Happenedspice17/sumo-v-ia/chasis/img/det_arnes.png

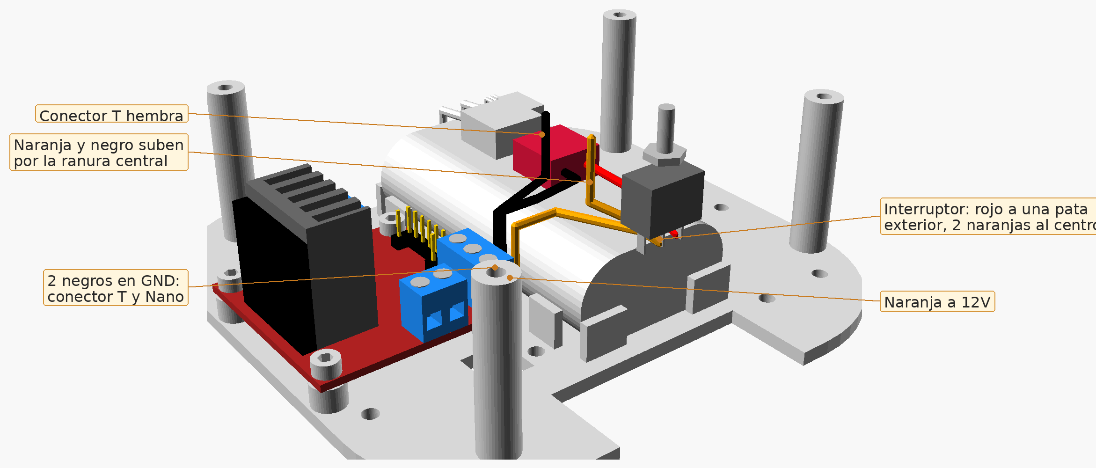
chasis/img/det_arnes.png
