Happenedspice17/sumo-v-ia/chasis/img/det_insertos.png

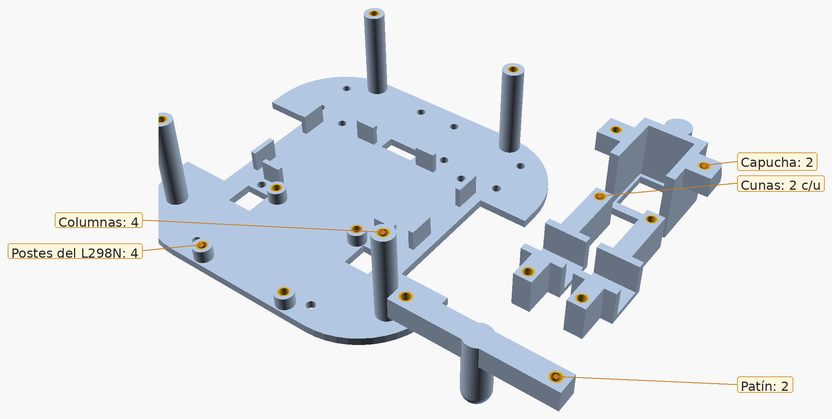
chasis/img/det_insertos.png
