Happenedspice17/sumo-v-ia/chasis/img/det_l298.png

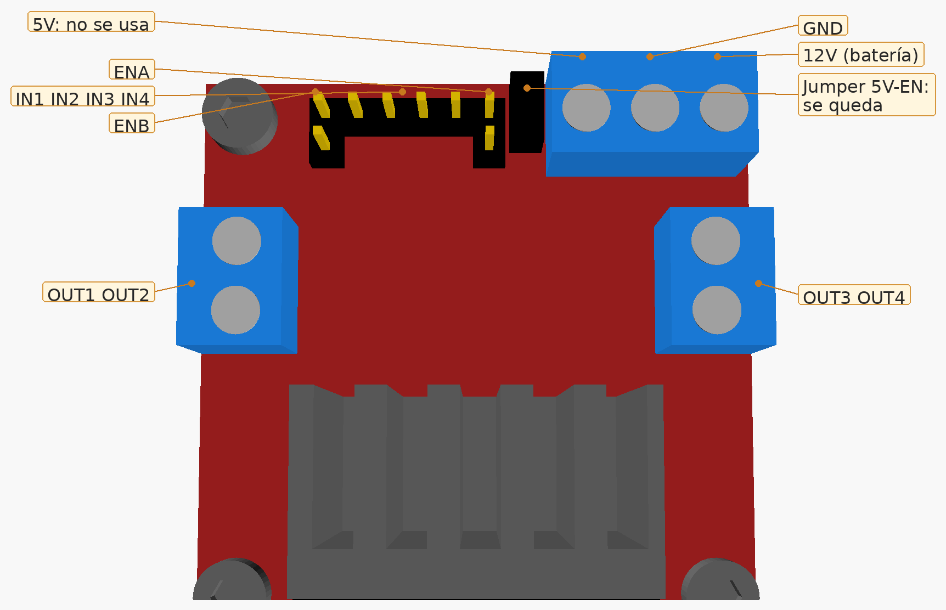
chasis/img/det_l298.png
