Happenedspice17/sumo-v-ia/chasis/img/det_q_usb.png

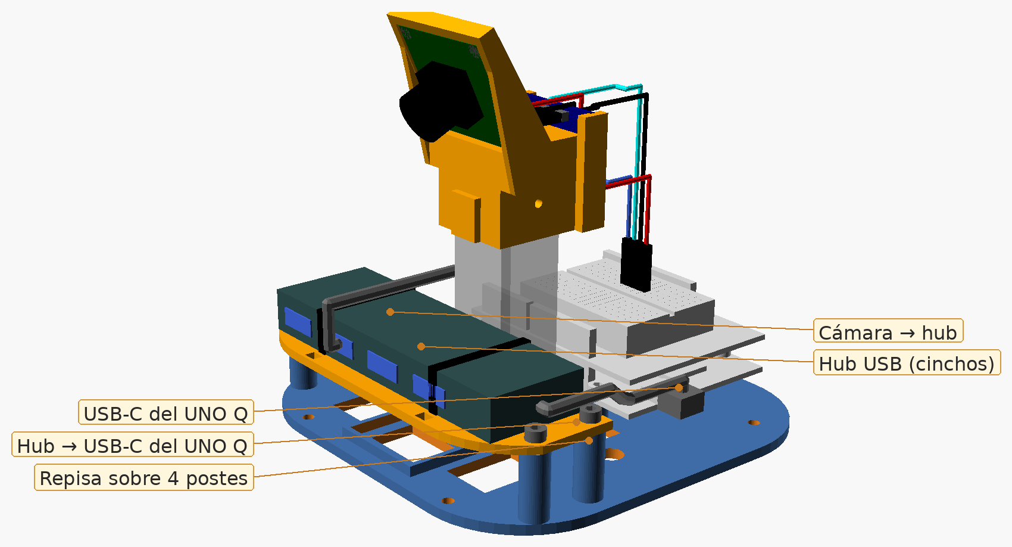
chasis/img/det_q_usb.png
