Happenedspice17/sumo-v-ia/chasis/img/det_shield.png

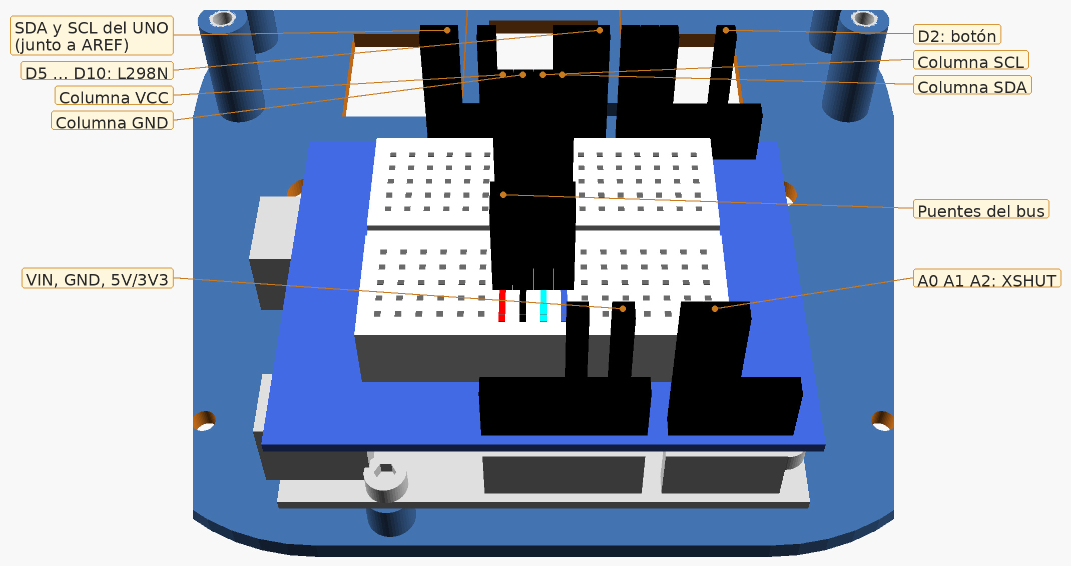
chasis/img/det_shield.png
