Happenedspice17/sumo-v-ia/chasis/img/detalle_oled.png

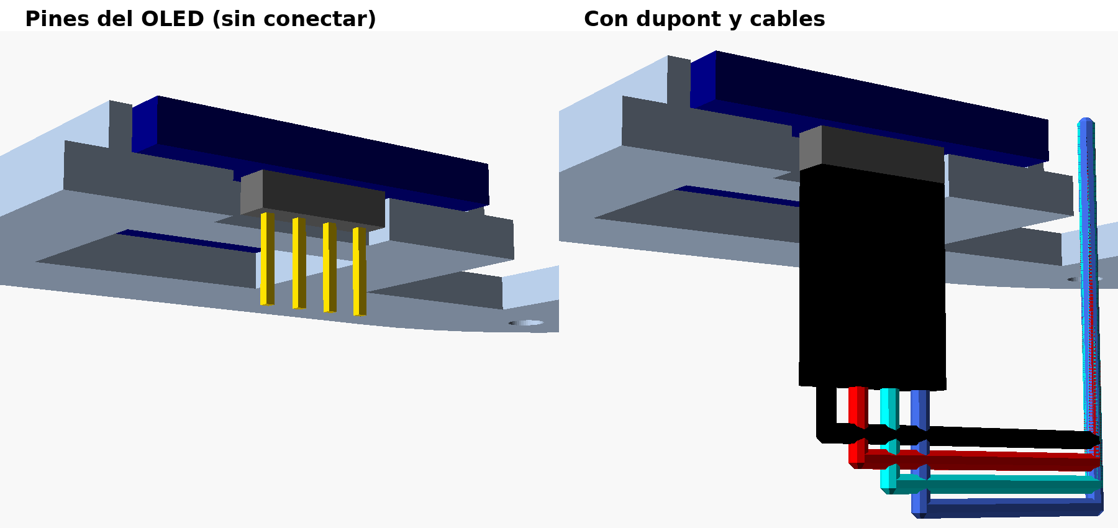
chasis/img/detalle_oled.png
