Happenedspice17/sumo-v-ia/chasis/img/fig_atras.png

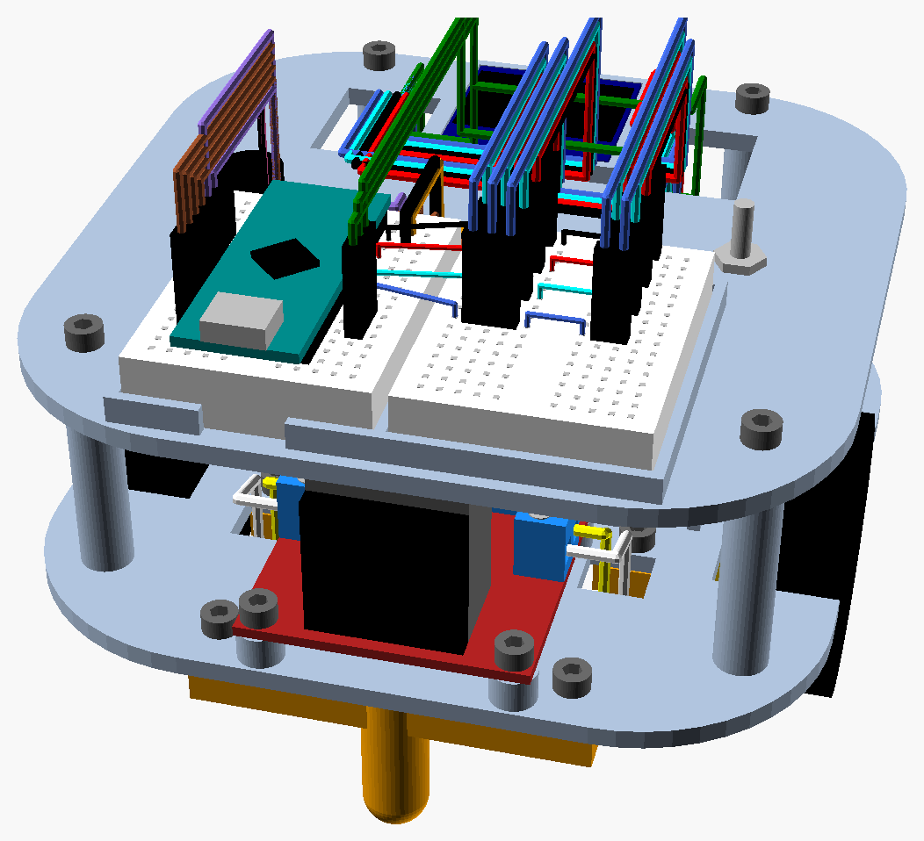
chasis/img/fig_atras.png
