Happenedspice17/sumo-v-ia/chasis/img/fig_lado.png

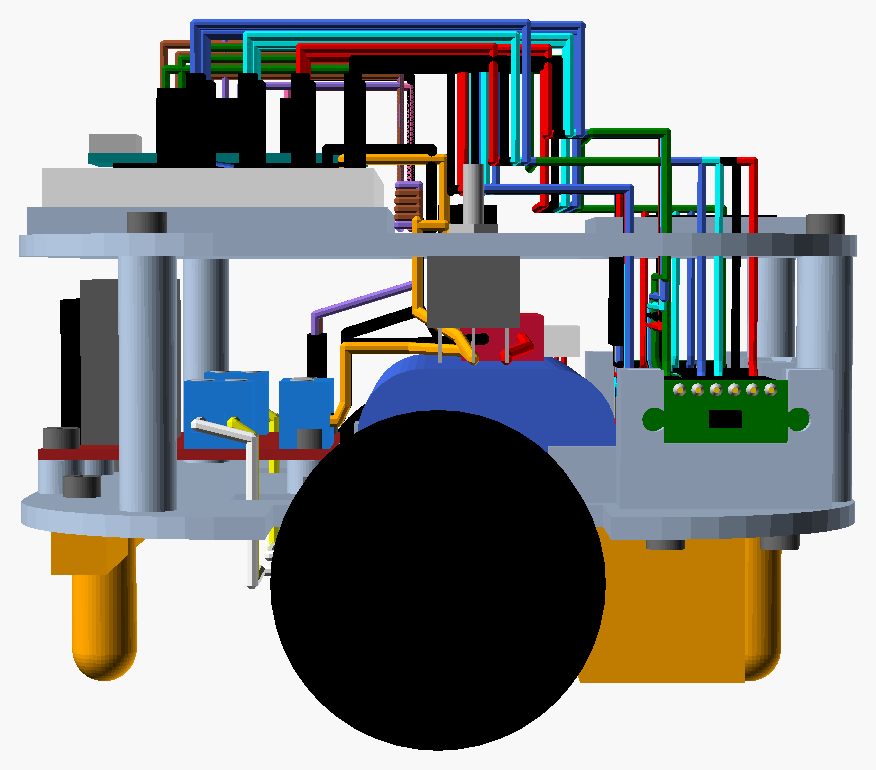
chasis/img/fig_lado.png
