Happenedspice17/sumo-v-ia/chasis/img/paso1.png

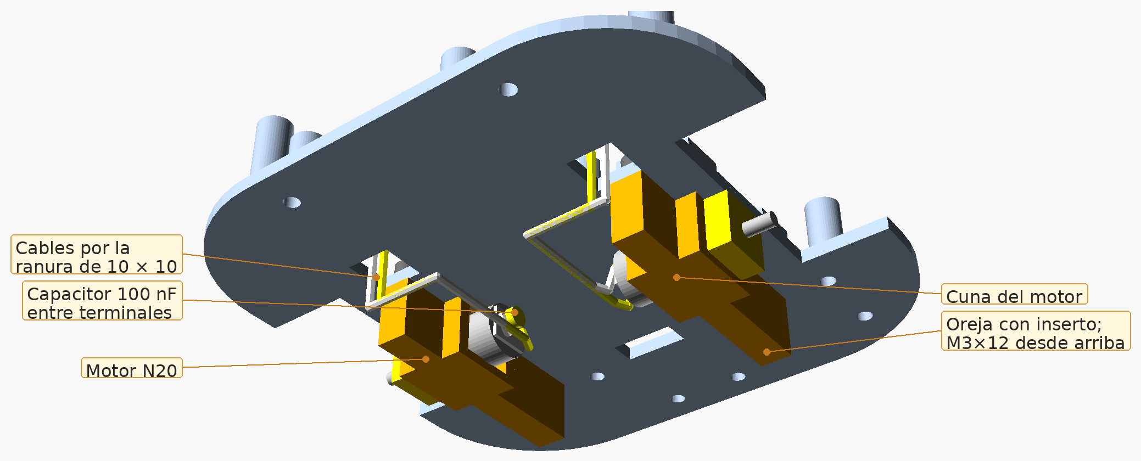
chasis/img/paso1.png
