Happenedspice17/sumo-v-ia/chasis/img/paso2.png

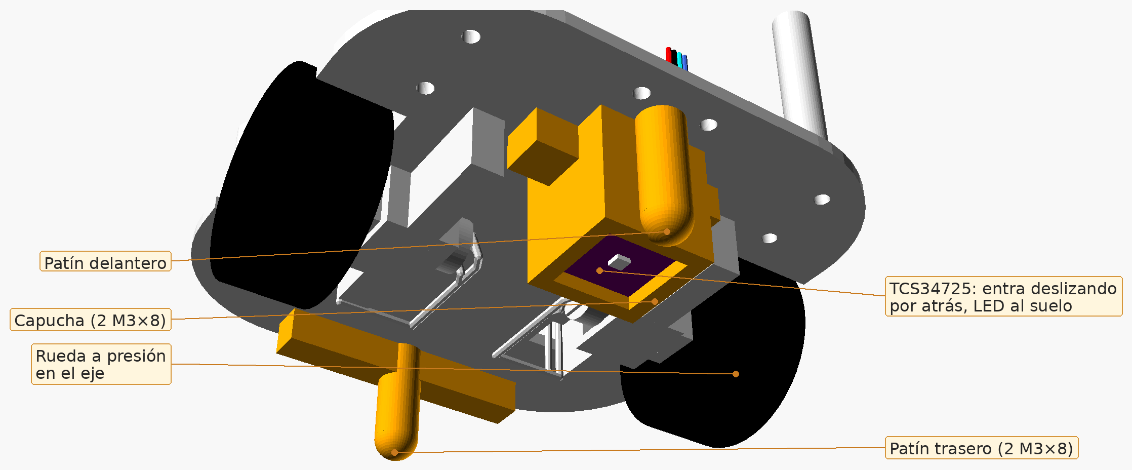
chasis/img/paso2.png
