Happenedspice17/sumo-v-ia/chasis/img/paso3.png

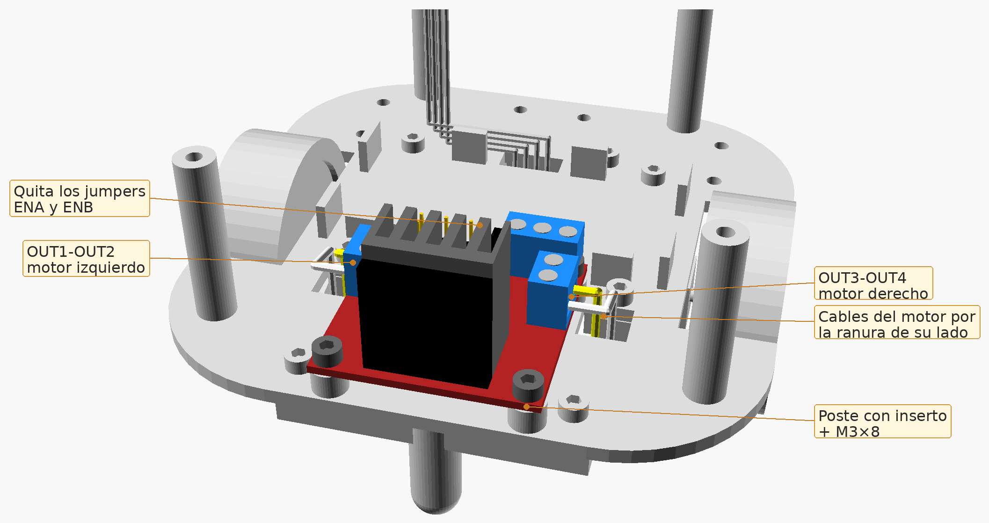
chasis/img/paso3.png
