Happenedspice17/sumo-v-ia/chasis/img/paso4.png

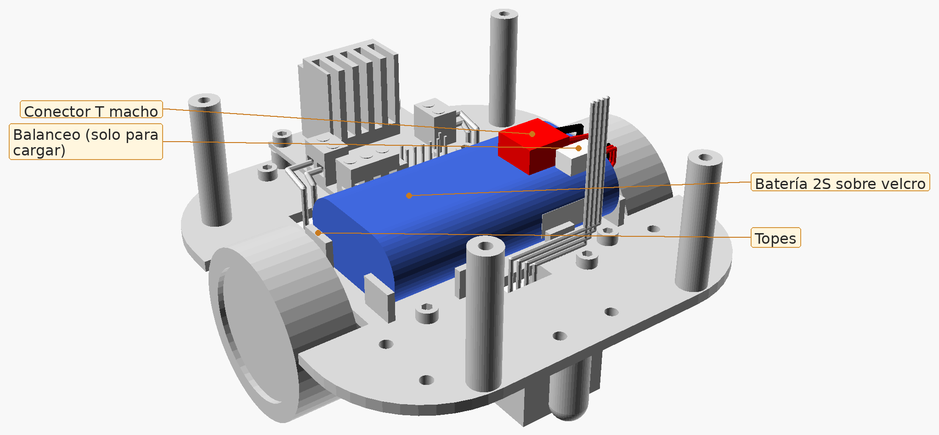
chasis/img/paso4.png
