Happenedspice17/sumo-v-ia/chasis/img/paso5.png

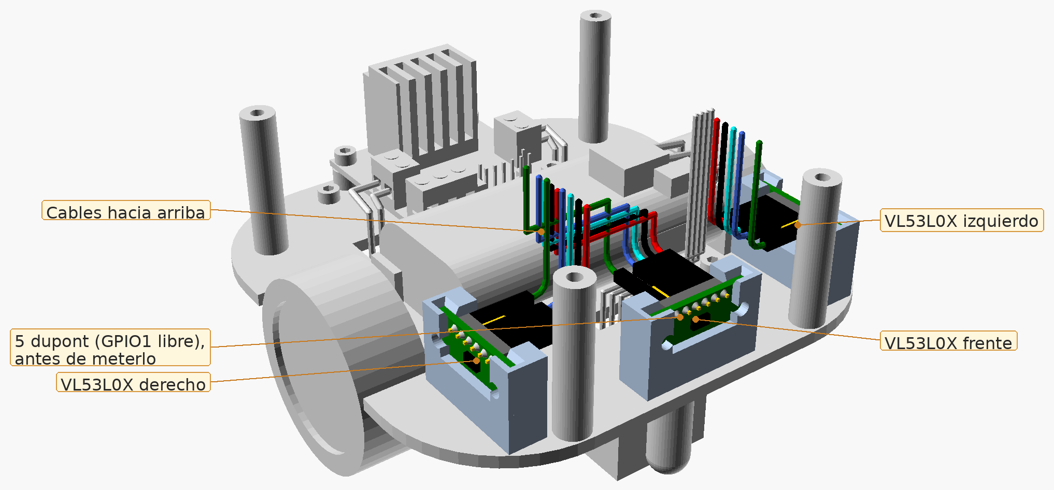
chasis/img/paso5.png
