Happenedspice17/sumo-v-ia/chasis/img/paso6.png

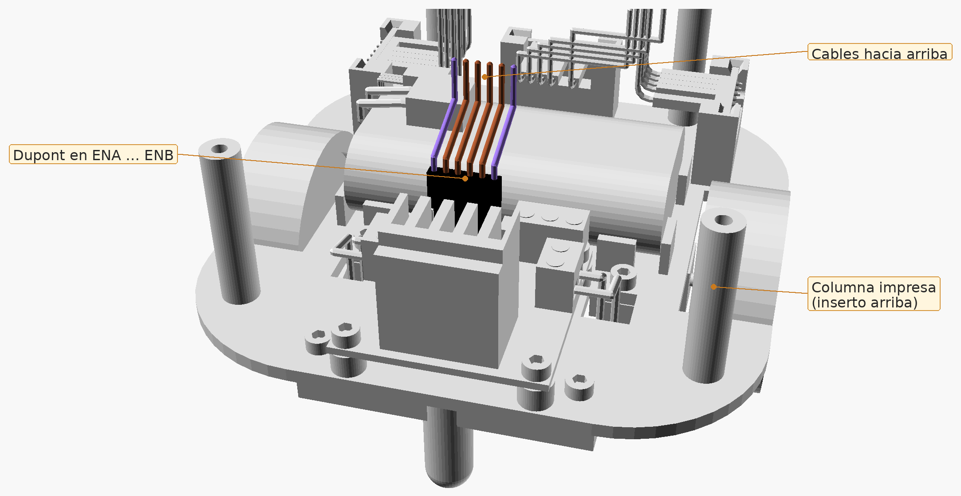
chasis/img/paso6.png
