Happenedspice17/sumo-v-ia/chasis/img/paso7.png

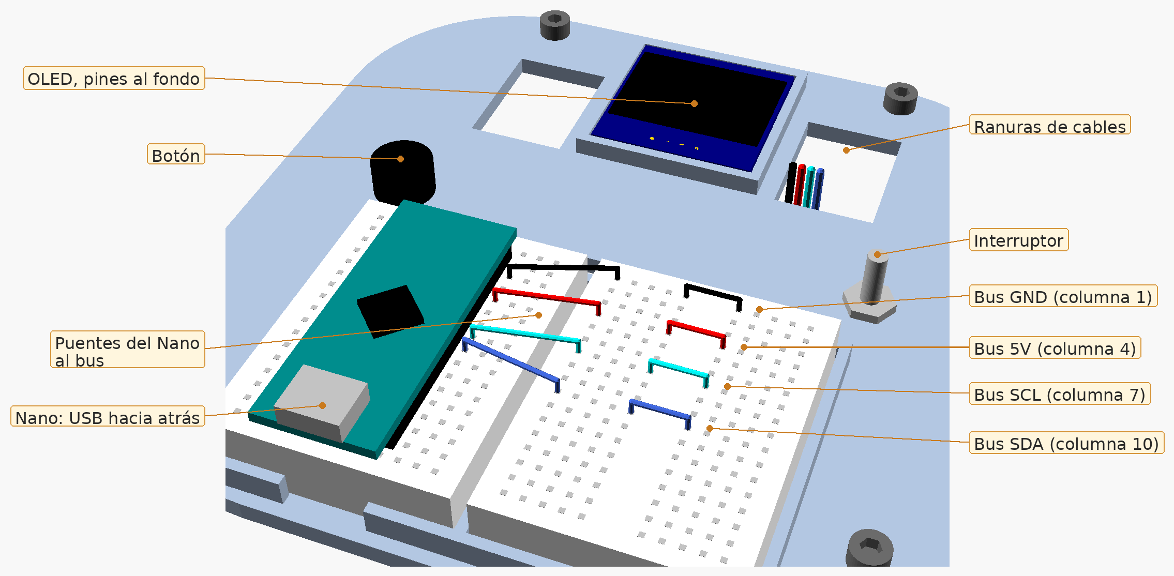
chasis/img/paso7.png
