Happenedspice17/sumo-v-ia/chasis/img/paso8.png

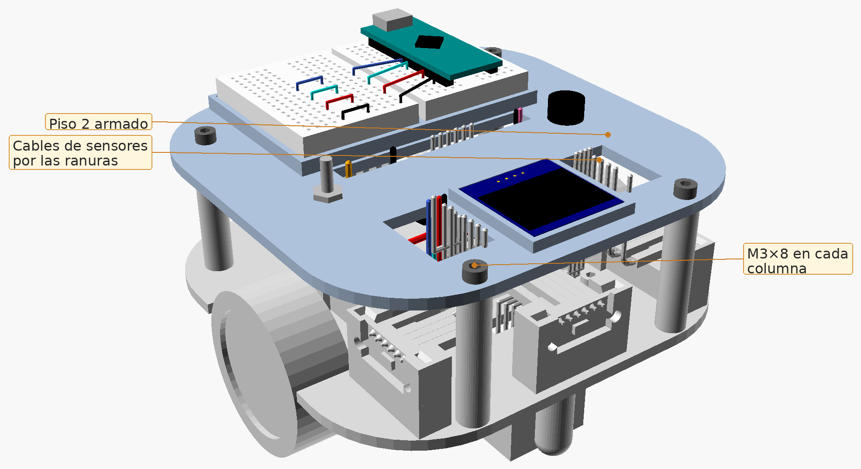
chasis/img/paso8.png
