Happenedspice17/sumo-v-ia/chasis/img/paso9.png

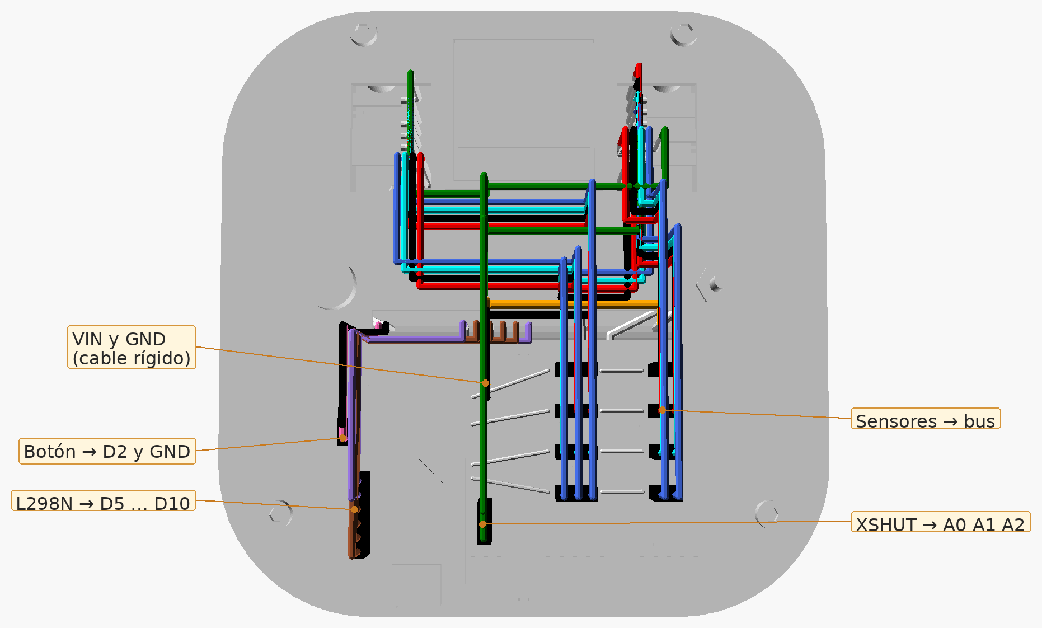
chasis/img/paso9.png
