Happenedspice17/sumo-v-ia/chasis/img/paso10.png

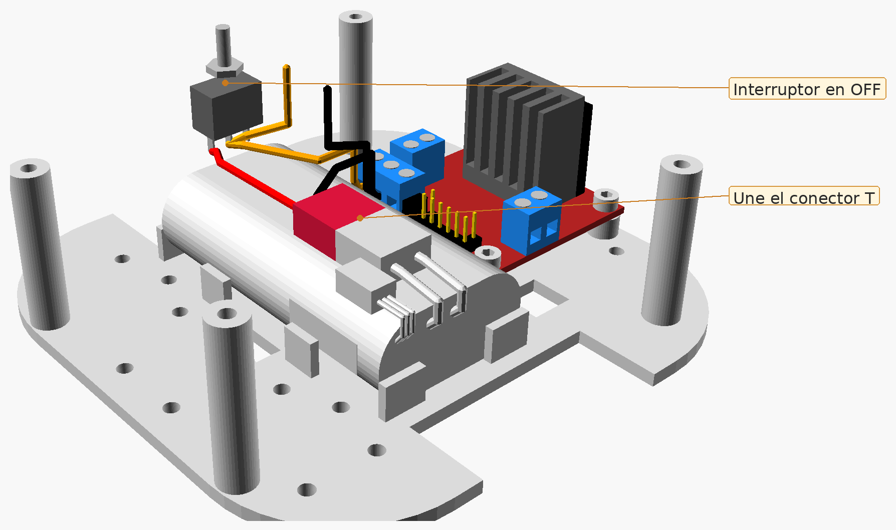
chasis/img/paso10.png
