Happenedspice17/sumo-v-ia/chasis/img/placa_x2d.png

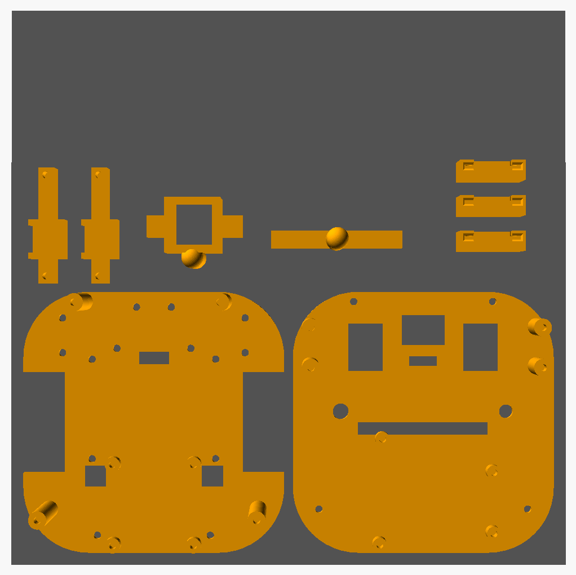
chasis/img/placa_x2d.png
