Happenedspice17/sumo-v-ia/chasis/img/q_lado.png

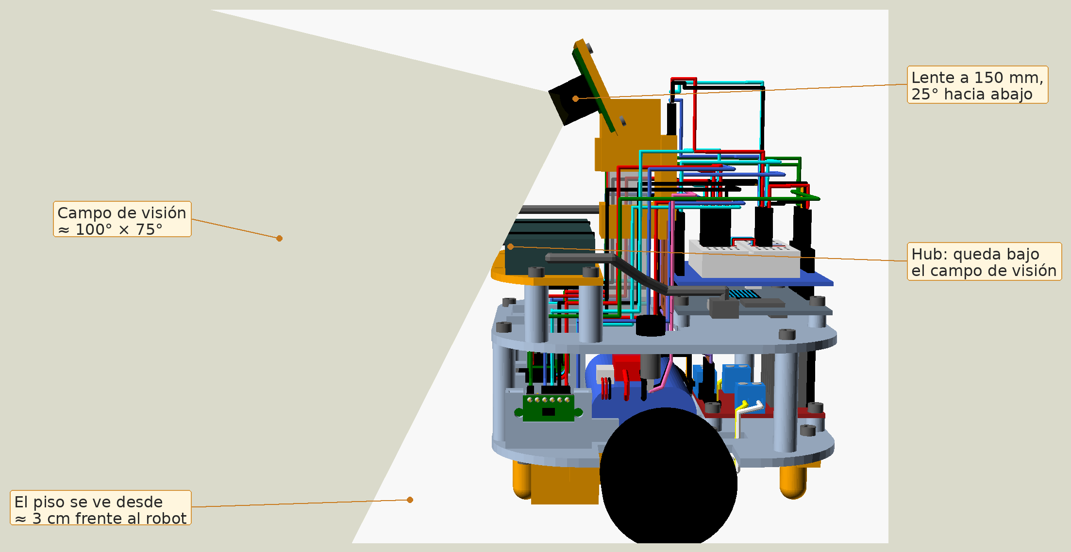
chasis/img/q_lado.png
