Happenedspice17/sumo-v-ia/chasis/img/q_paso11.png

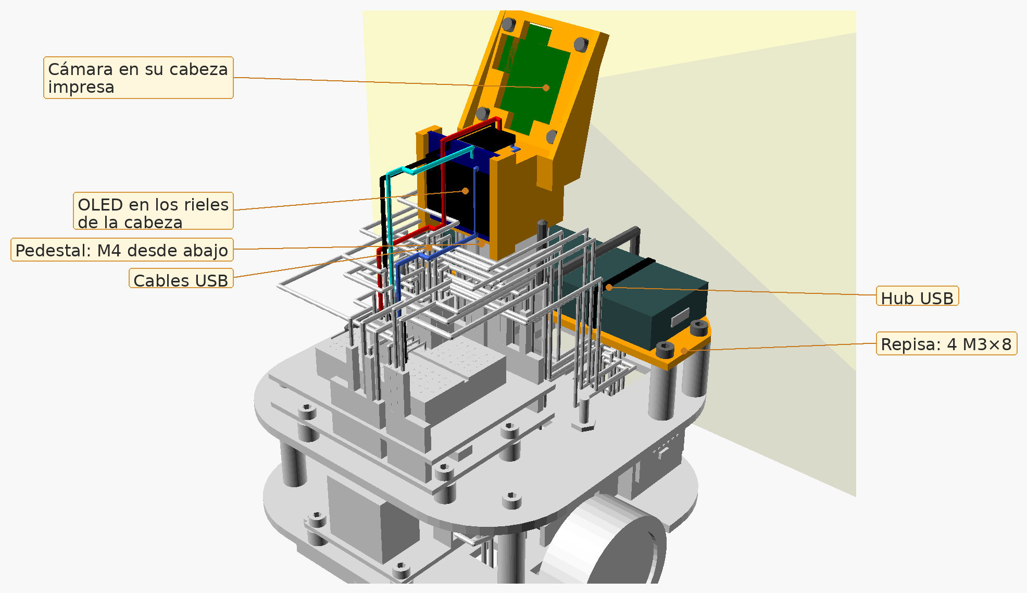
chasis/img/q_paso11.png
