Happenedspice17/sumo-v-ia/chasis/img/r3_atras.png

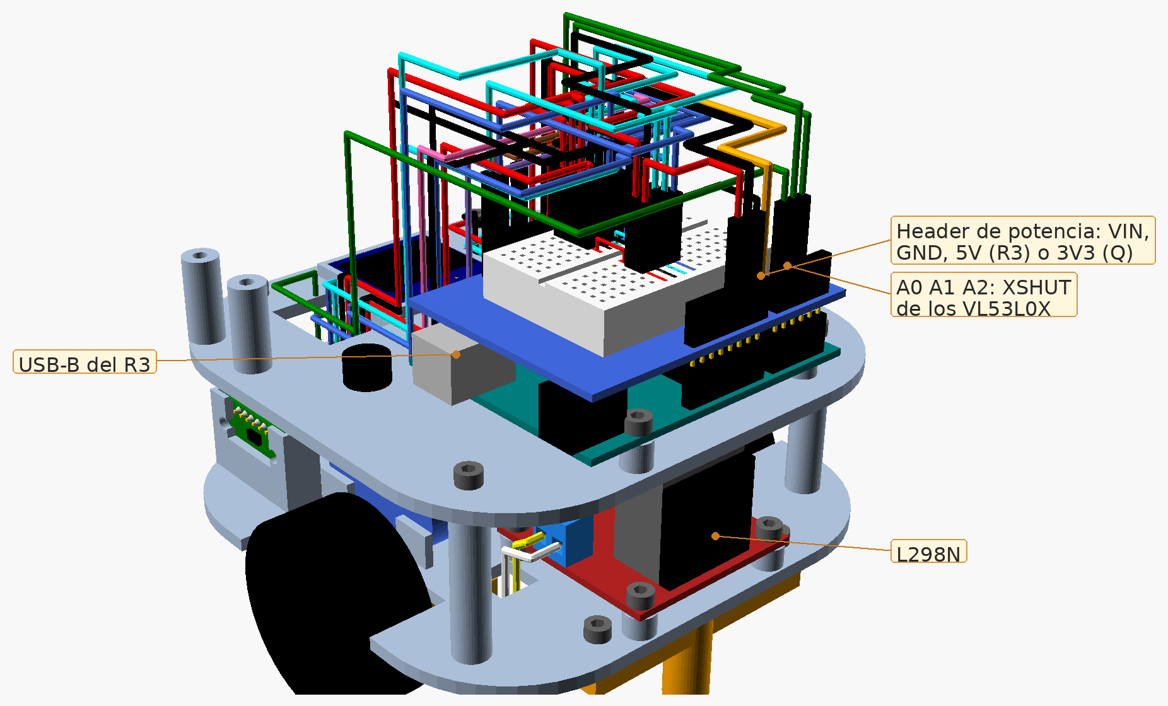
chasis/img/r3_atras.png
