Happenedspice17/sumo-v-ia/chasis/img/r3_iso.png

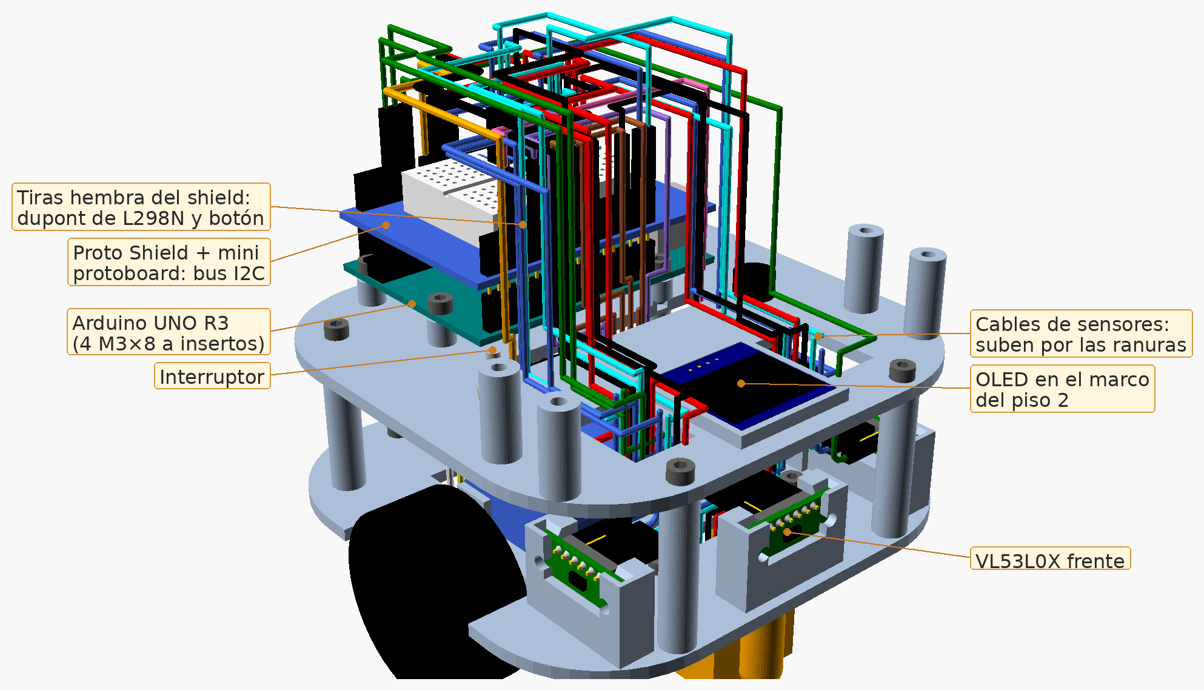
chasis/img/r3_iso.png
