Happenedspice17/sumo-v-ia/chasis/img/r3_paso7.png

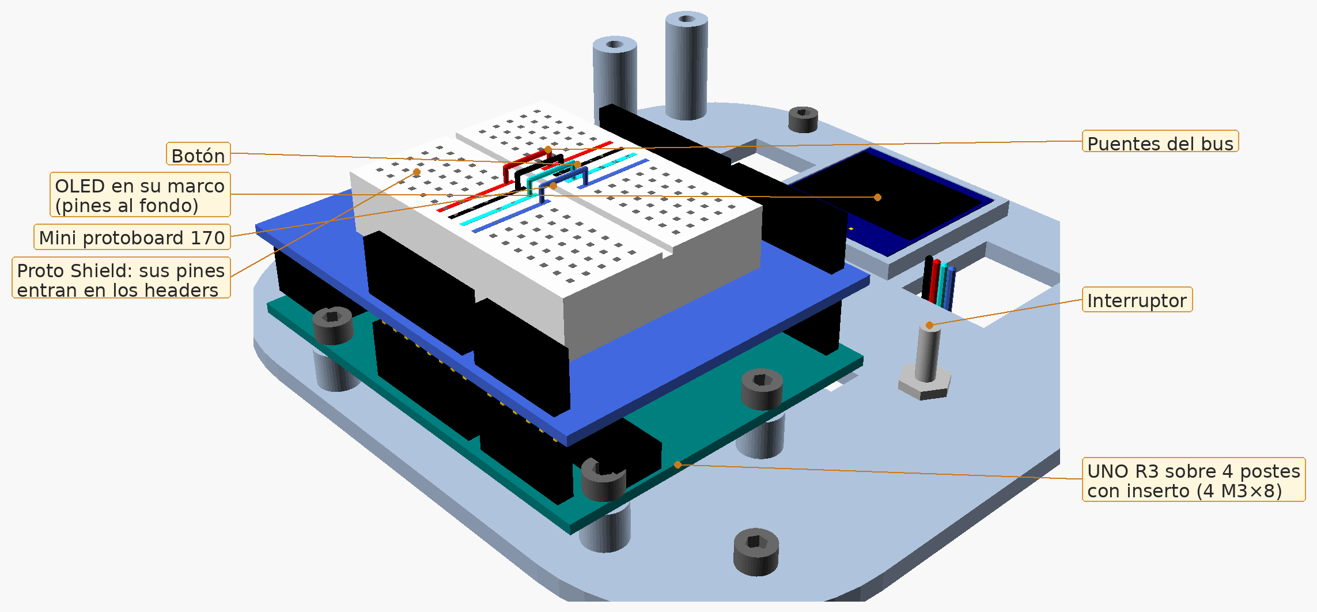
chasis/img/r3_paso7.png
