Happenedspice17/sumo-v-ia/chasis/img/r3_paso8.png

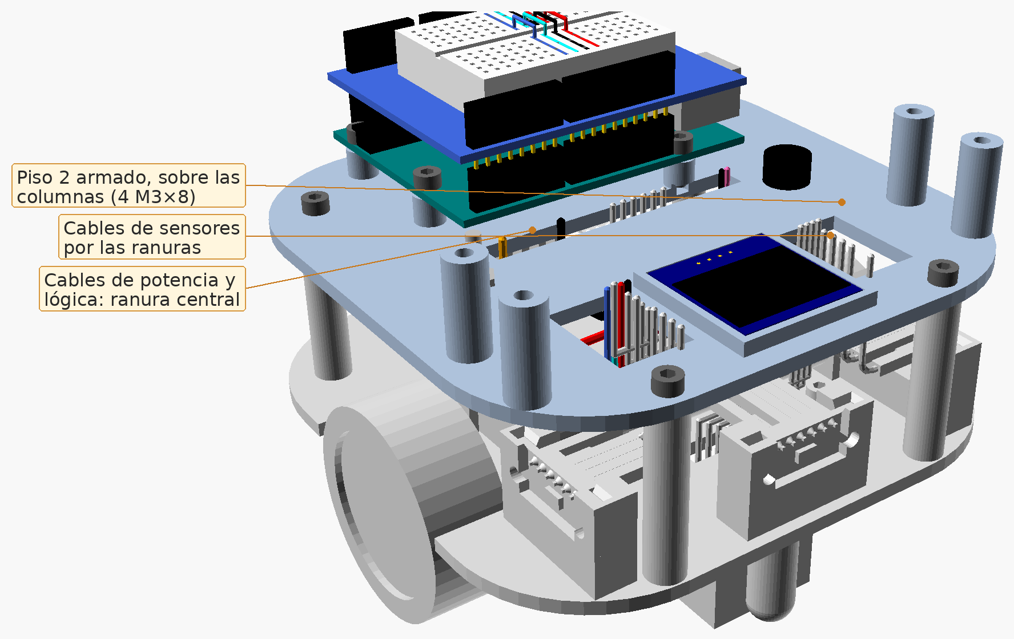
chasis/img/r3_paso8.png
