Happenedspice17/sumo-v-ia/chasis/img/r3_paso9.png

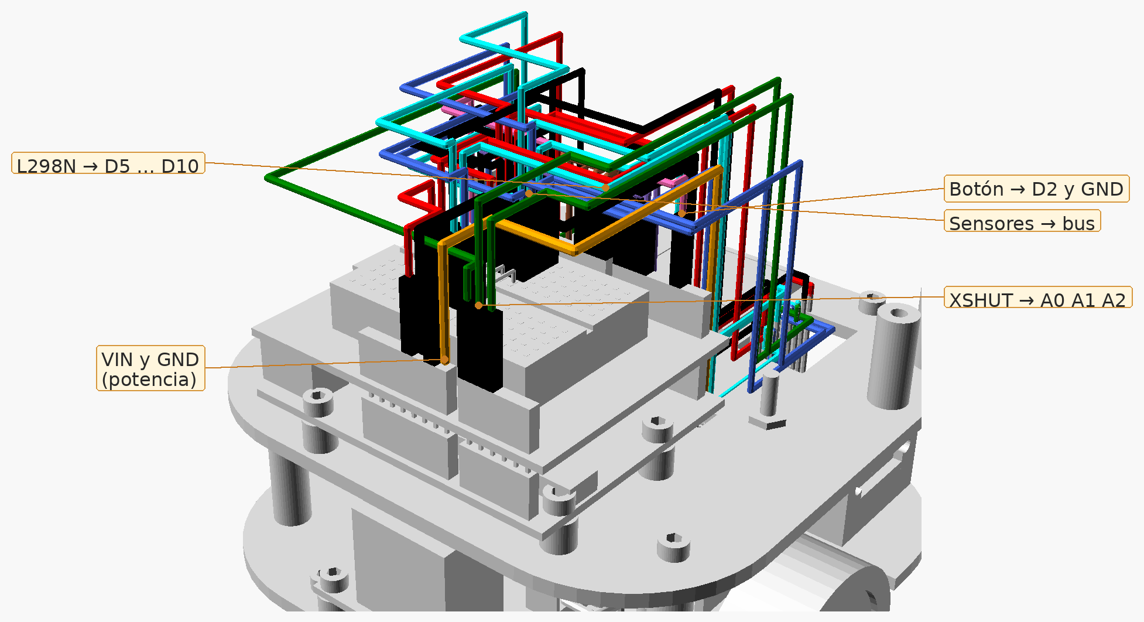
chasis/img/r3_paso9.png
