Happenedspice17/sumo-v-ia/chasis/img/r3_paso10.png

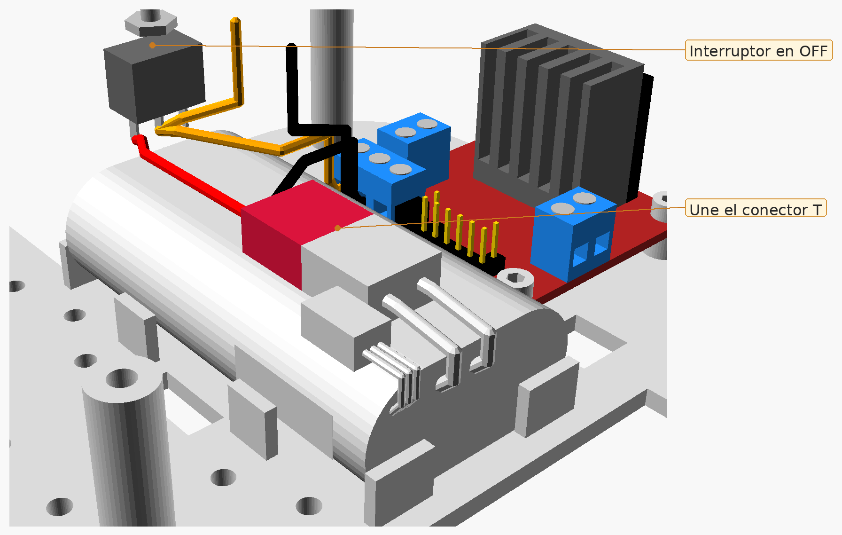
chasis/img/r3_paso10.png
