Happenedspice17/sumo-v-ia/docs/img/capturas/antes.png

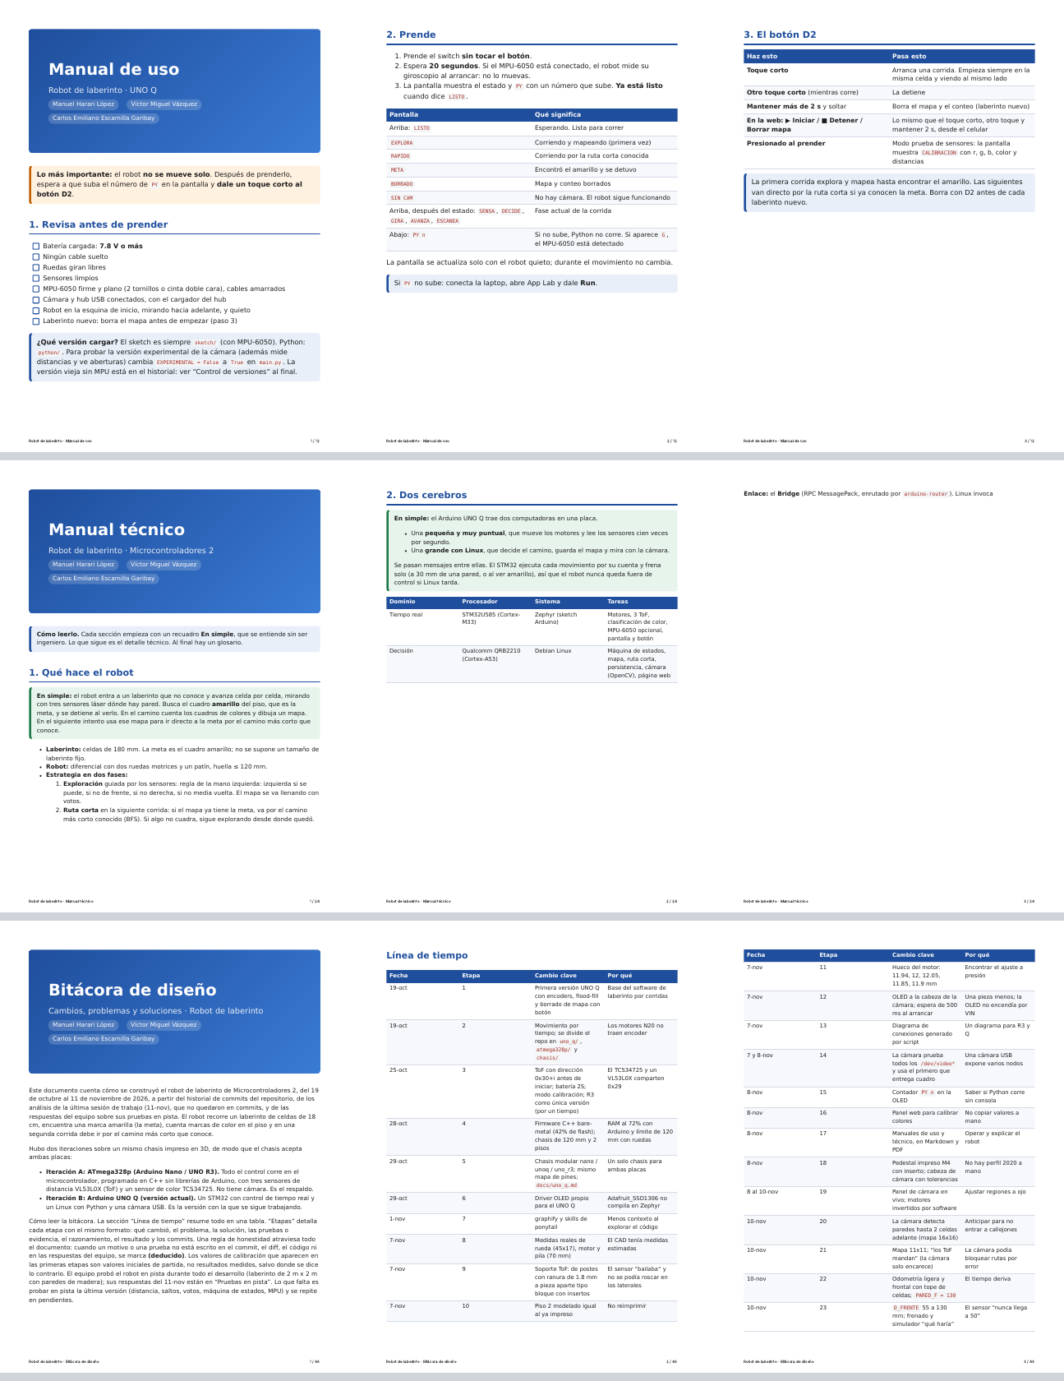
docs/img/capturas/antes.png
