Happenedspice17/sumo-v-ia/docs/img/capturas/despues.png

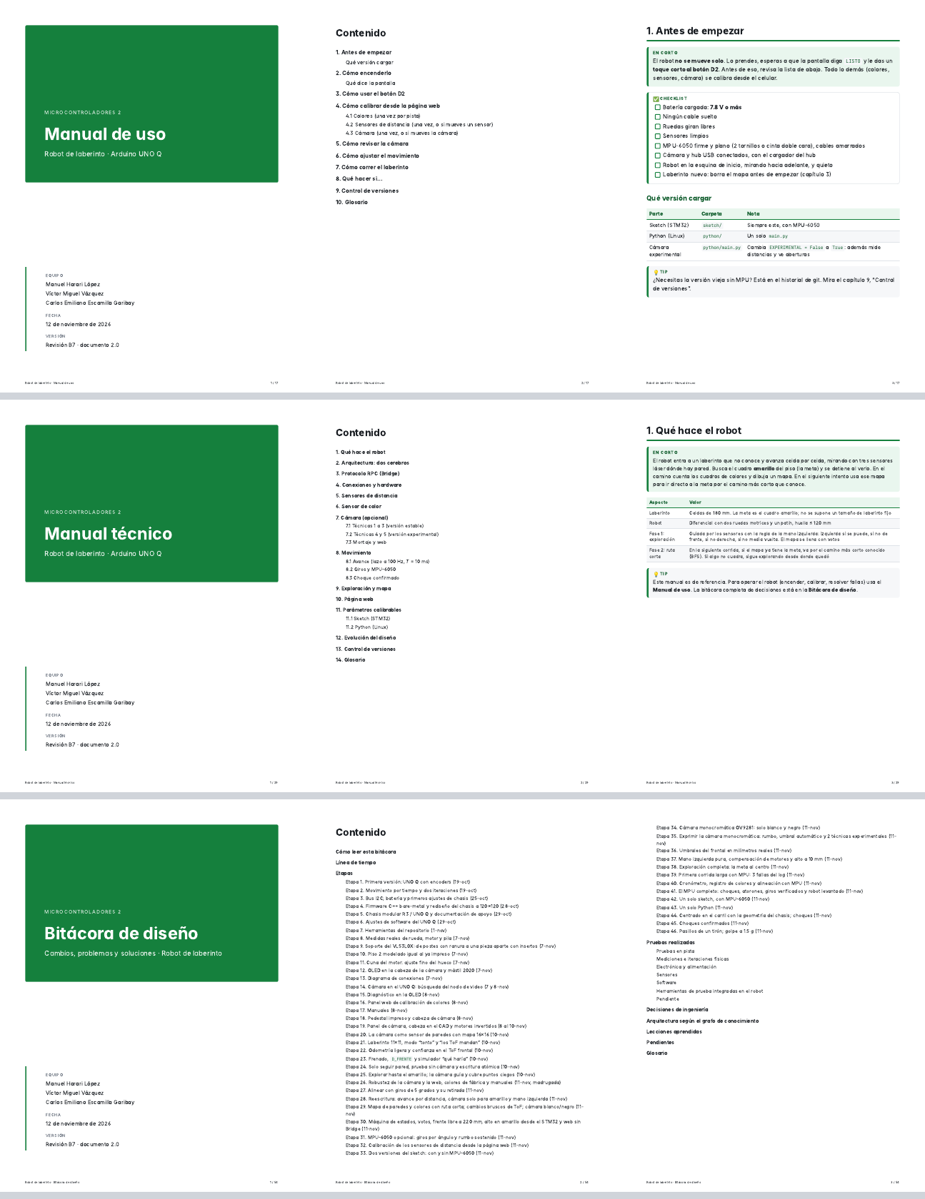
docs/img/capturas/despues.png
