Happenedspice17/sumo-v-ia/docs/img/pista_foto.jpg

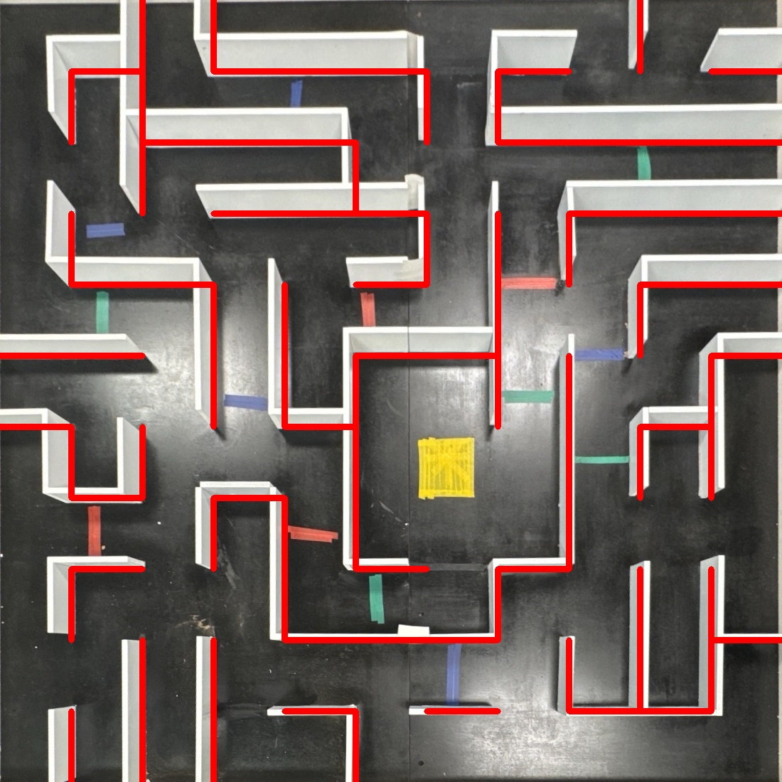
docs/img/pista_foto.jpg
