Happenedspice17/sumo-v-ia/docs/bom.csv

Categoria | Componente | Especificacion / donde va | Cantidad
Impresa 3D | Piso 1 (base, columnas, postes del L298N, soportes de VL53L0X y topes) | PETG o PLA | 1
Impresa 3D | Piso 2 (marco del OLED, alojamiento de la placa, botón, interruptor, agujero M5 del pedestal) | PETG o PLA | 1
Impresa 3D | Cuna de motor | PETG o PLA | 2
Impresa 3D | Capucha del sensor de color con patín delantero | PLA negro | 1
Impresa 3D | Patín trasero | PETG o PLA | 1
Impresa 3D | Soporte de VL53L0X (se cambia solo si se rompe) | PLA negro | 3
Impresa 3D | Pieza de prueba de tolerancias | El mismo de las demás | 1
Impresa 3D | Repisa del hub USB (solo Q) | PETG o PLA | 1
Impresa 3D | Cabeza de cámara con rieles del OLED (solo Q) | PETG o PLA | 1
Impresa 3D | Pedestal 20 × 20 × 75 mm (solo Q) | PETG o PLA | 1
Electronica | Arduino UNO R3 (ATmega328P) | Placa oficial y de respaldo; cable USB-B de datos | 1
Electronica | Arduino UNO Q (solo Q) | Placa principal; cable USB-C de datos | 1
Electronica | Proto Shield comercial | Con mini protoboard de 170 puntos; va sobre la placa | 1
Electronica | Motorreductor N20 | 6 V, 300–500 RPM, sin encoder | 2
Electronica | Rueda para N20 | Ø45 × 17 mm, eje D de 3 mm | 2
Electronica | Puente H L298N | Módulo rojo 43 × 43 mm con disipador | 1
Electronica | Sensor de color TCS34725 | Módulo morado 20.5 × 20.5 mm | 1
Electronica | Sensor de distancia VL53L0X | CJVL53L0XV2, 25 × 10.7 mm | 3
Electronica | Pantalla OLED SSD1306 | 0.96", I2C, dirección 0x3C, 4 pines | 1
Electronica | MPU-6050 (módulo GY-521) | Giroscopio y acelerómetro I2C, dirección 0x68 (AD0 a GND), VCC 3.3 V; plano y atornillado al piso | 1
Electronica | Botón de panel | Ø7 mm, normalmente abierto | 1
Electronica | Interruptor de palanca | MTS-102, Ø6 mm | 1
Electronica | Batería 2S 18650 | 7.4 V, 3000 mAh, conector T y balanceo JST-XH | 1
Electronica | Conector T (Deans) hembra | Con 10 cm de cable calibre 14–16 | 1
Electronica | Cargador balanceador 2S | Entrada JST-XH de 3 pines | 1
Electronica | Fusible de 3 A con portafusible | En el positivo, después del interruptor | 1
Electronica | Capacitor cerámico | 100 nF (104) | 2
Electronica | Header macho recto | 2.54 mm, tira de 40 (los rectos de siempre) | 1
Electronica | Cámara USB innomaker U20CAM-9281M (solo Q) | OV9281 monocromática 1 MP, obturador global, UVC, lente M12 gran angular; medidas de la placa por confirmar | 1
Electronica | Cable USB-C corto en ángulo recto (solo Q) | Del hub a la entrada USB-C de la UNO Q | 1
Electronica | Hub USB-C con entrada PD (solo Q) | USB-C macho, 1 USB-A de datos y entrada de alimentación | 1
Electronica | Inserto de calor M4 + tornillo M4 × 12 (solo Q) | Pedestal al piso 2, desde abajo | 1
Electronica | Módulo fuente USB-C PD, opcional (solo Q) | Entrada desde 6 V, salida 5 V / 3 A; solo si falla la prueba sin PD (sección 6.4) | 1
Cables | Dupont hembra-macho 30 cm | VL53L0X (3 × 5), OLED (4), L298N lógica (6) + 2 de repuesto | 27
Cables | Dupont macho-macho 30 cm | Se les corta un extremo: TCS34725 (4) y botón (2) | 6
Cables | Cable calibre 22 de silicón, rojo, negro, amarillo, blanco y naranja | Motores, interruptor, batería y placa | 1 m en total por color
Cables | Jumpers rígidos | Puentes del bus en la protoboard del shield y del bus a la placa | 8
Cables | Cinchos chicos y termofit de 3 mm | Ordenar cables y aislar soldaduras (la Q usa 2 más para el hub) | 12 / 30 cm
Cables | Cinta aislante | Sobre el USB-B del R3, bajo el shield | 1
Tornilleria | Inserto de calor M3 (latón) | Comunes: columnas (4) y postes del L298N (4) del piso 1, cunas (4), capucha (2), patín (2), soportes de VL53L0X (6), placa en el piso 2 (4). Solo Q: repisa (4) | 26 (+4 solo Q)
Tornilleria | Tornillo Allen M3 × 8 | Comunes: L298N (4), piso 2 (4), placa (4), capucha (2), patín (2), soportes de VL53L0X (6), VL53L0X (6). Solo Q: repisa (4) | 28 (+4 solo Q)
Tornilleria | Tornillo Allen M3 × 12 | Cunas de motor | 4
Tornilleria | Tornillo M2 + tuerca y rondana | Cámara en su cabeza (tuerca atrás) | 4 (solo Q)
Tornilleria | Tornillo M3 opresor | Cabeza contra el pedestal | 1 (solo Q)
Tornilleria | Velcro adhesivo 3 × 5 cm | Bajo la batería | 1
