Happenedspice17/sumo-v-ia/chasis/stl/cabeza_camara.stl

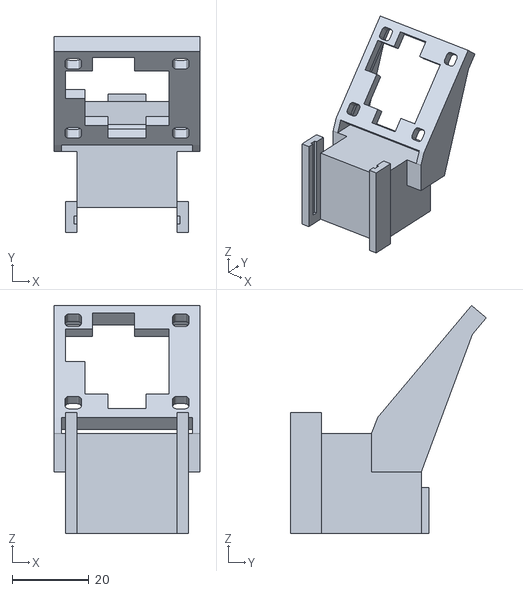
[picture p40: CAD file, 2026-11-11]
chasis/stl/cabeza_camara.stl
38.0 x 50.9 x 59.4
