Happenedspice17/sumo-v-ia/chasis/stl/pedestal.stl

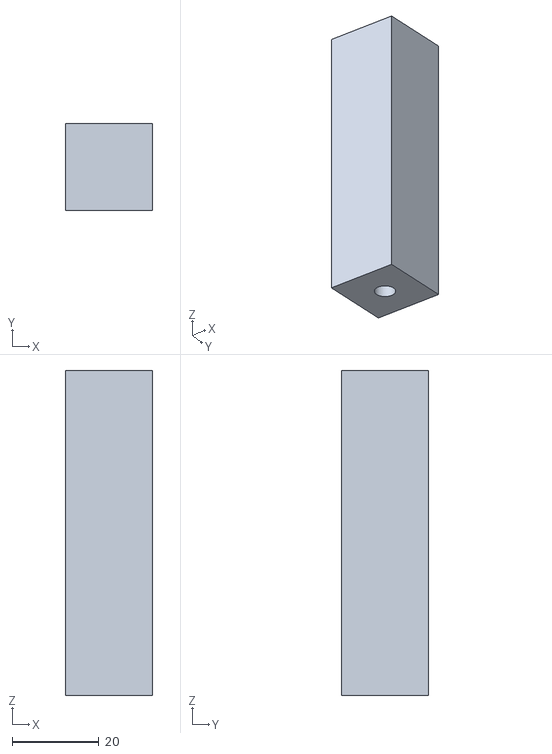
[picture p41: CAD file, 2026-11-08]
chasis/stl/pedestal.stl
20.0 x 20.0 x 75.0
