Happenedspice17/sumo-v-ia/chasis/stl/cuna_motor.stl

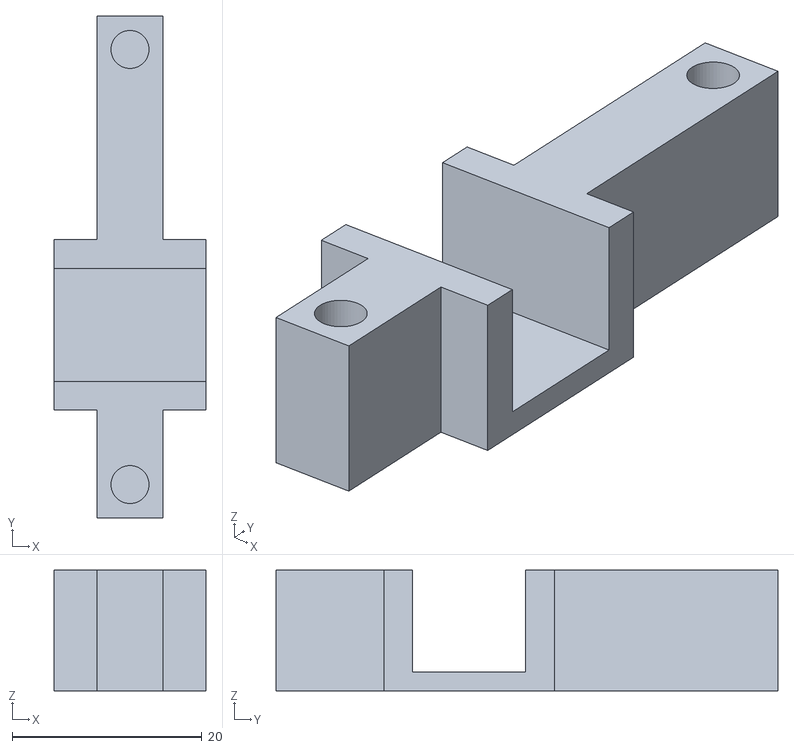
[picture p42: CAD file, 2026-11-08]
chasis/stl/cuna_motor.stl
16.0 x 52.8 x 12.7
