Happenedspice17/sumo-v-ia/chasis/stl/soporte_tof.stl

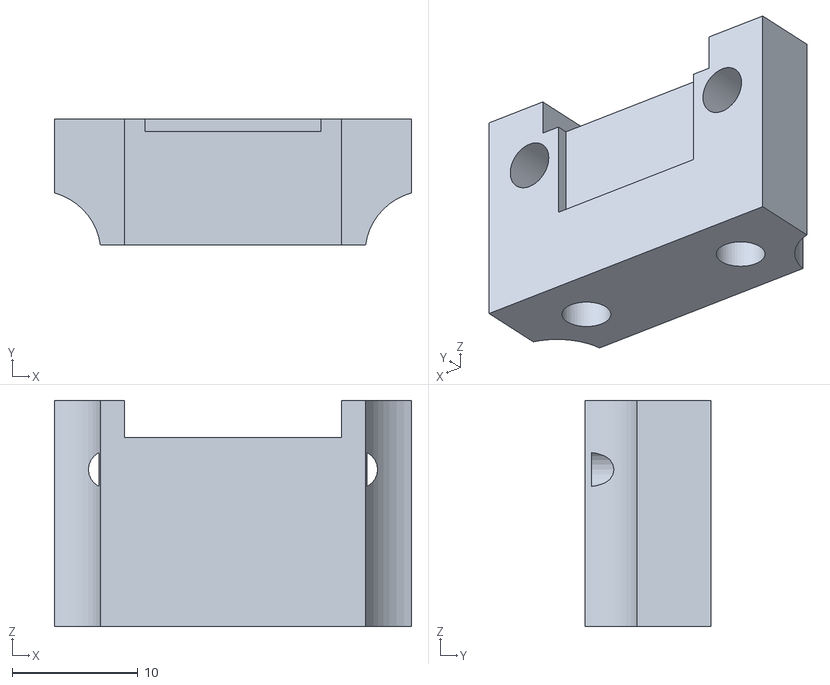
[picture p43: CAD file, 2026-11-08]
chasis/stl/soporte_tof.stl
28.4 x 10.0 x 18.0
