Happenedspice17/sumo-v-ia/chasis/stl/piso2.stl

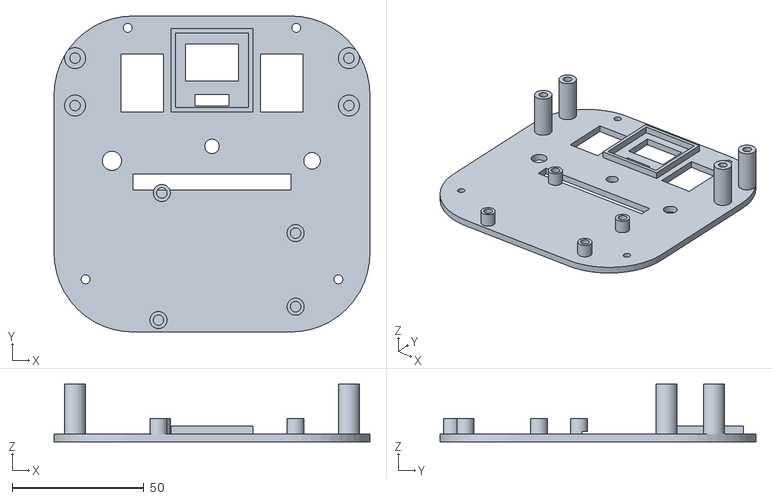
[picture p44: CAD file, 2026-11-08]
chasis/stl/piso2.stl
120.0 x 120.0 x 22.0
