Happenedspice17/sumo-v-ia/chasis/stl/piso1.stl

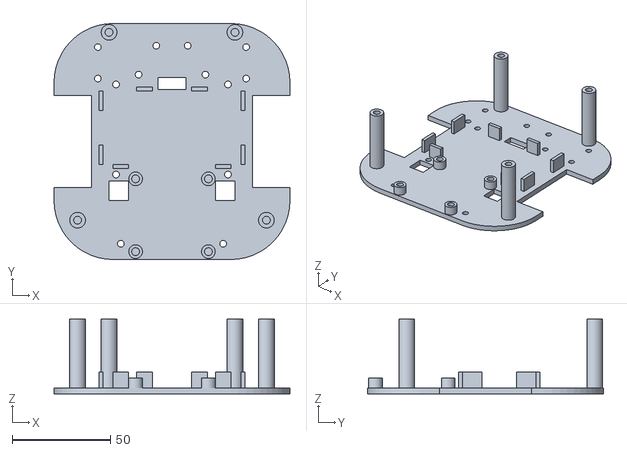
[picture p45: CAD file, 2026-11-08]
chasis/stl/piso1.stl
120.0 x 120.0 x 38.0
