Happenedspice17/sumo-v-ia/chasis/stl/repisa.stl

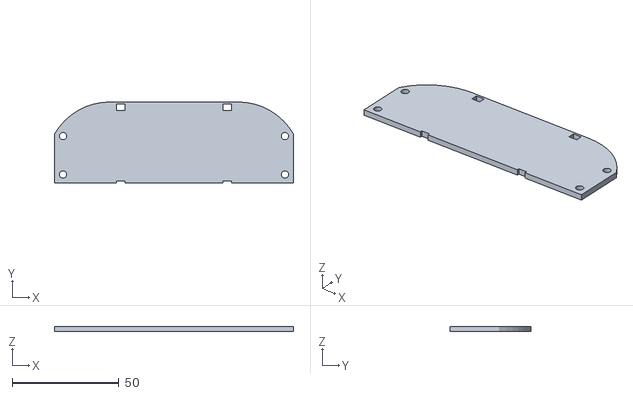
[picture p46: CAD file, 2026-11-08]
chasis/stl/repisa.stl
112.0 x 38.0 x 2.50
