Happenedspice17/sumo-v-ia/chasis/stl/capucha_color.stl

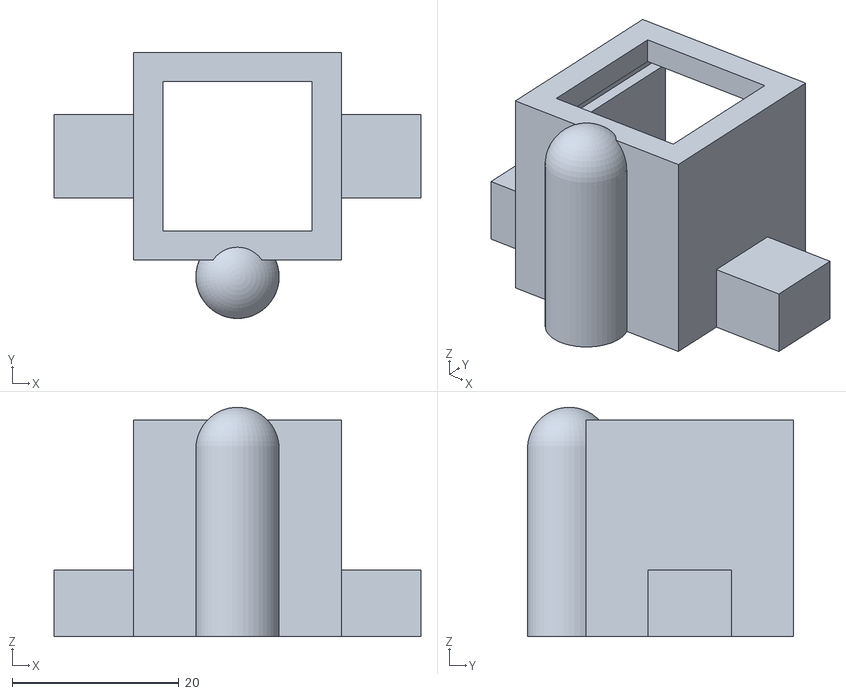
[picture p47: CAD file, 2026-11-07]
chasis/stl/capucha_color.stl
44.0 x 31.9 x 27.5
