Happenedspice17/sumo-v-ia/chasis/stl/prueba.stl

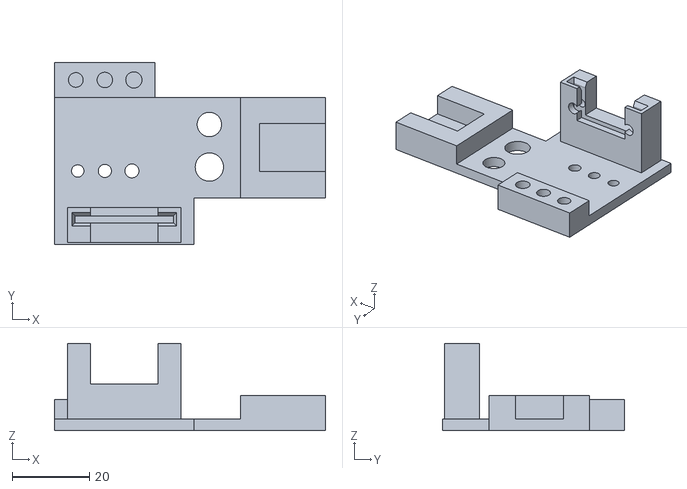
[picture p48: CAD file, 2026-11-07]
chasis/stl/prueba.stl
70.0 x 47.0 x 22.5
