Happenedspice17/sumo-v-ia/chasis/stl/placa_q.stl

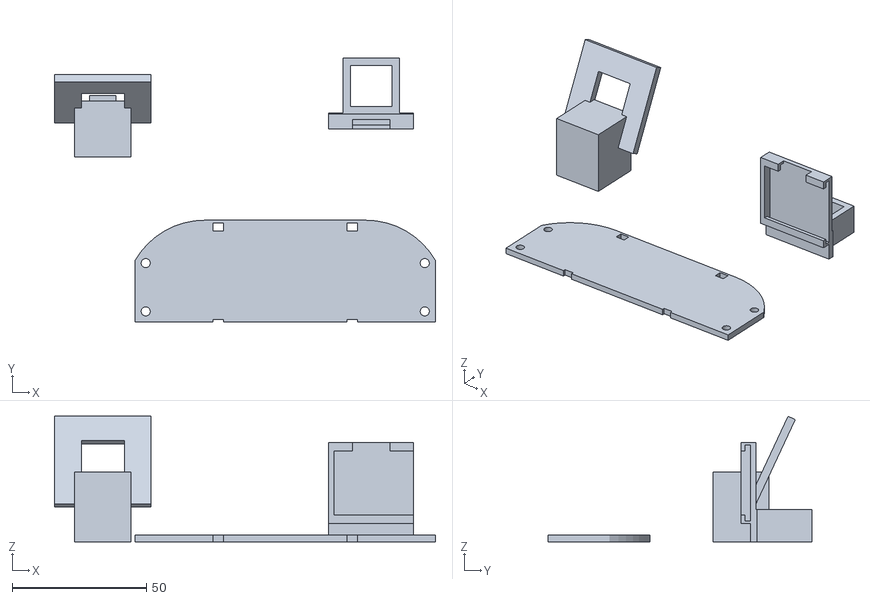
[picture p49: CAD file, 2026-11-07]
chasis/stl/placa_q.stl
142.0 x 98.5 x 46.8
