Happenedspice17/sumo-v-ia/chasis/stl/patin.stl

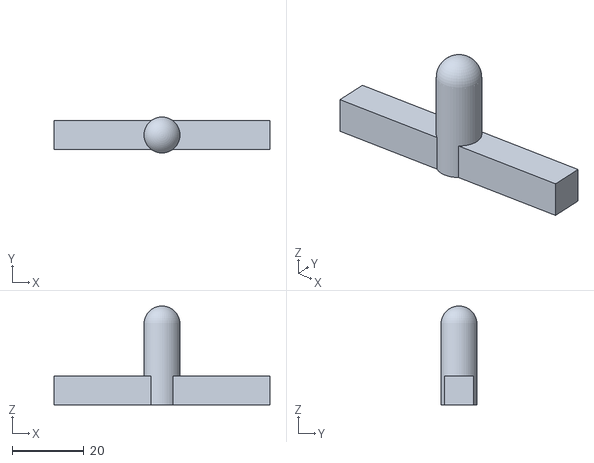
[picture p50: CAD file, 2026-11-07]
chasis/stl/patin.stl
60.0 x 10.0 x 27.5
