Happenedspice17/sumo-v-ia/chasis/stl/placa_x2d.stl

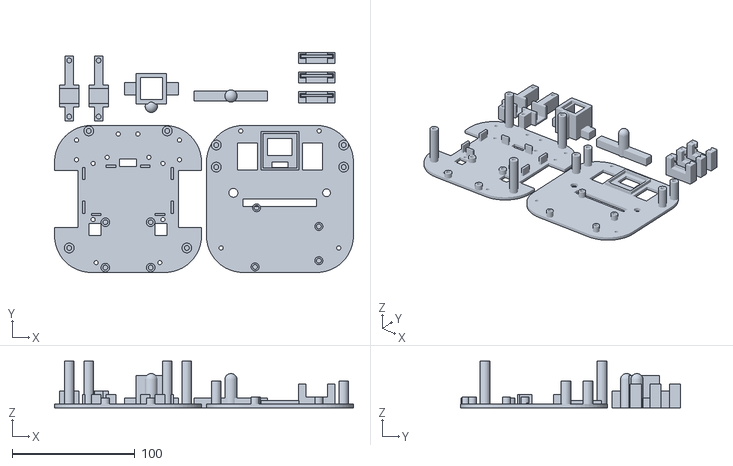
[picture p51: CAD file, 2026-11-07]
chasis/stl/placa_x2d.stl
244.0 x 179.5 x 38.0
