Happenedspice17/sumo-v-ia/chasis/chasis.scad

// Chasis robot laberinto (Arduino Nano / ATmega328P) - 120 x 120 mm con ruedas
// Origen: centro del eje de las ruedas, a nivel del piso. X derecha, Y adelante, Z arriba.
//
// PLACA: "uno_r3" (por defecto), "unoq" (UNO Q) o "nano" (version vieja). Con UNO R3 y UNO Q todas las piezas
//        impresas son las mismas; la Q solo AGREGA mastil + camara, repisa + hub y el clip del OLED.
// PIEZA: "ensamble", "piso1", "piso2", "cuna_motor", "capucha_color", "patin", "soporte_tof" (x3), "prueba",
//        "placa" (piezas comunes acomodadas en la cama de la X2D), "placa_vista" (igual, con la cama),
//        "repisa", "cabeza_camara", "clip_oled", "placa_q" (piezas solo de la Q en la cama), "placa_q_vista",
//        "sub_piso2" (piso 2 armado en la mesa), "det_insertos", "det_motor", "det_l298", "det_shield",
//        "det_q_usb", "marca" (esfera en MARCA)
// PASO:  1-11 muestra el ensamble hasta ese paso; lo de pasos anteriores sale en gris. 0 = completo a color
//        (UNO: 7 piso 2 en la mesa, 8 montaje + potencia, 9 cableado en el shield, 10 conector T, 11 solo Q)
//
// Los sensores se insertan sin tornillos:
//   VL53L0X: header recto, pines hacia adentro; bajan por las ranuras de su soporte en el piso 1.
//   TCS34725: entra deslizando por atras de la capucha; sus cables suben por dentro de ella
//   OLED: se acuesta en su marco del piso 2 con los pines hacia abajo
//   Protoboards: entran en su marco del piso 2
// Tornilleria: solo Allen M3 de 8 y 12 mm (cabeza 5.5 x 3) e insertos de calor M3; sin tuercas ni separadores.
// Todos los cables estan modelados con su ruta; cable() imprime "CABLE|nombre|color|mm" para la lista de cables.

PIEZA = "ensamble";
PASO = 0;
PLACA = "uno_r3";        // "uno_r3", "unoq" (UNO Q + camara USB) o "nano" (version vieja)
MARCA = [0, 0, 0];
UNIDO = false;           // det_arnes: conector T unido

$fn = 48;
$gris = false;
$col = "orange";         // color de las piezas impresas
function en(x, l) = len([for (e = l) if (e == x) 1]) > 0;
$ins = !en(PIEZA, ["piso1", "piso2", "cuna_motor", "capucha_color", "patin", "prueba", "placa", "soporte_tof", "repisa", "cabeza_camara", "clip_oled", "placa_q"]);   // dibuja insertos

// ---------- Tolerancias: Bambu Lab A2L, boquilla 0.4, capa 0.2, PLA/PETG ----------
// En la A2L (cama movil) los agujeros salen ~0.1 mm chicos y las ranuras ~0.15 mm angostas;
// las medidas de abajo ya lo compensan. Antes de imprimir todo, imprime PIEZA="prueba".
HOLGURA = 0.2;                 // juego por lado entre pieza impresa y componente
RANURA = 1.6 + 0.4;            // ranura para un PCB de 1.6 mm
RAN_TOF = 1.6 + 0.2;           // ranura justa del VL53L0X (con 0.4 bailaba)
M3_PASO = 3.4;                 // M3 pasante
INSERTO = [4.0, 5.7];          // inserto de calor M3: agujero y largo (medir el suyo; ver PIEZA="prueba")
D_BOTON = 7 + 2 * 0.15;        // boton de panel de 7 mm
D_SWITCH = 6 + 2 * 0.15;       // interruptor de palanca MTS-102 (6 mm)

// Cama de impresion: Bambu Lab X2D, 256 x 256 (boquilla principal)
CAMA = 256;
MARGEN = 6;

// ---------- Medidas generales ----------
L = 120;            // lado maximo con ruedas
R_ESQ = 30;         // radio de esquinas (deja girar en un pasillo de 180)
ESP = 3;            // espesor de pisos

// Ruedas y motores N20
D_RUEDA = 45;       // medida real
A_RUEDA = 17;       // goma; la maza (7) no sobresale
MOT_L = 26.11;      // caja + motor, sin eje (eje centrado, sale 7)
MOT_A = 11.94;      // ancho (Y)
MOT_H = 11;         // alto (Z)
EJE_Z = D_RUEDA / 2;
X_RUEDA_INT = L / 2 - A_RUEDA;           // 40
X_MOT_EXT = X_RUEDA_INT - 1.5;           // cara de la caja de engranes
X_MOT = X_MOT_EXT - MOT_L / 2;           // centro del motor
X_MOT_INT = X_MOT_EXT - MOT_L;           // cara de las terminales (14.5)
POZO_X = X_RUEDA_INT - 2;                // hueco de la rueda en el piso 1
POZO_Y = sqrt(pow(D_RUEDA / 2, 2) - pow(MOT_H / 2, 2)) + 1.5;   // media cuerda de la rueda en el fondo del piso 1 + juego

// Pisos
Z1 = EJE_Z + MOT_H / 2;                  // fondo del piso 1 (toca el motor)
SEP = 35;                                // columnas impresas del piso 1, con inserto arriba
Z2 = Z1 + ESP + SEP;                     // fondo del piso 2
POSTES = [[32, 55.5], [-32, 55.5], [48, -40], [-48, -40]];   // los de atras dejan libre el jack y el USB-B del R3

// Componentes
BAT = [70, 37, 19];      // 2S 18650 acostada a lo ancho (X, Y, Z)
BAT_Y = 7;               // sobre el eje: deja libres los pasillos de los conectores de los VL53L0X
BAT_PARED = 8;           // alto de los topes que la sujetan
L298 = [43, 43, 27];
L298_Y = -37.5;          // 4.5 mm entre su borde y la bateria para doblar los cables de potencia
L298_AG = 37;            // separacion de agujeros del L298N (medir el suyo)
L298_POSTE = 5;          // postes impresos del L298N, con inserto
L298_Z = Z1 + ESP + L298_POSTE;          // cara de abajo de su PCB
BORNE_Z = L298_Z + 1.6 + 4;              // altura de entrada de los cables a los bornes
TOF = [25, 11];          // VL53L0X CJVL53L0XV2 (ancho, alto), medido
TOF_AG = [20, TOF[1] - 5.5];   // agujeros del VL53L0X (pasa M3): separacion y altura del centro (5.5 medido desde el borde de los pines)
TOF_FRENTE_Y = 54;
TOF_BASE = 7;            // base del soporte con inserto; el VL53L0X queda esta altura sobre el piso 1
TOF_FIJ = [8, -5.3];     // insertos de abajo del soporte (X a cada lado, Y), al centro del bloque
TOF_LADO = [43, 40];     // (X, Y) de los soportes laterales: delante de la rueda y dentro de la esquina
HEADER = [2.5, 6, 1.4];  // header recto: plastico, pin largo, punta corta que sale del lado del chip
COLOR_MOD = 20.5;        // TCS34725 morado (medir el suyo)
COLOR_Y = 34;
COLOR_Z = 5;             // altura de la cara del sensor sobre el suelo
PATIN_Y = -52;
PATIN_X = 26;            // tornillos del patin: fuera del L298N
CUNA_Y = [-16.8, 29];    // tornillos de las cunas: fuera de la bateria
PROTO = [35, 47, 9.5];   // mini protoboard 170 puntos (X, Y, Z)
PROTO_Y = -32.6;
NANO = [17.8, 44];
OLED = [27.3, 27.8];     // PCB del OLED 0.96" (medir el suyo)
OLED_Y = 39.4;           // pines hacia atras, sobre el hueco entre bateria y conector frontal
BOTON_XY = [-38, 5];
SWITCH_XY = [38, 5];
PASO_PIN = 2.54;
DUPONT = [2.5, 14];      // conector dupont (lado, largo)
CABLE = 1.4;             // diametro del cable dupont
CABLE_POT = 1.8;         // calibre 22 con forro de silicon (bateria, interruptor, motores)
RAN2_X = 26.5;           // ranuras laterales de cables del piso 2 (centro X)
RAN2_Y = 34.5;           // y su centro Y (como el piso 2 ya impreso; los cables suben en Y 36-44)
T_CON = [13, 12.7, 7];   // conector T (Deans): cada mitad (X, Y, Z)
T_POS = [-25, 10, Z1 + ESP + BAT[2]];    // conector T acostado sobre la bateria (borde izq, centro Y, fondo)

// UNO R3 / UNO Q (mismo tamano y agujeros). USB a la izquierda (-X), header digital al frente
UNO = [68.58, 53.34];
UNO_Y0 = -58;                            // borde de atras de la placa
UNO_AG = [[13.97, 2.54], [15.24, 50.8], [66.04, 7.62], [66.04, 35.56]];   // agujeros (medidas del plano de Arduino)
UNO_POSTE = 6;                           // bajo el UNO Q van sus conectores JMEDIA/JMISC
UNO_USB_Y = 38.1;                        // centro del USB sobre el borde izquierdo (medir el de la Q)
function uno(p) = [p[0] - UNO[0] / 2, p[1] + UNO_Y0];
UNO_Z = Z2 + ESP + UNO_POSTE;            // cara de abajo del PCB
ZS = Z2 + ESP;                           // cara de arriba del piso 2

// Headers del UNO (medidas del plano de Arduino; medir los de su placa). x: desde el borde del USB, y: desde el borde de atras.
// Digital al frente (SCL SDA AREF GND D13..D8, hueco de 4.06, D7..D0); potencia y analogos atras.
function idx(l, x) = let(r = [for (i = [0 : len(l) - 1]) if (l[i] == x) i]) len(r) > 0 ? r[0] : -1;
UNO_H = [["SCL", "SDA", "AREF", "GND", "D13", "D12", "D11", "D10", "D9", "D8"],
         ["D7", "D6", "D5", "D4", "D3", "D2", "D1", "D0"],
         ["NC", "IOREF", "RESET", "3V3", "5V", "GND2", "GND3", "VIN"],      // GND2 y GND3: los dos GND de potencia
         ["A0", "A1", "A2", "A3", "A4", "A5"]];
UNO_HX = [19.05, 19.05 + 9 * 2.54 + 4.064, 27.94, 50.8];     // x del primer pin de cada header
UNO_HY = [50.8, 50.8, 2.54, 2.54];
function uno_h(n) = [for (h = [0 : 3]) if (idx(UNO_H[h], n) >= 0) h][0];
function uno_pin(n) = uno([UNO_HX[uno_h(n)] + idx(UNO_H[uno_h(n)], n) * PASO_PIN, UNO_HY[uno_h(n)]]);

// Camara USB en mastil de PTR (concepto: el PTR y su anclaje se definen cuando haya medida oficial)
MASTIL = 20;             // perfil de aluminio 2020 (ranura T, hoyo al centro), 75 mm de largo
MASTIL_XY = [0, 10.5];   // al centro, entre el UNO y el OLED
CAM_Z = 150;             // altura del lente sobre el suelo
CAM_INCL = 40;           // grados hacia abajo (ve el piso desde 7 cm adelante del eje)
CAM_FOV = [100, 75];     // lente M12 gran angular (horizontal, vertical)
CAM_PCB = 32;            // innomaker U20CAM-9281M: medida por confirmar (antes modulo de 32 x 32 mm, agujeros M2 a 28 mm)
CAM_DZ = 12;             // la placa de la camara va 12 mm arriba de la manga: su parte de atras queda libre
// OLED en la cara de atras del mastil (solo Q): header acodado de 4 pines hacia ARRIBA (el OLED va de cabeza; en el
// codigo se gira la pantalla 180 grados), sujeto por un clip impreso. Asi sus cables salen por arriba, sin cruzar los del shield.
OLED_MZ = CAM_Z + 5.5 - OLED[1];                 // borde de abajo del OLED (va en la cabeza de la camara, header arriba)
CLIP_YB = MASTIL_XY[1] - (MASTIL + 6) / 2;       // cara de atras del collar y de la manga de la camara
CLIP_Z0 = 100;                                   // abajo del clip (el collar mide 12)

// Hub USB en una repisa al frente del piso 2 (el mismo piso 2 sirve al R3: ahi la repisa no se pone)
HUB = [95, 30, 12];      // medir el suyo
REPISA_Z = Z2 + ESP + 19;   // cara de abajo de la repisa: postes de 19 mm (como el piso 2 ya impreso)
REPISA_ESP = 2.5;
REPISA_POSTES = [[52, 26], [-52, 26], [52, 44], [-52, 44]];
HUB_Y = 39.5;

OLED_PINES_Y = OLED_Y - OLED[1] / 2 + 2.5;
TOF_PIN_Z = TOF[1] - 1.3;                // fila de pines del VL53L0X, medida desde su borde de abajo
TOF_ATRAS = 0.3 + HEADER[0] + DUPONT[1]; // del centro de la ranura al final del dupont (16.8)
TOF_SUBE = 56 - Z1 - ESP - TOF_BASE - TOF_PIN_Z;   // el cable frontal sube a 56 mm y va a la ranura derecha

// Protoboards: tiras de 5 hoyos a lo ancho (X), 17 columnas a lo largo (Y)
XP = PROTO[0] / 2 + 1.1;                 // centro X de cada protoboard (Nano en -XP, bus en +XP)
ZP = Z2 + ESP + PROTO[2];                // cara de arriba de las protoboards
function hx(c, k) = c + sign(k) * (3.81 + PASO_PIN * (abs(k) - 1));   // hoyo k (1 = junto al canal)
function hy(j) = PROTO_Y + (j - 8) * PASO_PIN;                         // columna j (16 = adelante)
NANO_A = hx(-XP, 2);                     // fila de pines A0..A7, 5V, GND, VIN
NANO_D = hx(-XP, -3);                    // fila de pines D2..D12
NANO_X = (NANO_A + NANO_D) / 2;
function pin_nano(i) = hy(1 + i);        // i = 0 junto al USB (atras)
BUS = [13, 16, 7, 10];                   // columnas del bus: 5V, GND, SDA, SCL (mismo orden que los pines del Nano)
function z_bus(l) = ZP + 16 + (16 - BUS[l]) / 3 * 1.7;   // altura del cable que llega a la linea l

// ---------- Utilidades ----------
function k(c) = $gris ? "gainsboro" : c;
function lon(p, i = 0) = i >= len(p) - 1 ? 0 : norm(p[i + 1] - p[i]) + lon(p, i + 1);

module cuadrado_redondo(l, r, h) {
  linear_extrude(h) offset(r) square(l - 2 * r, center = true);
}

module agujero(d, h) { translate([0, 0, -0.5]) cylinder(d = d, h = h + 1); }

// Agujero para inserto, desde z = 0 hacia abajo
module ag_inserto(h, d = INSERTO[0]) { translate([0, 0, -h]) cylinder(d = d, h = h + 0.5); }

// Inserto ya puesto (solo para el ensamble), a ras en z = 0
module inserto() {
  color(k("goldenrod")) translate([0, 0, -INSERTO[1]]) difference() {
    cylinder(d = INSERTO[0] + 0.4, h = INSERTO[1]);
    agujero(3.2, INSERTO[1]);
  }
}

// Paso del ensamble: no aparece antes de su paso; en pasos posteriores sale en gris
module paso(p) {
  $gris = PASO > p;
  if (PASO == 0 || PASO >= p) children();
}

module gris() { $gris = true; children(); }

// Cable que pasa por una lista de puntos
module cable(pts, col, d = CABLE, nombre = "") {
  if (nombre != "") echo(str("CABLE|", nombre, "|", col, "|", round(lon(pts))));
  color(k(col)) for (i = [0 : len(pts) - 2]) hull() {
    translate(pts[i]) sphere(d = d, $fn = 8);
    translate(pts[i + 1]) sphere(d = d, $fn = 8);
  }
}

// ---------- Piezas impresas ----------

// Soporte de VL53L0X, pieza aparte: base con 2 insertos (M3x8 desde abajo del piso 1), dos postes y un
// canal, todo con ranura; el modulo baja desde arriba con el chip a +Y. Entre los postes queda libre el header.
module soporte_tof() {
  // bloque detras del VL53L0X: 2 M3 x 10 por el frente (oreja -> inserto). Arriba queda libre para el header y los dupont
  a = TOF[0] + 3.4;                                // 2.2 mm de pared a los lados de los insertos del frente
  yb = 0.5 - 0.8;                                  // cara de atras de la placa
  zt = TOF_BASE + TOF_PIN_Z - 1.25 - 0.4;          // tope del bloque, abajo del plastico del header
  color(k($col)) difference() {
    union() {
      translate([-a / 2, yb - 10, 0]) cube([a, 10, zt]);
      for (s = [0, 1]) mirror([s, 0, 0]) translate([3 * PASO_PIN + 1, yb - 10, 0]) cube([a / 2 - 3 * PASO_PIN - 1, 10, TOF_BASE + TOF[1]]);   // torres sobre los insertos; el centro libre para los dupont
    }
    translate([-7, yb - 1, TOF_BASE]) cube([14, 1.1, 20]);                                  // componentes de atras
    for (x = [-1, 1]) translate([x * 15.5, -11, -1]) cylinder(d = 10, h = 30);                 // libra la columna del piso 1 (laterales)
    for (x = [-1, 1]) translate([x * TOF_FIJ[0], TOF_FIJ[1], 0]) mirror([0, 0, 1]) ag_inserto(INSERTO[1]);
    for (s = [-1, 1]) translate([s * TOF_AG[0] / 2, yb, TOF_BASE + TOF_AG[1]]) rotate([-90, 0, 0]) {
      ag_inserto(INSERTO[1]);
      translate([0, 0, -9.5]) cylinder(d = 3, h = 10, $fn = 24);                          // punta del M3 x 10
    }
  }
  if ($ins) {
    for (x = [-1, 1]) translate([x * TOF_FIJ[0], TOF_FIJ[1], 0]) mirror([0, 0, 1]) inserto();
    for (s = [-1, 1]) translate([s * TOF_AG[0] / 2, yb, TOF_BASE + TOF_AG[1]]) rotate([-90, 0, 0]) inserto();
  }
}

// Lugares de los 3 soportes de VL53L0X sobre el piso 1: frente, izquierdo y derecho
module tof_lugares() {
  translate([0, TOF_FRENTE_Y, 0]) children();
  for (s = [-1, 1]) translate([s * TOF_LADO[0], TOF_LADO[1], 0]) rotate([0, 0, -s * 90]) children();
}

module piso1() {
  color(k($col)) difference() {
    union() {
      cuadrado_redondo(L, R_ESQ, ESP);
      translate([0, 0, ESP]) {
        // topes de la bateria; fuera de los pasillos de los conectores y de los bornes del L298N
        xb = BAT[0] / 2 + HOLGURA + 1;
        yb = BAT[1] / 2 + HOLGURA + 1;
        for (s = [-1, 1]) {
          for (y = [-1, 1]) translate([s * xb, BAT_Y + y * (yb - 6), BAT_PARED / 2]) cube([2, 10, BAT_PARED], center = true);
          translate([s * 26, BAT_Y - yb, BAT_PARED / 2]) cube([8, 2, BAT_PARED], center = true);
          translate([s * 14, BAT_Y + yb, BAT_PARED / 2]) cube([8, 2, BAT_PARED], center = true);
        }
        for (p = POSTES) translate([p[0], p[1], 0]) cylinder(d = 8, h = SEP);
        for (x = [-1, 1]) for (y = [-1, 1])
          translate([x * L298_AG / 2, L298_Y + y * L298_AG / 2, 0]) cylinder(d = 7, h = L298_POSTE);
      }
    }
    for (s = [-1, 1]) translate([s * (POZO_X + 25), 0, ESP / 2]) cube([50, 2 * POZO_Y, ESP + 2], center = true);
    for (s = [-1, 1]) translate([s * 27, -25, ESP / 2]) cube([10, 10, ESP + 2], center = true);  // cables de motores
    translate([0, COLOR_Y - 4.5, ESP / 2]) cube([14, 6, ESP + 2], center = true);       // cables del TCS34725
    for (p = POSTES) translate([p[0], p[1], ESP + SEP]) ag_inserto(8);
    for (x = [-1, 1]) for (y = [-1, 1])
      translate([x * L298_AG / 2, L298_Y + y * L298_AG / 2, ESP + L298_POSTE]) ag_inserto(7);
    for (s = [-1, 1]) for (y = CUNA_Y) translate([s * X_MOT, y, 0]) agujero(M3_PASO, ESP);
    for (x = [-1, 1]) translate([x * PATIN_X, PATIN_Y, 0]) agujero(M3_PASO, ESP);
    for (x = [-1, 1]) translate([x * 17, COLOR_Y, 0]) agujero(M3_PASO, ESP);
    tof_lugares() for (x = [-1, 1]) translate([x * TOF_FIJ[0], TOF_FIJ[1], 0]) agujero(M3_PASO, ESP);
  }
  if ($ins) {
    for (p = POSTES) translate([p[0], p[1], ESP + SEP]) inserto();
    for (x = [-1, 1]) for (y = [-1, 1]) translate([x * L298_AG / 2, L298_Y + y * L298_AG / 2, ESP + L298_POSTE]) inserto();
  }
}

module piso2() {
  ap = PROTO[0] + 2 * 0.3;
  lp = PROTO[1] + 2 * 0.3;
  ao = [OLED[0] + 2 * 0.3, OLED[1] + 2 * 0.3];
  difference() {
    union() {
      cuadrado_redondo(L, R_ESQ, ESP);
      translate([0, 0, ESP]) {
        // marco para dos protoboards (Nano a la izquierda, bus I2C a la derecha)
        if (PLACA == "nano") translate([0, PROTO_Y, 2]) difference() {
          cube([2 * ap + 3 * 1.6, lp + 3.2, 4], center = true);
          for (s = [-1, 1]) translate([s * (ap / 2 + 0.8), 0, 0]) cube([ap, lp, 6], center = true);
          translate([-(ap / 2 + 0.8), -lp / 2, 0]) cube([12, 6, 6], center = true);   // salida del USB
        }
        // marco del OLED
        translate([0, OLED_Y, 1.5]) difference() {
          cube([ao[0] + 3.2, ao[1] + 3.2, 3], center = true);
          cube([ao[0], ao[1], 4], center = true);
        }
        if (PLACA != "nano") {
          for (a = UNO_AG) translate(uno(a)) cylinder(d = 6.5, h = UNO_POSTE);
          for (p = REPISA_POSTES) translate(p) cylinder(d = 8, h = REPISA_Z - Z2 - ESP);
        }
      }
    }
    if (PLACA != "nano") {
      for (a = UNO_AG) translate(concat(uno(a), ESP + UNO_POSTE)) ag_inserto(8);
      for (p = REPISA_POSTES) translate(concat(p, REPISA_Z - Z2)) ag_inserto(8);
    }
    for (p = POSTES) translate([p[0], p[1], 0]) agujero(M3_PASO, ESP);
    translate([0, OLED_PINES_Y, ESP / 2]) cube([13, 4.5, ESP + 2], center = true);               // pines del OLED
    translate([0, OLED_Y + 3, ESP / 2]) cube([20, 14, ESP + 2], center = true);                  // aligera
    translate([0, -3, ESP / 2]) cube([60, 6, ESP + 2], center = true);                           // cables de abajo
    for (s = [-1, 1]) translate([s * RAN2_X, RAN2_Y, ESP / 2]) cube([16, 22, ESP + 2], center = true); // cables de sensores
    translate([BOTON_XY[0], BOTON_XY[1], 0]) agujero(D_BOTON, ESP);
    translate([SWITCH_XY[0], SWITCH_XY[1], 0]) agujero(D_SWITCH, ESP);
    translate(MASTIL_XY) agujero(5.5, ESP);                                                      // M5 al hoyo central del mastil 2020
  }
  if ($ins && PLACA != "nano") {
    for (a = UNO_AG) translate(concat(uno(a), ESP + UNO_POSTE)) inserto();
    for (p = REPISA_POSTES) translate(concat(p, REPISA_Z - Z2)) inserto();
  }
}

module cuna_motor() {
  // aprieta el motor contra el piso 1; 0.3 mm mas baja que el motor para que apriete.
  // Las orejas sacan los tornillos de debajo de la bateria
  h = 2 + MOT_H - 0.3;
  color(k($col)) difference() {
    union() {
      translate([-8, -MOT_A / 2 - 3, 0]) cube([16, MOT_A + 6, h]);
      for (y = CUNA_Y) translate([-3.5, min(0, y + sign(y) * 3.5), 0]) cube([7, abs(y) + 3.5, h]);
    }
    translate([-9, -11.9 / 2, 2]) cube([18, 11.9, MOT_H + 1]);
    for (y = CUNA_Y) translate([0, y, h]) ag_inserto(10);
  }
  if ($ins) for (y = CUNA_Y) translate([0, y, h]) inserto();
}

// Capucha del sensor de color: el TCS34725 entra deslizando por atras (cara del sensor hacia abajo)
// y queda atrapado en una ranura. Al frente lleva el patin delantero.
module capucha_color() {
  h = Z1 - 2;                         // de 2 mm sobre el suelo hasta el piso 1
  a = COLOR_MOD + 2 * HOLGURA;        // ranura del modulo
  v = a - 3;                          // ventana: deja 1.5 mm de apoyo por lado
  z0 = COLOR_Z - 2;                   // fondo de la ranura, medido desde el borde de la capucha
  color(k($col)) difference() {
    union() {
      translate([-a / 2 - 2, -a / 2 - 2, 0]) cube([a + 4, a + 4, h]);
      translate([-22, -5, h - 8]) cube([44, 10, 8]);                         // orejas
      translate([0, a / 2 + 4, 3.5]) {                                       // patin delantero, 0.5 mm sobre el suelo
        cylinder(d = 10, h = h - 3.5);
        sphere(d = 10);
      }
    }
    translate([-v / 2, -v / 2, -1]) cube([v, v, h + 2]);                     // ventana de luz
    translate([-a / 2, -a / 2 - 3, z0]) cube([a, a + 3, RANURA]);            // ranura, abierta atras
    translate([-v / 2, -a / 2 - 3, z0]) cube([v, 4 + (a - v) / 2, h]);       // salida de cables: suben por dentro
    for (x = [-1, 1]) translate([x * 17, 0, h]) ag_inserto(7);
  }
  if ($ins) for (x = [-1, 1]) translate([x * 17, 0, h]) inserto();
}

module patin() {
  // apoyo deslizante trasero; deja 0.5 mm al suelo. Sus tornillos quedan a los lados del L298N
  h = Z1 - 0.5;
  color(k($col)) difference() {
    union() {
      translate([0, 0, 0.5]) {
        translate([0, 0, 5]) cylinder(d = 10, h = h - 5);
        translate([0, 0, 5]) sphere(d = 10);
      }
      translate([-PATIN_X - 4, -4, Z1 - 8]) cube([2 * PATIN_X + 8, 8, 8]);
    }
    for (x = [-1, 1]) translate([x * PATIN_X, 0, Z1]) ag_inserto(7);
  }
  if ($ins) for (x = [-1, 1]) translate([x * PATIN_X, 0, Z1]) inserto();
}

module prueba() {
  // agujeros M3, insertos, boton, interruptor, ranura de motor y el soporte de VL53L0X
  difference() {
    cube([70, 26, 3]);
    for (i = [0 : 2]) translate([6 + i * 7, 7, 0]) agujero(3.2 + i * 0.2, 3);    // 3.2 / 3.4 / 3.6
    translate([40, 8, 0]) agujero(D_BOTON, 3);
    translate([40, 19, 0]) agujero(D_SWITCH, 3);
  }
  translate([48, 0, 0]) difference() {
    cube([22, 26, 9]);
    translate([5, 13 - MOT_A / 2 - HOLGURA, 2]) cube([20, MOT_A + 2 * HOLGURA, 10]);
  }
  translate([0, -12, 0]) { cube([36, 12, 3]); translate([18, 6, 3]) soporte_tof(); }
  translate([0, 26, 0]) difference() {                                          // insertos: 3.8 / 4.0 / 4.2
    cube([26, 9, 8]);
    for (i = [0 : 2]) translate([5.5 + i * 7.5, 4.5, 8]) ag_inserto(7, INSERTO[0] - 0.2 + i * 0.2);
  }
}

// Todas las piezas (menos la de prueba) en la cama de 256 x 256 de la X2D, en su orientacion de impresion
module placa() {
  m = MARGEN;
  translate([m + L / 2, m + L / 2, 0]) piso1();
  translate([CAMA - m - L / 2, m + L / 2, 0]) piso2();
  y2 = 2 * m + L + 18;
  for (i = [0 : 1]) translate([m + 12 + i * 24, y2, 0]) cuna_motor();
  translate([85, y2 + 6, Z1 - 2]) rotate([180, 0, 0]) capucha_color();
  translate([150, y2, Z1]) rotate([180, 0, 0]) patin();
  for (i = [0 : 2]) translate([220, y2 + i * 16, 0]) soporte_tof();
}

// Piezas solo de la UNO Q (repisa, cabeza de la camara, clip del OLED) en la cama, en su orientacion de impresion
module placa_q() {
  translate([CAMA / 2, MARGEN + 2, 0]) translate([0, -22, 0]) repisa();
  translate([60, 80, -(CAM_Z - 26)]) translate([-MASTIL_XY[0], -MASTIL_XY[1], 0]) cabeza_camara();
}

// ---------- Componentes comprados (solo para el ensamble) ----------
module rueda(s) {
  translate([s * (X_RUEDA_INT + A_RUEDA / 2), 0, EJE_Z]) rotate([0, 90, 0]) {
    color(k("black")) difference() {
      cylinder(d = D_RUEDA, h = A_RUEDA, center = true);
      for (z = [-1, 1]) translate([0, 0, z * A_RUEDA / 2]) cylinder(d = D_RUEDA - 10, h = 3, center = true);
    }
    color(k("white")) cylinder(d = D_RUEDA - 10, h = A_RUEDA - 4, center = true);
  }
}

// N20: caja de engranes afuera, motor adentro; terminales y capacitor de 100 nF en la cara interior
module motor(s) {
  translate([0, 0, EJE_Z]) {
    color(k("gold")) translate([s * (X_MOT_EXT - 4.5), 0, 0]) cube([9, MOT_A, MOT_H], center = true);
    color(k("silver")) translate([s * (X_MOT_INT + 7.5), 0, 0]) intersection() {
      cube([15, MOT_A, MOT_H], center = true);
      rotate([0, 90, 0]) cylinder(d = MOT_A, h = 15, center = true);
    }
    color(k("silver")) translate([s * (X_MOT_EXT + 3), 0, 0]) rotate([0, 90, 0]) cylinder(d = 3, h = 6, center = true);
    color(k("white")) translate([s * (X_MOT_INT - 0.4), 0, 0]) cube([0.8, 9, 7], center = true);
    for (y = [-1, 1]) color(k("orange")) translate([s * (X_MOT_INT - 1.2), y * 3.5, 1]) cube([1.6, 1.2, 0.4], center = true);
    color(k("yellow")) translate([s * (X_MOT_INT - 2), 0, 2.3]) rotate([0, 90, 0]) cylinder(d = 4.5, h = 2, center = true);
  }
}

// Cables de un motor (s = -1 izquierdo, +1 derecho). final = false: solo suben por la ranura (paso 1)
module cables_motor(s, final = true) {
  nom = s < 0 ? "Motor izq" : "Motor der";
  out = s < 0 ? ["OUT1", "OUT2"] : ["OUT3", "OUT4"];
  for (i = [0 : 1]) {
    y = (i == 0 ? 1 : -1) * 3.5;
    xr = s * (27 + (i - 0.5) * 3);
    yb = L298_Y + (i == 0 ? 7.5 : 2.5);
    pts = concat([[s * (X_MOT_INT - 1.2), y, EJE_Z + 1], [s * (X_MOT_INT - 3), y, 19],
                  [s * 11, y - 3, 19], [s * 11, -27, 19], [xr, -27, 19]],
                 final ? [[xr, -27, BORNE_Z - 2], [xr, yb, BORNE_Z], [s * 21.5, yb, BORNE_Z]]
                       : [[xr, -27, 42]]);
    cable(pts, i == 0 ? "yellow" : "white", CABLE_POT, final ? str(nom, " -> ", out[i]) : "");
  }
}

// Tornillo Allen M3 de largo l, cabeza en z = 0 y cuerpo hacia -Z
module tornillo(l) {
  color(k("dimgray")) {
    difference() { cylinder(d = 5.5, h = 3); translate([0, 0, 1.2]) cylinder(d = 2.9, h = 2, $fn = 6); }
    translate([0, 0, -l]) cylinder(d = 3, h = l);
  }
}

// Fila de pines con sus conectores dupont (sin cable). Pines hacia +Z desde z = 0 (cara del plastico);
// "atras" es lo que sale del otro lado. sin: indice del pin que queda sin dupont.
module pines(n, largo = 6, atras = 1, dupont = true, sin = -1) {
  for (i = [0 : n - 1]) translate([(i - (n - 1) / 2) * PASO_PIN, 0, 0]) {
    color(k("gold")) translate([-0.32, -0.32, -atras]) cube([0.64, 0.64, largo + atras]);
    if (dupont && i != sin) color(k("black")) translate([-DUPONT[0] / 2, -DUPONT[0] / 2, 0]) cube([DUPONT[0], DUPONT[0], DUPONT[1]]);
  }
}

// Dupont macho clavado en un hoyo de protoboard (h = [x, y])
module dupont_macho(h) {
  color(k("black")) translate([h[0] - DUPONT[0] / 2, h[1] - DUPONT[0] / 2, ZP]) cube([DUPONT[0], DUPONT[0], DUPONT[1]]);
  color(k("gold")) translate([h[0] - 0.32, h[1] - 0.32, ZP - 6]) cube([0.64, 0.64, 6]);
}

// Ruta de arriba: del punto p (ya sobre el piso 2) a un hoyo h de protoboard.
// Va a la altura lz, corre por el carril ly, sube a zt frente a las protoboards y baja al hoyo.
function ruta(p, h, ly, lz, zt, zfin) =
  [p, [p[0], p[1], lz], [p[0], ly, lz], [h[0], ly, lz], [h[0], ly, zt], [h[0], h[1], zt], [h[0], h[1], zfin]];

module arriba(p, h, col, ly, lz, zt, nombre = "", dupont = true) {
  cable(ruta(p, h, ly, lz, zt, dupont ? ZP + DUPONT[1] : ZP), col, dupont ? CABLE : CABLE_POT, nombre);
  if (dupont) dupont_macho(h);
}

COL_TOF = ["red", "black", "cyan", "royalblue", "white", "green"];   // VIN GND SCL SDA GPIO1 XSHUT
SEN_TOF = ["VIN", "GND", "SCL", "SDA", "GPIO1", "XSHUT"];

// Conector del VL53L0X: header recto (plastico atras), 5 dupont hacia -Y (GPIO1 sin conectar) y cables.
// recto > 0: cable recto de ese largo (prueba de choques); si no, el cable se dobla y sube "sube" mm.
// va != 0: despues de subir, los cables van de lado hasta x = va y suben "sube2" mm mas.
module tof_conector(recto = 0, sube = 14, va = 0, sube2 = 0, nombre = "") {
  y0 = -0.3 - HEADER[0];                 // cara de atras del plastico
  yd = -TOF_ATRAS;                       // final del dupont
  color(k("dimgray")) translate([-3 * PASO_PIN, y0, TOF_PIN_Z - 1.25]) cube([6 * PASO_PIN, HEADER[0], 2.5]);
  translate([0, y0, TOF_PIN_Z]) rotate([90, 0, 0]) pines(6, HEADER[1], 1.6 + HEADER[0] + HEADER[2], sin = 4);
  for (i = [0 : 5]) if (i != 4) {
    x = (i - 2.5) * PASO_PIN;
    if (recto > 0) cable([[x, yd, TOF_PIN_Z], [x, yd - recto, TOF_PIN_Z]], COL_TOF[i]);
    else {
      z = TOF_PIN_Z + sube + (va == 0 ? 0 : i * 1.5);
      xv = va + (i - 2.5) * 1.5;
      cable(concat([[x, yd, TOF_PIN_Z]],
                   [for (a = [0 : 30 : 90]) [x, yd - 1 - 3 * sin(a), TOF_PIN_Z + 3 - 3 * cos(a)]],
                   [[x, yd - 4, z]],
                   va == 0 ? [] : [[xv, yd - 4, z], [xv, yd - 4, z + sube2]]), COL_TOF[i], CABLE,
            nombre == "" ? "" : str(nombre, " ", SEN_TOF[i], " (abajo)"));
    }
  }
}

// VL53L0X con header recto: chip a +Y, pines hacia -Y en el borde de arriba
module tof_modulo(sube = 14, va = 0, sube2 = 0, nombre = "") {
  color(k("green")) translate([0, 0.5, TOF[1] / 2]) cube([TOF[0], 1.6, TOF[1]], center = true);
  color(k("black")) translate([0, 1.8, TOF[1] / 2]) cube([4.4, 1, 2.4], center = true);
  for (i = [0 : 5]) color(k("silver")) translate([(i - 2.5) * PASO_PIN, 1.3, TOF_PIN_Z]) rotate([-90, 0, 0]) cylinder(d1 = 1.8, d2 = 0.8, h = 0.8);
  tof_conector(0, sube, va, sube2, nombre);
}

COL_OLED = ["black", "red", "cyan", "royalblue"];   // GND VCC SCL SDA
SEN_OLED = ["GND", "VCC", "SCL", "SDA"];

// OLED acostado: espaciador del header dentro de la ranura y pines hacia abajo.
// recto > 0: cable recto hacia abajo (prueba de choques); si no, va a la ranura derecha del piso 2.
module oled_conector(recto = 0, nombre = "") {
  zd = -HEADER[0] - DUPONT[1];
  color(k("dimgray")) translate([0, OLED_PINES_Y, -HEADER[0] / 2]) cube([4 * PASO_PIN, 2.5, HEADER[0]], center = true);
  translate([0, OLED_PINES_Y, -HEADER[0]]) mirror([0, 0, 1]) pines(4, HEADER[1], 1.6 + HEADER[0] + HEADER[2]);
  for (i = [0 : 3]) {
    x = (i - 1.5) * PASO_PIN;
    z = zd - 3 - i * 1.6;
    if (recto > 0) cable([[x, OLED_PINES_Y, zd], [x, OLED_PINES_Y, zd - recto]], COL_OLED[i]);
    else cable([[x, OLED_PINES_Y, zd], [x, OLED_PINES_Y, z], [20 + i * 1.5, OLED_PINES_Y, z], [20 + i * 1.5, OLED_PINES_Y, 4]],
               COL_OLED[i], CABLE, nombre == "" ? "" : str(nombre, " ", SEN_OLED[i], " (abajo)"));
  }
}

module oled_modulo(nombre = "") {
  color(k("navy")) translate([0, OLED_Y, 1.5]) cube([OLED[0], OLED[1], 3], center = true);
  color(k("black")) translate([0, OLED_Y + 2, 3]) cube([26, 19, 0.6], center = true);
  oled_conector(0, nombre);
}

COL_TCS = ["red", "black", "cyan", "royalblue"];    // VIN GND SCL SDA
SEN_TCS = ["VIN", "GND", "SCL", "SDA"];

// Cables del TCS34725 (coordenadas del robot): suben por dentro de la capucha, cruzan el piso 1
// por su ranura, van a la izquierda por debajo del conector frontal y suben a la ranura del piso 2.
module tcs_cables() {
  y0 = COLOR_Y - COLOR_MOD / 2 + 1.3;
  yr = COLOR_Y - 4.5;
  for (i = [0 : 3]) {
    x = (i - 1.5) * PASO_PIN;
    z = Z1 + ESP + 2.5 + i * 1.5;
    xs = -20 - i * 1.5;
    cable([[x, y0, COLOR_Z + 2.6], [x, y0, 12], [x, yr, 18], [x, yr, z], [xs, yr, z], [xs, yr, Z2 + ESP + 4]],
          COL_TCS[i], CABLE, str("TCS34725 ", SEN_TCS[i], " (abajo)"));
  }
}

// TCS34725 (cara del sensor hacia abajo) con sus 4 cables soldados
module tcs_modulo() {
  color(k("purple")) cube([COLOR_MOD, COLOR_MOD, 1.6], center = true);
  color(k("white")) translate([0, 0, -1.3]) cube([3, 3, 1], center = true);
  for (i = [0 : 6]) color(k("silver")) translate([(i - 3) * PASO_PIN, -COLOR_MOD / 2 + 1.3, 0.8]) cylinder(d = 1.6, h = 0.2);
}

// Boton e interruptor con su cuerpo bajo el piso 2
module boton() {
  color(k("black")) cylinder(d = 10, h = 6);
  color(k("dimgray")) translate([0, 0, -ESP - 12]) cylinder(d = 7, h = 12);
  for (x = [-1, 1]) color(k("silver")) translate([x * 2 - 0.4, -1, -ESP - 17]) cube([0.8, 2, 5]);
}

module interruptor() {
  color(k("silver")) cylinder(d = 3, h = 10);
  color(k("silver")) cylinder(d = 8, h = 1.5, $fn = 6);
  color(k("dimgray")) translate([-4, -6.5, -ESP - 10]) cube([8, 13, 10]);
  for (y = [-1, 0, 1]) color(k("silver")) translate([-1, y * 4.7 - 0.25, -ESP - 15]) cube([2, 0.5, 5]);
}

// Borne de tornillo de n vias, paso 5 mm, abierto hacia +Y local (girado "giro" grados)
module borne(n, p, giro) {
  translate(p) rotate([0, 0, giro]) {
    color(k("dodgerblue")) difference() {
      translate([-n * 2.5, -3.75, 0]) cube([n * 5, 7.5, 10]);
      for (i = [0 : n - 1]) translate([(i - (n - 1) / 2) * 5, 2, 4]) cube([3.2, 4, 3.2], center = true);
    }
    for (i = [0 : n - 1]) color(k("silver")) translate([(i - (n - 1) / 2) * 5, -0.5, 9.6]) cylinder(d = 3.5, h = 0.6);
  }
}

// L298N: bornes de motores a los lados, borne de potencia y header de logica al frente (+Y), disipador atras
module l298() {
  translate([0, L298_Y, L298_Z]) {
    color(k("firebrick")) difference() {
      translate([-21.5, -21.5, 0]) cube([43, 43, 1.6]);
      for (x = [-1, 1]) for (y = [-1, 1]) translate([x * L298_AG / 2, y * L298_AG / 2, 0]) agujero(3.2, 1.6);
    }
    color(k("black")) translate([-11.5, -19.5, 1.6]) cube([23, 3, 22]);                  // chip
    color(k("dimgray")) translate([-11.5, -16.5, 1.6]) difference() {                    // disipador
      cube([23, 13, 25]);
      for (i = [0 : 4]) translate([1.5 + i * 4.5, 3, 4]) cube([2.5, 11, 22]);
    }
    for (s = [-1, 1]) borne(2, [s * (21.5 - 3.75), 5, 1.6], s < 0 ? 90 : -90);          // OUT1-2 / OUT3-4
    borne(3, [13, 21.5 - 3.75, 1.6], 0);                                                  // 5V GND 12V
    // header de logica: ENA IN1 IN2 IN3 IN4 ENB, con los pines de 5V de los jumpers atras
    for (i = [0 : 5]) translate([1 - i * PASO_PIN, 18.5, 1.6]) {
      color(k("black")) translate([-1.27, -1.27, 0]) cube([2.54, 2.54, 2.5]);
      color(k("gold")) translate([-0.32, -0.32, 0]) cube([0.64, 0.64, 8.5]);
      if (i == 0 || i == 5) translate([0, -PASO_PIN, 0]) {
        color(k("black")) translate([-1.27, -1.27, 0]) cube([2.54, 2.54, 2.5]);
        color(k("gold")) translate([-0.32, -0.32, 0]) cube([0.64, 0.64, 8.5]);
      }
    }
    color(k("black")) translate([2.6, 15.9, 1.6]) cube([2.54, 5.1, 6]);                 // jumper 5V-EN (se queda)
  }
}

module tornillos_l298() {
  for (x = [-1, 1]) for (y = [-1, 1]) translate([x * L298_AG / 2, L298_Y + y * L298_AG / 2, L298_Z + 1.6]) tornillo(8);
}

// Bateria 2S: dos 18650 lado a lado; cable principal y de balanceo salen por la izquierda
module bateria() {
  translate([0, BAT_Y, Z1 + ESP]) {
    color(k("royalblue")) hull() for (y = [-1, 1]) translate([0, y * (BAT[1] / 2 - BAT[2] / 2), BAT[2] / 2])
      rotate([0, 90, 0]) cylinder(d = BAT[2], h = BAT[0], center = true);
    color(k("white")) translate([-BAT[0] / 2 + 6, BAT[1] / 2 - 0.05, 6]) cube([20, 0.1, 7]);
  }
  // cable principal al conector T macho
  for (i = [0 : 1]) {
    y = T_POS[1] + (i == 0 ? -3 : 3);
    cable([[-BAT[0] / 2, y, Z1 + ESP + 15], [-BAT[0] / 2 - 2, y, Z1 + ESP + 17], [-BAT[0] / 2 - 2, y, T_POS[2] + 2],
           [T_POS[0] - 2, y, T_POS[2] + 3.5], [T_POS[0], y, T_POS[2] + 3.5]], i == 0 ? "black" : "red", 2);
  }
  // balanceo (JST-XH de 3 pines) acostado sobre la bateria
  for (i = [0 : 2]) {
    y = 20 + (i - 1) * 1.2;
    cable([[-BAT[0] / 2, y, Z1 + ESP + 15], [-BAT[0] / 2 - 1.5, y, Z1 + ESP + 17], [-BAT[0] / 2 - 1.5, y, T_POS[2] + 2],
           [-30, y, T_POS[2] + 2]], ["black", "red", "red"][i], 1);
  }
  color(k("white")) translate([-30, 17, T_POS[2]]) cube([10, 6, 5]);
}

// Conector T (Deans): macho de la bateria y hembra del robot. unido = false: la hembra queda 6 mm aparte
module conector_t(macho = true, hembra = true, unido = true) {
  translate([T_POS[0], T_POS[1] - T_CON[1] / 2, T_POS[2]]) {
    if (macho) color(k("red")) cube(T_CON);
    if (hembra) translate([T_CON[0] + (unido ? 0 : 6), 0, 0]) color(k("crimson")) difference() {
      cube(T_CON);
      translate([-0.1, 2, 2]) cube([3, T_CON[1] - 4, 3]);
    }
  }
}

X_T = T_POS[0] + 2 * T_CON[0];           // salida de los cables de la hembra (unida)
SW_PIN = [SWITCH_XY[0], SWITCH_XY[1], Z2 - 15 + 0.5];   // punta de la pata central del interruptor

// Arnes de potencia: conector T hembra, interruptor y cables a los bornes del L298N y al Nano.
// unido = false: la hembra queda 6 mm separada (se conecta en el ultimo paso)
module arnes_potencia(unido = true) {
  dx = unido ? 0 : 6;
  zt = T_POS[2] + T_CON[2] / 2;
  // T rojo -> pata exterior del interruptor
  cable([[X_T + dx, T_POS[1] + 3, zt], [X_T + dx + 4, T_POS[1] + 3, zt], [30, T_POS[1] + 3, zt - 0.5],
         [36, SW_PIN[1] + 4.7, SW_PIN[2] + 0.5], [SW_PIN[0] - 0.5, SW_PIN[1] + 4.7, SW_PIN[2]]], "red", CABLE_POT,
        "Conector T rojo -> interruptor");
  // T negro -> GND del L298N
  cable([[X_T + dx, T_POS[1] - 3, zt], [X_T + dx + 4, T_POS[1] - 3, zt], [12.2, -4, zt - 0.5],
         [12.2, -13.8, zt - 0.5], [12.2, -13.8, BORNE_Z + 2.5], [12.2, -15, BORNE_Z], [12.2, L298_Y + 21.5, BORNE_Z]],
        "black", CABLE_POT, "Conector T negro -> L298N GND");
  // interruptor -> 12V del L298N
  cable([SW_PIN, [34, SW_PIN[1] - 1, SW_PIN[2] + 1], [18, -4, SW_PIN[2] + 1], [18, -13.8, SW_PIN[2] + 1],
         [18, -13.8, BORNE_Z + 2.5], [18, -15, BORNE_Z], [18, L298_Y + 21.5, BORNE_Z]], "orange", CABLE_POT,
        "Interruptor -> L298N 12V");
  // interruptor -> VIN del Nano (sube por la ranura central)
  cable([SW_PIN, [34, SW_PIN[1] - 2, SW_PIN[2] + 3], [27, -3, Z2 - 8], [27, -3, Z2 + ESP + 2]], "orange", CABLE_POT,
        str("Interruptor -> ", PLACA == "nano" ? "Nano" : "UNO", " VIN (abajo)"));
  // GND del L298N -> GND del Nano
  cable([[13.8, L298_Y + 21.5, BORNE_Z], [13.8, -15, BORNE_Z], [13.8, -13.8, BORNE_Z + 2.5], [13.8, -13.8, zt + 1],
         [13.5, -3, Z2 - 8], [13.5, -3, Z2 + ESP + 2]], "black", CABLE_POT, str("L298N GND -> ", PLACA == "nano" ? "Nano" : "UNO", " GND (abajo)"));
}

// Cables del header de logica del L298N: suben por la ranura central del piso 2
L298_LOG = [[1, "ENA", "mediumpurple", 7], [1 - PASO_PIN, "IN1", "sienna", 5], [1 - 2 * PASO_PIN, "IN2", "sienna", 4],
            [1 - 3 * PASO_PIN, "IN3", "sienna", 3], [1 - 4 * PASO_PIN, "IN4", "sienna", 2],
            [1 - 5 * PASO_PIN, "ENB", "mediumpurple", 6]];     // x, pin, color, pin de la fila D del Nano
NANO_D_NOM = ["D12", "D11", "D10", "D9", "D8", "D7", "D6", "D5", "D4", "D3", "D2", "GND"];

module cables_l298_logica() {
  zd = L298_Z + 1.6 + 2.5;
  for (c = L298_LOG) {
    x = c[0];
    color(k("black")) translate([x - DUPONT[0] / 2, -19 - DUPONT[0] / 2, zd]) cube([DUPONT[0], DUPONT[0], DUPONT[1]]);
    cable([[x, -19, zd + DUPONT[1]], [x, -19, zd + DUPONT[1] + 3], [x, -3, Z2 - 4], [x, -3, Z2 + ESP + 2]], c[2], CABLE,
          str("L298N ", c[1], " (abajo)"));
  }
}

// Cables del boton: de sus patas a la ranura central
module cables_boton() {
  for (i = [0 : 1]) {
    x = BOTON_XY[0] + (i == 0 ? -2 : 2);
    cable([[x, BOTON_XY[1], Z2 - 16.5], [x, BOTON_XY[1] - 4, Z2 - 15], [-28.5 + i * 1.5, -3, Z2 - 8],
           [-28.5 + i * 1.5, -3, Z2 + ESP + 2]], i == 0 ? "hotpink" : "black", CABLE, str("Boton ", i == 0 ? "D2" : "GND", " (abajo)"));
  }
}

module protoboards() {
  for (s = [-1, 1]) translate([s * XP, PROTO_Y, Z2 + ESP]) {
    color(k("white")) translate([-PROTO[0] / 2, -PROTO[1] / 2, 0]) cube(PROTO);
    color(k("silver")) for (j = [0 : 16]) for (kk = [-5 : 5]) if (kk != 0)
      translate([hx(0, kk) - 0.4, hy(j) - PROTO_Y - 0.4, PROTO[2] - 0.05]) cube([0.8, 0.8, 0.1]);
  }
}

module nano() {
  translate([NANO_X, pin_nano(7) - 1, ZP + 2.5 + 0.8]) {
    color(k("darkcyan")) cube([NANO[0], NANO[1], 1.6], center = true);
    color(k("black")) translate([0, 0, 1.3]) rotate([0, 0, 45]) cube([7, 7, 1], center = true);
    color(k("silver")) translate([0, -NANO[1] / 2 + 3.5, 2.4]) cube([9, 7.5, 3.2], center = true);
  }
  for (x = [NANO_A, NANO_D]) for (i = [0 : 14]) translate([x, pin_nano(i), ZP]) {
    color(k("black")) translate([-1.27, -1.27, 0]) cube([2.54, 2.54, 2.5]);
    color(k("gold")) translate([-0.32, -0.32, -6]) cube([0.64, 0.64, 10]);
  }
}

COL_BUS = ["red", "black", "royalblue", "cyan"];
NOM_BUS = ["5V", "GND", "SDA", "SCL"];
NANO_A_BUS = [11, 13, 7, 8];             // pin de la fila A del Nano para 5V, GND, A4 (SDA), A5 (SCL)

// Puentes de la protoboard: unen las dos mitades de cada columna del bus y llevan 5V, GND, SDA y SCL del Nano
module puentes() {
  for (l = [0 : 3]) {
    y = hy(BUS[l]);
    cable([[hx(XP, -1), y, ZP], [hx(XP, -1), y, ZP + 2], [hx(XP, 1), y, ZP + 2], [hx(XP, 1), y, ZP]], COL_BUS[l], 0.8,
          str("Puente bus ", NOM_BUS[l]));
    yn = pin_nano(NANO_A_BUS[l]);
    cable([[hx(-XP, 3), yn, ZP], [hx(-XP, 3), yn, ZP + 2], [hx(XP, -5), y, ZP + 2], [hx(XP, -5), y, ZP]], COL_BUS[l], 0.8,
          str("Puente Nano ", ["5V", "GND", "A4", "A5"][l], " -> bus ", NOM_BUS[l]));
  }
}

// Linea del bus de cada color de cable de sensor
function linea(c) = c == "red" ? 0 : c == "black" ? 1 : c == "royalblue" ? 2 : 3;

// Cables sobre el piso 2: de las ranuras a los hoyos de las protoboards
module cables_arriba() {
  zs = Z2 + ESP;
  // VL53L0X izquierdo, frente y derecho
  for (t = [0 : 2]) for (i = [0, 1, 2, 3, 5]) {
    xk = (i - 2.5) * PASO_PIN;
    p = t == 0 ? [-TOF_LADO[0] + TOF_ATRAS + 4, TOF_LADO[1] + xk, zs + 4]
      : t == 2 ? [TOF_LADO[0] - TOF_ATRAS - 4, TOF_LADO[1] - xk, zs + 4]
      : [23 + (i - 2.5) * 1.5, TOF_FRENTE_Y - TOF_ATRAS - 4, Z1 + ESP + TOF_BASE + TOF_PIN_Z + TOF_SUBE + i * 1.5 + 14];
    w = i == 5 ? 4 : i;
    nom = str("VL53L0X ", ["izq", "frente", "der"][t], " ", SEN_TOF[i]);
    ly = [16, 16, 8][t] + w * 1.6;
    lz = [zs + 5, zs + 15, zs + 11][t];
    if (i == 5) arriba(p, [hx(-XP, 4), pin_nano(3 + t)], "green", ly, lz, ZP + 17 + t * 1.7, str(nom, " -> Nano A", t));
    else {
      l = linea(COL_TOF[i]);
      arriba(p, [hx(XP, [-2, 2, 3][t]), hy(BUS[l])], COL_TOF[i], ly, lz, z_bus(l), str(nom, " -> bus ", NOM_BUS[l]));
    }
  }
  // TCS34725 y OLED
  for (i = [0 : 3]) {
    l = linea(COL_TCS[i]);
    arriba([-20 - i * 1.5, COLOR_Y - 4.5, zs + 4], [hx(XP, -3), hy(BUS[l])], COL_TCS[i], 4 + i * 1.6, zs + 8,
           z_bus(l), str("TCS34725 ", SEN_TCS[i], " -> bus ", NOM_BUS[l]));
    lo = linea(COL_OLED[i]);
    arriba([20 + i * 1.5, OLED_PINES_Y, zs + 4], [hx(XP, -4), hy(BUS[lo])], COL_OLED[i], 2 + i * 1.6, zs + 7,
           z_bus(lo), str("OLED ", SEN_OLED[i], " -> bus ", NOM_BUS[lo]));
  }
  // L298N -> pines D del Nano (cinta frente a las protoboards)
  for (n = [0 : 5]) {
    c = L298_LOG[n];
    arriba([c[0], -3, zs + 2], [hx(-XP, -4), pin_nano(c[3])], c[2], -6.2, zs + 2 + n * 1.3, ZP + 16 + n * 1.7,
           str("L298N ", c[1], " -> Nano ", NANO_D_NOM[c[3]]));
  }
  // boton -> D2 y GND (fila D)
  for (i = [0 : 1])
    arriba([-28.5 + i * 1.5, -3, zs + 2], [hx(-XP, -5), pin_nano(10 + i)], i == 0 ? "hotpink" : "black", -4.5,
           zs + 2 + i * 1.3, ZP + 16 + i * 1.7, str("Boton ", i == 0 ? "D2" : "GND", " -> Nano ", NANO_D_NOM[10 + i]));
  // potencia: VIN y GND del Nano (cable calibre 22 directo a la protoboard)
  arriba([27, -3, zs + 2], [hx(-XP, 4), pin_nano(14)], "orange", 1, zs + 1.5, ZP + 3, "Interruptor -> Nano VIN", false);
  arriba([13.5, -3, zs + 2], [hx(-XP, 4), pin_nano(13)], "black", -1, zs + 1.5, ZP + 4.5, "L298N GND -> Nano GND", false);
}

// ---------- UNO R3 / UNO Q: placa, shield, cableado ----------
// El mismo piso 2 sirve a las dos placas: se cambia el UNO (y, en la Q, se agrega repisa + mastil + camara)
// sin tocar ninguna pieza impresa comun. El shield con su mini protoboard se saca y se vuelve a clavar.

// Tira hembra de los headers del UNO / del shield (h = indice en UNO_H); z = 0 es la cara del PCB
module tira_hembra(h, alto = 8.5) {
  color(k("black")) translate(concat(uno([UNO_HX[h] - PASO_PIN / 2, UNO_HY[h] - PASO_PIN / 2]), 0))
    cube([len(UNO_H[h]) * PASO_PIN, PASO_PIN, alto]);
}

module uno_placa() {
  q = PLACA == "unoq";
  translate([0, 0, UNO_Z]) {
    color(k(q ? "slategray" : "teal")) difference() {
      translate(uno([0, 0])) cube([UNO[0], UNO[1], 1.6]);
      for (a = UNO_AG) translate(uno(a)) agujero(3.2, 1.6);
    }
    for (h = [0 : 3]) translate([0, 0, 1.6]) tira_hembra(h);        // headers hembra: digital al frente, potencia + analogos atras
    if (q) {
      color(k("silver")) translate(concat(uno([-1, UNO_USB_Y - 4.5]), 1.6)) cube([7.5, 9, 3.2]);          // USB-C
      color(k("black")) translate(concat(uno([30, 20]), 1.6)) cube([22, 14, 0.6]);                    // matriz 8 x 13
      for (i = [0 : 12]) for (j = [0 : 7]) color(k("deepskyblue"))
        translate(concat(uno([31 + i * 1.6, 21 + j * 1.6]), 2.2)) cube([0.8, 0.8, 0.1]);
      color(k("dimgray")) translate(concat(uno([8, 15]), 1.6)) cube([14, 14, 1.5]);                   // QRB2210
      color(k("white")) translate(concat(uno([60, 15]), 1.6)) cube([4.5, 6, 3]);                      // Qwiic
      color(k("dimgray")) for (y = [12, 30]) translate(concat(uno([20, y]), -4)) cube([30, 6, 4]);     // JMEDIA / JMISC
    } else {
      color(k("silver")) translate(concat(uno([-6.3, UNO_USB_Y - 6]), 1.6)) cube([16, 12, 11]);         // USB-B
      color(k("black")) translate(concat(uno([-1.8, 3.3]), 1.6)) cube([13.7, 9, 11]);                  // jack
      color(k("black")) translate(concat(uno([33, 8]), 1.6)) cube([35, 7.5, 4]);                       // ATmega328P DIP
    }
  }
  for (a = UNO_AG) translate(concat(uno(a), UNO_Z + 1.6)) tornillo(8);
}

CAM_Y = MASTIL_XY[1] + MASTIL / 2 + 12;  // lente, adelante del mastil
CAM_USB_X = MASTIL_XY[0] + MASTIL / 2 + 5.5;   // el cable USB de la camara baja afuera del collar del clip

// Proto Shield comercial con mini protoboard de 170 puntos: aqui va el bus I2C y la alimentacion de sensores.
// Sus pines macho entran al UNO y en su cara de arriba lleva tiras hembra (stacking) donde se clavan los dupont.
SHIELD_Z = UNO_Z + 1.6 + (PLACA == "uno_r3" ? 11.5 : 8.5);   // sobre los headers; con el R3, sobre su USB-B (cinta aislante encima)
MINI = [45.7, 34.5, 9.5];                // mini protoboard 170 (17 columnas x 10 filas)
ZHD = SHIELD_Z + 1.6 + 8.5;              // cara de arriba de las tiras hembra del shield
ZBB = SHIELD_Z + 1.6 + MINI[2];          // cara de arriba de la mini protoboard
MINI_C = uno([UNO[0] / 2, UNO[1] / 2]);  // centro de la mini protoboard (centro del shield)
function mini_x(i) = MINI_C[0] + (i - 8) * PASO_PIN;                                   // columna i (0..16, de atras USB a la derecha)
function mini_y(j) = MINI_C[1] + (j < 5 ? -(3.81 + (4 - j) * PASO_PIN) : 3.81 + (j - 5) * PASO_PIN);   // fila j (0..4 atras, 5..9 adelante)

// Bus I2C: 4 columnas contiguas, en el orden de los headers de los sensores (VCC GND SCL SDA).
// Cada columna tiene dos mitades de 5 hoyos; un puente las une (8 hoyos libres por linea).
UBUS_I = [6, 7, 8, 9];
UBUS_NOM = ["VCC", "GND", "SCL", "SDA"];
UBUS_COL = ["red", "black", "cyan", "royalblue"];
VCC_PIN = PLACA == "unoq" ? "3V3" : "5V";                // el jumper de VCC va a 3V3 con la Q y a 5V con el R3
UBUS_PIN = [VCC_PIN, "GND3", "SCL", "SDA"];              // pin del UNO al que va cada linea
function hoyo(j, l) = [mini_x(UBUS_I[l]), mini_y(j)];   // hoyo de la fila j en la linea l del bus

module proto_shield() {
  translate([0, 0, SHIELD_Z]) {
    color(k("royalblue")) translate(uno([0, 0])) cube([UNO[0], UNO[1], 1.6]);
    for (h = [0 : 3]) {
      for (i = [0 : len(UNO_H[h]) - 1])                                                    // pines macho que entran al UNO
        color(k("gold")) translate(concat(uno([UNO_HX[h] + i * PASO_PIN, UNO_HY[h]]), -6)) translate([-0.32, -0.32, 0]) cube([0.64, 0.64, 6]);
      translate([0, 0, 1.6]) tira_hembra(h);                                              // tira hembra de arriba
    }
    translate([MINI_C[0], MINI_C[1], 1.6]) {
      color(k("white")) difference() {
        translate([-MINI[0] / 2, -MINI[1] / 2, 0]) cube(MINI);
        translate([-MINI[0] / 2 - 1, -0.9, MINI[2] - 1]) cube([MINI[0] + 2, 1.8, 2]);      // canal central
      }
      for (i = [0 : 16]) for (j = [0 : 9]) color(k("dimgray"))
        translate([(i - 8) * PASO_PIN - 0.4, mini_y(j) - MINI_C[1] - 0.4, MINI[2] - 0.05]) cube([0.8, 0.8, 0.1]);
      // marca de las 4 columnas del bus
      for (b = [0 : 3]) for (m = [0, 1]) color(k(UBUS_COL[b]))
        translate([mini_x(UBUS_I[b]) - MINI_C[0] - 0.4, mini_y(m * 5) - MINI_C[1] - 1.27, MINI[2] - 0.05]) cube([0.8, 4 * PASO_PIN + 2.54, 0.1]);
    }
  }
}

// Puentes del bus: unen las dos mitades de cada columna (sobre el canal central de la mini protoboard)
module puentes_bus() {
  for (l = [0 : 3]) {
    x = mini_x(UBUS_I[l]);
    cable([[x, mini_y(5), ZBB + 0.4], [x, mini_y(5), ZBB + 2.5], [x, mini_y(4), ZBB + 2.5], [x, mini_y(4), ZBB + 0.4]],
          UBUS_COL[l], 0.8, str("Puente bus ", UBUS_NOM[l]));
  }
}

// Dupont macho con su carcasa apoyada en z (cara de arriba del header o de la protoboard) y el pin hacia abajo
module enchufe(x, y, z) {
  color(k("black")) translate([x - DUPONT[0] / 2, y - DUPONT[0] / 2, z]) cube([DUPONT[0], DUPONT[0], DUPONT[1]]);
  color(k("gold")) translate([x - 0.32, y - 0.32, z - 6]) cube([0.64, 0.64, 6]);
}

// ---------- Cables de arriba (UNO): de las ranuras del piso 2 a las tiras hembra y a la mini protoboard ----------
TOF_NOM = ["izq", "frente", "der"];
UNO_DIG_L298 = ["D5", "D7", "D8", "D9", "D10", "D6"];    // ENA IN1 IN2 IN3 IN4 ENB
FILA_TOF = [7, 8, 9];                                    // fila de la mini protoboard de cada VL53L0X (izq, frente, der)
FILA_TCS = 6;
FILA_OLED = 3;
FILA_ALIM = 2;                                           // enchufes de los 4 cables del bus al UNO
function xk(i) = (i - 2.5) * PASO_PIN;
// extremo de arriba del tramo de abajo de cada cable del VL53L0X (sale de la ranura del piso 2)
function p_tof(t, i) = t == 0 ? [-TOF_LADO[0] + TOF_ATRAS + 4, TOF_LADO[1] + xk(i), ZS + 4]
                     : t == 2 ? [TOF_LADO[0] - TOF_ATRAS - 4, TOF_LADO[1] - xk(i), ZS + 4]
                     : [23 + (i - 2.5) * 1.5, TOF_FRENTE_Y - TOF_ATRAS - 4, Z1 + ESP + TOF_BASE + TOF_PIN_Z + TOF_SUBE + i * 1.5 + 14];
// OLED del mastil: 4 dupont parados sobre su header acodado; el cable sale por arriba de la carcasa
OLED_YH = CLIP_YB - 1.5 + DUPONT[1];                     // punta de los dupont (header recto hacia adelante, sobre la manga)
function oled_x(i) = MASTIL_XY[0] + (i - 1.5) * PASO_PIN; // GND VCC SCL SDA (OLED de cabeza, visto desde atras)
OLED_ZSAL = OLED_MZ + OLED[1] - 2.5;                       // fila de pines del OLED
function oled_def() = [for (i = [0 : 3]) let(l = [1, 0, 2, 3][i])
  [str("OLED ", SEN_OLED[i], " -> bus ", UBUS_NOM[l]), COL_OLED[i],
   PLACA == "unoq" ? [oled_x(i), OLED_YH, OLED_ZSAL] : [20 + i * 1.5, OLED_PINES_Y, ZS + 4],
   hoyo(FILA_OLED, l), ZBB, 0]];

// Cada cable: [nombre, color, origen, destino xy, z de la cara donde se enchufa, tipo]
//   tipo 0: dupont macho en el destino; 1: calibre 22 directo al header (sin carcasa); 2: dupont macho en los dos extremos
// Los 33 primeros son comunes a R3 y Q; los 4 ultimos son los del OLED (R3: salen de la ranura; Q: del mastil).
function cables_uno_def() = concat(
  [for (n = [0 : 5]) let(c = L298_LOG[n])
    [str("L298N ", c[1], " -> ", UNO_DIG_L298[n]), c[2], [c[0], -3, ZS + 2], uno_pin(UNO_DIG_L298[n]), ZHD, 0]],
  [for (i = [0 : 1]) let(p = i == 0 ? "D2" : "GND")
    [str("Boton ", p, " -> ", p), i == 0 ? "hotpink" : "black", [-28.5 + i * 1.5, -3, ZS + 2], uno_pin(p), ZHD, 0]],
  [["Interruptor -> UNO VIN", "orange", [27, -3, ZS + 2], uno_pin("VIN"), ZHD, 1],
   ["L298N GND -> UNO GND", "black", [13.5, -3, ZS + 2], uno_pin("GND2"), ZHD, 1]],
  [for (t = [0 : 2]) [str("VL53L0X ", TOF_NOM[t], " XSHUT -> A", t), "green", p_tof(t, 5), uno_pin(str("A", t)), ZHD, 0]],
  [for (l = [0 : 3]) let(h = hoyo(FILA_ALIM, l))
    [str("Bus ", UBUS_NOM[l], " -> UNO ", UBUS_PIN[l] == "GND3" ? "GND" : UBUS_PIN[l]), UBUS_COL[l],
     [h[0], h[1], ZBB + DUPONT[1] + 0.75], uno_pin(UBUS_PIN[l]), ZHD, 2]],
  [for (t = [0 : 2]) for (i = [0 : 3])
    [str("VL53L0X ", TOF_NOM[t], " ", SEN_TOF[i], " -> bus ", UBUS_NOM[i]), COL_TOF[i], p_tof(t, i), hoyo(FILA_TOF[t], i), ZBB, 0]],
  [for (i = [0 : 3])
    [str("TCS34725 ", SEN_TCS[i], " -> bus ", UBUS_NOM[i]), COL_TCS[i], [-20 - i * 1.5, COLOR_Y - 4.5, ZS + 4], hoyo(FILA_TCS, i), ZBB, 0]],
  oled_def());
CABLES_UNO = cables_uno_def();

// Ruta: sube a za, va de lado a la columna xa, avanza a yb, sube a la altura de carril zl = ZBB + prm[3],
// corre hasta el carril ye (prm[4]), va a la columna del enchufe y llega a el por arriba.
function ruta_uno(p0, pd, zfin, prm) =
  let(za = prm[0], xa = prm[1], yb = prm[2], zl = ZBB + prm[3], ye = prm[4])
  [p0, [p0[0], p0[1], za], [xa, p0[1], za], [xa, yb, za], [xa, yb, zl], [xa, ye, zl], [pd[0], ye, zl], [pd[0], pd[1], zl],
   [pd[0], pd[1], zfin]];

// Un cable (n = su lugar en CABLES_UNO) con sus enchufes; hilo / enchufes se pueden dibujar por separado (pruebas de choque)
module cable_uno(n, hilo = true, enchufes = true) {
  c = CABLES_UNO[n];
  zd = c[4] + (c[5] == 1 ? 1.2 : DUPONT[1] + 0.75);
  if (hilo) cable(ruta_uno(c[2], c[3], zd, PRM_UNO[n]), c[1], c[5] == 1 ? CABLE_POT : CABLE, c[0]);
  if (enchufes) {
    if (c[5] != 1) enchufe(c[3][0], c[3][1], c[4]);
    if (c[5] == 2) enchufe(c[2][0], c[2][1], c[2][2] - DUPONT[1] - 0.75);
  }
}

// grupo: "base" (33 cables comunes), "oled" (los 4 del OLED), "todo"
module cables_uno(grupo = "todo") {
  for (n = [0 : len(CABLES_UNO) - 1]) if (grupo == "todo" || (grupo == "oled") == (n >= len(CABLES_UNO) - 4)) cable_uno(n);
}

// RUTAS_INICIO
// [za, xa, yb, dz, ye] por cable, en el orden de CABLES_UNO (generado con un buscador de rutas sin choques)
PRM_BASE = [
  [70.5, 15.8, -3, 15.4, -9.6], [72.5, 10.2, -3, 15.4, -3], [77.5, 7, -3, 15.4, -5],
  [80, -4.2, -3, 15.4, -5], [67.5, -10.2, -3, 15.4, -9.4], [79, -17.4, -3, 15.4, -13],
  [76, -29, -3, 19.9, -10.6], [73, -26.6, -3, 18.4, -11], [76, 28.6, -3, 21.4, -43.6],
  [67, 23.4, -3, 22.4, -39.6], [75, -33, 15.5, 18.9, -52.4], [72, 26.9, 17.5, 31.4, -32.8],
  [75.5, 29.7, 17.5, 28.9, -42], [110.45, -5.08, -40.22, 21.9, -47.6], [109.45, -2.54, -40.22, 15.4, -46],
  [114.45, 0, -40.22, 30.9, -42], [119.95, 2.54, -40.22, 26.4, -44], [78, -21.8, 15.5, 29.4, -19.6],
  [77.5, -17.4, 8, 23.4, -32.4], [75.5, -24.6, 8, 34.9, -10], [67, -26.6, 5, 28.9, -24.2],
  [77, 17.3, 17.5, 27.4, -15.8], [80.5, 18.9, 15.5, 23.4, -8.6], [80.5, 24.1, 5, 27.4, -18.4],
  [74, 32.9, 17.5, 16.9, -16.4], [75.5, 16.9, 10.5, 23.9, -6.6], [78.5, 18.9, 2, 17.4, -12.2],
  [72.5, 17.3, 2, 21.9, -14], [72, 32.1, 8, 15.4, -16.2], [72.5, -19.4, 2, 16.9, -24.2],
  [74, -19, 19.3, 21.4, -27.4], [70.5, -23, 10.5, 15.4, -26.8], [72, -25, -2.5, 16.9, -28]
];   // 33 cables comunes a R3 y Q
PRM_OLED_R3 = [
  [73.5, 20.5, 8, 30.4, -14.8], [71, 22.1, 17.5, 24.9, -25.4], [69, 26.9, 2, 27.9, -33.2],
  [67, 26.1, -1, 19.9, -26.2]
];   // OLED en el piso 2 (R3)
PRM_OLED_Q = [
  [155.8, -4.31, -9, 57.4, -17.6], [157.3, -2.77, -13, 34.4, -17], [152.8, 4.27, -8, 59.4, -32.2],
  [149.8, 6.31, -9, 32.4, -29]
];   // OLED en el mastil (Q)
// RUTAS_FIN
PRM_UNO = concat(PRM_BASE, PLACA == "unoq" ? PRM_OLED_Q : PRM_OLED_R3);

// ---------- Solo UNO Q: mastil, camara, repisa, hub, OLED del mastil ----------

module mastil() {
  // provisional: solo marca el lugar; el PTR, su anclaje y el hueco se disenan con la medida oficial
  color("silver", 0.45) translate([MASTIL_XY[0] - MASTIL / 2, MASTIL_XY[1] - MASTIL / 2, Z2 + ESP])
    cube([MASTIL, MASTIL, CAM_Z - 6 - Z2 - ESP]);
}

// Pedestal impreso en lugar del perfil 2020: M4 desde abajo del piso 2 a un inserto de calor M4
INSERTO_M4 = [5.6, 8];   // agujero y largo del inserto M4 (medir el suyo)
module pedestal() {
  difference() {
    translate([-MASTIL / 2, -MASTIL / 2, 0]) cube([MASTIL, MASTIL, CAM_Z - 6 - Z2 - ESP]);
    agujero(INSERTO_M4[0], INSERTO_M4[1] + 1);
    agujero(4.2, 20);    // deja pasar el tornillo mas largo que el inserto
  }
}

// Cabeza de la camara (pieza impresa, provisional): manga sobre el PTR, brazo y placa inclinada CAM_INCL hacia abajo
module cabeza_camara() {
  m = MASTIL + 6;
  color(k($col)) {
    difference() {
      translate([MASTIL_XY[0] - m / 2, MASTIL_XY[1] - m / 2, CAM_Z - 26]) cube([m, m, 26]);
      translate([MASTIL_XY[0] - MASTIL / 2 - 0.2, MASTIL_XY[1] - MASTIL / 2 - 0.2, CAM_Z - 27]) cube([MASTIL + 0.4, MASTIL + 0.4, 21]);
      translate([MASTIL_XY[0] - m / 2 - 1, MASTIL_XY[1], CAM_Z - 16]) rotate([0, 90, 0]) cylinder(d = 2.5, h = 5);   // M3 opresor a la ranura
    }
    translate([MASTIL_XY[0], CAM_Y, CAM_Z + CAM_DZ]) rotate([-CAM_INCL, 0, 0]) difference() {         // placa porta camara
      union() {
        translate([-CAM_PCB / 2 - 3, -10.6, -CAM_PCB / 2 - 3]) cube([CAM_PCB + 6, 3, CAM_PCB + 6]);
        difference() {                                                                                // marco: centra el PCB (0.5 mm por lado)
          translate([-CAM_PCB / 2 - 3, -7.6, -CAM_PCB / 2 - 3]) cube([CAM_PCB + 6, 2, CAM_PCB + 6]);
          translate([-CAM_PCB / 2 - 0.5, -8, -CAM_PCB / 2 - 0.5]) cube([CAM_PCB + 1, 3, CAM_PCB + 1]);
        }
      }
      translate([-11, -11, -11]) cube([22, 4, 22]);                                                  // ventana del centro
      translate([-16, -11, 0]) cube([5, 4, 11]);                                                     // conector USB: arriba a la izquierda visto por atras
      translate([-9, -11, 11]) cube([11, 4, 5.5]);
      translate([-5, -11, -16]) cube([10, 4, 5]);                                                    // cables de alimentacion: abajo al centro
      for (x = [-1, 1]) for (z = [-1, 1]) translate([x * 14, -11, z * 14]) rotate([-90, 0, 0])       // M2 + tuerca atras, +-1 mm de juego
        hull() for (a = [-1, 1]) for (b = [-1, 1]) translate([a, b, 0]) cylinder(d = 2.3, h = 4, $fn = 16);
    }
    translate([MASTIL_XY[0] - 5, MASTIL_XY[1] + m / 2 - 1, CAM_Z - 26]) cube([10, CAM_Y - MASTIL_XY[1] - m / 2 - 6, 12]);   // brazo
    for (s = [-1, 1]) hull() {                                                                         // costillas: manga -> orillas de la placa
      translate([MASTIL_XY[0], CAM_Y, CAM_Z + CAM_DZ]) rotate([-CAM_INCL, 0, 0])
        translate([s > 0 ? CAM_PCB / 2 + 1 : -CAM_PCB / 2 - 3, -10.6, -CAM_PCB / 2 - 3]) cube([2, 3, CAM_PCB + 6]);
      translate([MASTIL_XY[0] + (s > 0 ? CAM_PCB / 2 + 1 : -CAM_PCB / 2 - 3), MASTIL_XY[1], CAM_Z - 10]) cube([2, m / 2, 10]);
    }
    for (s = [-1, 1]) translate([MASTIL_XY[0] + (s > 0 ? m / 2 - 0.5 : -CAM_PCB / 2 - 3), MASTIL_XY[1], CAM_Z - 10])   // pie de las costillas
      cube([CAM_PCB / 2 + 3.5 - m / 2, m / 2, 10]);
    // OLED atras, de pie, header recto hacia adelante por encima de la manga; entra por arriba en 2 rieles
    yb = MASTIL_XY[1] - m / 2;
    xo = OLED[0] / 2;
    difference() {
      union() {
        translate([MASTIL_XY[0] - xo - 2.4, yb - 1.5, CAM_Z - 26]) cube([2 * xo + 4.8, 1.5, 26]);
        for (s = [-1, 1]) translate([MASTIL_XY[0] + s * (xo + 0.9) - 1.5, yb - 8, CAM_Z - 26]) cube([3, 8, OLED_MZ + OLED[1] - CAM_Z + 26]);
      }
      translate([MASTIL_XY[0] - xo - 0.2, yb - 4 - 1.6 - 0.2, OLED_MZ - 0.2]) cube([2 * xo + 0.4, 2, 40]);   // ranura del PCB
      translate([MASTIL_XY[0] - xo + 0.65, yb - 9, OLED_MZ - 0.2]) cube([2 * xo - 1.3, 6, 40]);             // ventana
    }
  }
}

// Camara UVC con su cabeza impresa
module camara(fov = true) {
  cabeza_camara();
  translate([MASTIL_XY[0], CAM_Y, CAM_Z + CAM_DZ]) rotate([-CAM_INCL, 0, 0]) {
    color(k("darkgreen")) translate([-CAM_PCB / 2, -7.6, -CAM_PCB / 2]) cube([CAM_PCB, 1.6, CAM_PCB]);
    color(k("black")) translate([-7, -6, -7]) cube([14, 6, 14]);                                       // porta lente M12
    color(k("black")) rotate([-90, 0, 0]) cylinder(d = 14, h = 8);                                    // lente
    for (x = [-1, 1]) for (z = [-1, 1]) color(k("dimgray")) translate([x * 14, -6, z * 14]) rotate([90, 0, 0]) cylinder(d = 3.8, h = 6); // M2
    if (fov) intersection() {
      color("yellow", 0.18) hull() {
        sphere(0.1);
        translate([0, 400, 0]) cube([2 * 400 * tan(CAM_FOV[0] / 2), 0.1, 2 * 400 * tan(CAM_FOV[1] / 2)], center = true);
      }
      rotate([CAM_INCL, 0, 0]) translate([-500, -500, -CAM_Z - CAM_DZ]) cube([1000, 1000, 1000]);
    }
  }
}

// Repisa del hub: sigue el contorno del robot; ranuras para 2 cinchos
module repisa() {
  color(k($col)) difference() {
    intersection() {
      translate([-56, 22, 0]) cube([112, 38, REPISA_ESP]);
      cuadrado_redondo(L, R_ESQ, REPISA_ESP);
    }
    for (p = REPISA_POSTES) translate(p) agujero(M3_PASO, REPISA_ESP);
    for (x = [-1, 1]) for (y = [-1, 1]) translate([x * 25 - 2, HUB_Y + y * (HUB[1] / 2 + 3) - 1.5, -1]) cube([4, 3, 5]);
  }
}

module hub() {
  translate([0, HUB_Y, REPISA_Z + REPISA_ESP]) {
    color(k("darkslategray")) translate([-HUB[0] / 2, -HUB[1] / 2, 0]) cube(HUB);
    for (i = [0 : 3]) color(k("royalblue")) translate([-30 + i * 20, HUB[1] / 2 - 0.5, 3]) cube([13, 1, 5]);   // puertos A
    color(k("silver")) translate([HUB[0] / 2 - 0.5, -4.5, 4]) cube([1, 9, 3.2]);                           // entrada PD
    for (x = [-1, 1]) color(k("black")) translate([x * 25 - 1.5, -HUB[1] / 2 - 0.5, 0]) cube([3, HUB[1] + 1, HUB[2] + 0.5]); // cinchos
  }
}

// Cables: hub -> USB-C del UNO Q (en angulo) y camara -> hub
module cables_usb() {
  u = uno([0, UNO_USB_Y]);
  zu = UNO_Z + 1.6 + 1.6;
  zh = REPISA_Z + REPISA_ESP + HUB[2] / 2;
  color(k("dimgray")) translate([u[0] - 9, u[1] - 4.5, zu - 3]) cube([9, 9, 6]);                      // USB-C en angulo
  cable([[-HUB[0] / 2 - 1.75, HUB_Y, zh], [-HUB[0] / 2 - 4, HUB_Y, zh], [-HUB[0] / 2 - 4, 19, zh], [-44, 8, zh - 8],
         [u[0] - 5, 0, zu + 6], [u[0] - 5, u[1], zu + 6], [u[0] - 5, u[1], zu + 3]], "dimgray", 3.5, "Hub -> UNO Q USB-C");
  // camara -> hub: baja junto al collar, pasa por encima del hub y entra por su cara de atras
  xm = CAM_USB_X;
  zc = REPISA_Z + REPISA_ESP + HUB[2] + 6;
  cable([[xm, MASTIL_XY[1], CAM_Z - 22], [xm, MASTIL_XY[1], zc], [xm, HUB_Y + HUB[1] / 2 + 4, zc],
         [xm, HUB_Y + HUB[1] / 2 + 4, REPISA_Z + REPISA_ESP + 6], [xm, HUB_Y + HUB[1] / 2 + 1.75, REPISA_Z + REPISA_ESP + 6]],
        "dimgray", 3.5, "Camara -> hub");
}

// Clip del OLED (pieza impresa solo de la Q): collar sobre el mastil (MASTIL) y placa con dos rieles; el OLED entra
// de lado (por +X) con su header acodado hacia abajo. Provisional como el mastil: la fijacion al PTR se define con la medida oficial.
CLIP_OW = OLED[0] + 0.4;                 // ancho de la ranura
CLIP_ZT = OLED_MZ + OLED[1];             // borde de arriba del OLED
module clip_oled() {
  yb = CLIP_YB;
  mx = MASTIL_XY[0];
  my = MASTIL_XY[1];
  w = CLIP_OW / 2 + 2;                   // mitad del ancho de la placa
  color(k($col)) difference() {
    union() {
      // collar sobre el mastil (paredes de 3 mm, como la manga de la camara)
      translate([mx - MASTIL / 2 - 3, yb, CLIP_Z0]) cube([MASTIL + 6, my - yb + MASTIL / 2 + 3, 12]);
      // placa de atras, del collar al borde de arriba del OLED (no pasa de yb: arriba queda pegada a la manga de la camara)
      translate([mx - w, yb - 2, CLIP_Z0]) cube([2 * w, 2, CLIP_ZT + 1.2 - CLIP_Z0]);
      translate([mx - w, yb, CLIP_Z0]) cube([2 * w, 0.5, 12]);
      // riel de abajo: labio al frente del PCB y piso que lo une a la placa
      translate([mx - w, yb - 5.5, OLED_MZ - 1.2]) cube([2 * w, 3.5 + 0.5, 3.2]);
      // rieles de arriba, a los lados de los pines (header acodado hacia arriba)
      for (s = [-1, 1]) translate([mx + (s < 0 ? -w : 7), yb - 5.5, CLIP_ZT - 2]) cube([w - 7, 3.5 + 0.5, 3.2]);
      // tope de la izquierda (el OLED entra por +X)
      translate([mx - w, yb - 5.5, OLED_MZ - 1.2]) cube([2, 3.5 + 0.5, OLED[1] + 2.4]);
    }
    // hueco del mastil
    translate([mx - MASTIL / 2 - 0.2, my - MASTIL / 2 - 0.2, CLIP_Z0 - 1]) cube([MASTIL + 0.4, MASTIL + 0.4, 14]);
    // ranura del PCB (1.6 + 0.4) entre la placa y los labios, abierta por +X
    translate([mx - CLIP_OW / 2, yb - 4, OLED_MZ - 0.2]) cube([CLIP_OW / 2 + w + 1, RANURA, OLED[1] + 0.4]);
  }
}

// OLED en la cara de atras del mastil, de cabeza: PCB, vidrio, header acodado (pines hacia arriba) y sus 4 carcasas dupont
module oled_mastil() {
  translate([MASTIL_XY[0], CLIP_YB - 4, OLED_MZ]) rotate([90, 0, 0]) {       // z local -> -Y, y local -> +Z
    color(k("navy")) translate([-OLED[0] / 2, 0, 0]) cube([OLED[0], OLED[1], 1.6]);
    color(k("black")) translate([-13, 2.4, 1.6]) cube([26, 19, 1.4]);
    color(k("dimgray")) translate([-2 * PASO_PIN, OLED[1] - 3.75, -2.5]) cube([4 * PASO_PIN, 2.5, 2.5]);  // header recto, atras
    for (i = [0 : 3]) {
      x = (i - 1.5) * PASO_PIN;
      color(k("black")) translate([x - DUPONT[0] / 2, OLED[1] - 3.75, -2.5 - DUPONT[1]]) cube([DUPONT[0], DUPONT[0], DUPONT[1]]);
    }
  }
}

// Todo lo de la Q que se agrega al chasis comun (paso 11)
module q_extra(fov = true) {
  mastil();
  camara(fov);
  oled_mastil();
  translate([0, 0, REPISA_Z]) repisa();
  for (p = REPISA_POSTES) translate(concat(p, REPISA_Z + REPISA_ESP)) tornillo(8);
  hub();
  cables_usb();
  cables_uno("oled");
}

// Piso 2 armado en la mesa (paso 7 del manual), en su posicion dentro del robot.
// eco = true: los cables que lleva imprimen su linea CABLE| (el ensamble los dibuja una sola vez)
module sub_piso2(eco = false) {
  color(k("lightsteelblue")) translate([0, 0, Z2]) piso2();
  for (p = POSTES) translate([p[0], p[1], Z2 + ESP]) tornillo(8);
  if (PLACA == "nano") {
    protoboards();
    nano();
    puentes();
    translate([0, 0, ZS]) oled_modulo(eco ? "OLED" : "");
  } else {
    uno_placa();
    proto_shield();
    puentes_bus();
    if (PLACA == "uno_r3") translate([0, 0, ZS]) oled_modulo(eco ? "OLED" : "");
  }
  translate([BOTON_XY[0], BOTON_XY[1], ZS]) boton();
  translate([SWITCH_XY[0], SWITCH_XY[1], ZS]) interruptor();
}

module ensamble() {
  es_uno = PLACA != "nano";
  paso(1) {
    translate([0, 0, Z1]) piso1($col = "lightsteelblue");
    for (s = [-1, 1]) {
      motor(s);
      translate([s * X_MOT, 0, Z1 - MOT_H - 2 + 0.3]) cuna_motor();
      for (y = CUNA_Y) translate([s * X_MOT, y, Z1 + ESP]) tornillo(12);
      if (PASO == 1 || PASO == 2) cables_motor(s, false);
    }
  }
  paso(2) {
    for (s = [-1, 1]) rueda(s);
    translate([0, PATIN_Y, 0]) patin();
    for (x = [-1, 1]) translate([x * PATIN_X, PATIN_Y, Z1 + ESP]) tornillo(8);
    translate([0, COLOR_Y, 2]) capucha_color();
    for (x = [-1, 1]) translate([x * 17, COLOR_Y, Z1 + ESP]) tornillo(8);
    translate([0, COLOR_Y, COLOR_Z + 0.8]) tcs_modulo();
    tcs_cables();
  }
  paso(3) {
    tornillos_l298();
    l298();
    if (PASO == 0 || PASO >= 3) for (s = [-1, 1]) cables_motor(s);
  }
  paso(4) {
    bateria();
    conector_t(true, false);
  }
  paso(5) {
    translate([0, 0, Z1 + ESP]) tof_lugares() soporte_tof($col = "lightsteelblue");
    translate([0, 0, Z1]) tof_lugares() for (x = [-1, 1]) translate([x * TOF_FIJ[0], TOF_FIJ[1], 0]) mirror([0, 0, 1]) tornillo(8);
    translate([0, TOF_FRENTE_Y, Z1 + ESP + TOF_BASE]) tof_modulo(TOF_SUBE, 23, 14, "VL53L0X frente");
    for (s = [-1, 1]) translate([s * TOF_LADO[0], TOF_LADO[1], Z1 + ESP + TOF_BASE]) rotate([0, 0, -s * 90])
      tof_modulo(Z2 + 7 - Z1 - ESP - TOF_BASE - TOF_PIN_Z, 0, 0, s < 0 ? "VL53L0X izq" : "VL53L0X der");
  }
  paso(6) cables_l298_logica();
  // paso 7: el piso 2 se arma en la mesa (PIEZA = "sub_piso2"); aqui se ve levantado sobre el chasis
  if (es_uno && PASO == 7) translate([0, 0, 55]) sub_piso2();
  paso(8) {
    sub_piso2(true);
    cables_boton();
    if (PASO == 8 || PASO == 9) conector_t(false, true, false);
    arnes_potencia(PASO == 0 || PASO >= 10);
  }
  paso(9) if (es_uno) cables_uno(PLACA == "uno_r3" ? "todo" : "base"); else cables_arriba();
  paso(10) conector_t(false, true, true);
  if (PLACA == "unoq") paso(11) q_extra();
}

if (PIEZA == "ensamble") ensamble();
else if (PIEZA == "piso1") piso1();
else if (PIEZA == "piso2") piso2();
else if (PIEZA == "cuna_motor") cuna_motor();
else if (PIEZA == "capucha_color") translate([0, 0, Z1 - 2]) rotate([180, 0, 0]) capucha_color();
else if (PIEZA == "soporte_tof") soporte_tof();
else if (PIEZA == "patin") translate([0, 0, Z1]) rotate([180, 0, 0]) patin();
else if (PIEZA == "prueba") prueba();
else if (PIEZA == "placa") placa();
else if (PIEZA == "placa_vista") {
  color("orange") placa();
  color("dimgray") translate([0, 0, -1.01]) cube([CAMA, CAMA, 1]);
}
else if (PIEZA == "sub_piso2") sub_piso2();
else if (PIEZA == "repisa") repisa();
else if (PIEZA == "pedestal") pedestal();
else if (PIEZA == "cabeza_camara") translate([0, 0, -(CAM_Z - 26)]) cabeza_camara();
else if (PIEZA == "clip_oled") translate([0, 0, -CLIP_Z0]) clip_oled();
else if (PIEZA == "placa_q") placa_q();
else if (PIEZA == "placa_q_vista") {
  color("orange") placa_q();
  color("dimgray") translate([0, 0, -1.01]) cube([CAMA, CAMA, 1]);
}
// shield visto desde arriba: piso 2 y UNO en gris, shield y enchufes a color (sin los hilos)
else if (PIEZA == "det_shield") {
  gris() { translate([0, 0, Z2]) piso2(); uno_placa(); }
  proto_shield();
  puentes_bus();
  for (n = [0 : len(CABLES_UNO) - 1]) cable_uno(n, false, true);      // solo los enchufes: se ve a donde va cada cable
}
// camino USB de la Q: repisa, hub, camara y cables
else if (PIEZA == "det_q_usb") {
  gris() { translate([0, 0, Z2]) piso2(); uno_placa(); proto_shield(); }
  q_extra(false);
}
else if (PIEZA == "det_insertos") {
  $col = "lightsteelblue";
  piso1();
  for (i = [0 : 1]) translate([80 + i * 20, 10, 0]) cuna_motor();
  translate([90, 60, 0]) capucha_color();
  translate([90, -50, 0]) patin();
}
else if (PIEZA == "det_motor") { motor(-1); cables_motor(-1, false); }
else if (PIEZA == "det_l298") { l298(); tornillos_l298(); }
else if (PIEZA == "det_arnes") {
  gris() { translate([0, 0, Z1]) piso1($col = "lightsteelblue"); bateria(); conector_t(true, false); tornillos_l298(); }
  l298();
  conector_t(false, true, UNIDO);
  arnes_potencia(UNIDO);
  translate([SWITCH_XY[0], SWITCH_XY[1], Z2 + ESP]) interruptor();
}
else if (PIEZA == "marca") color("red") translate(MARCA) sphere(d = 1.5, $fn = 12);
