Happenedspice17/sumo-v-ia/docs/diagrama_conexiones.pdf

# Batería 2S

+

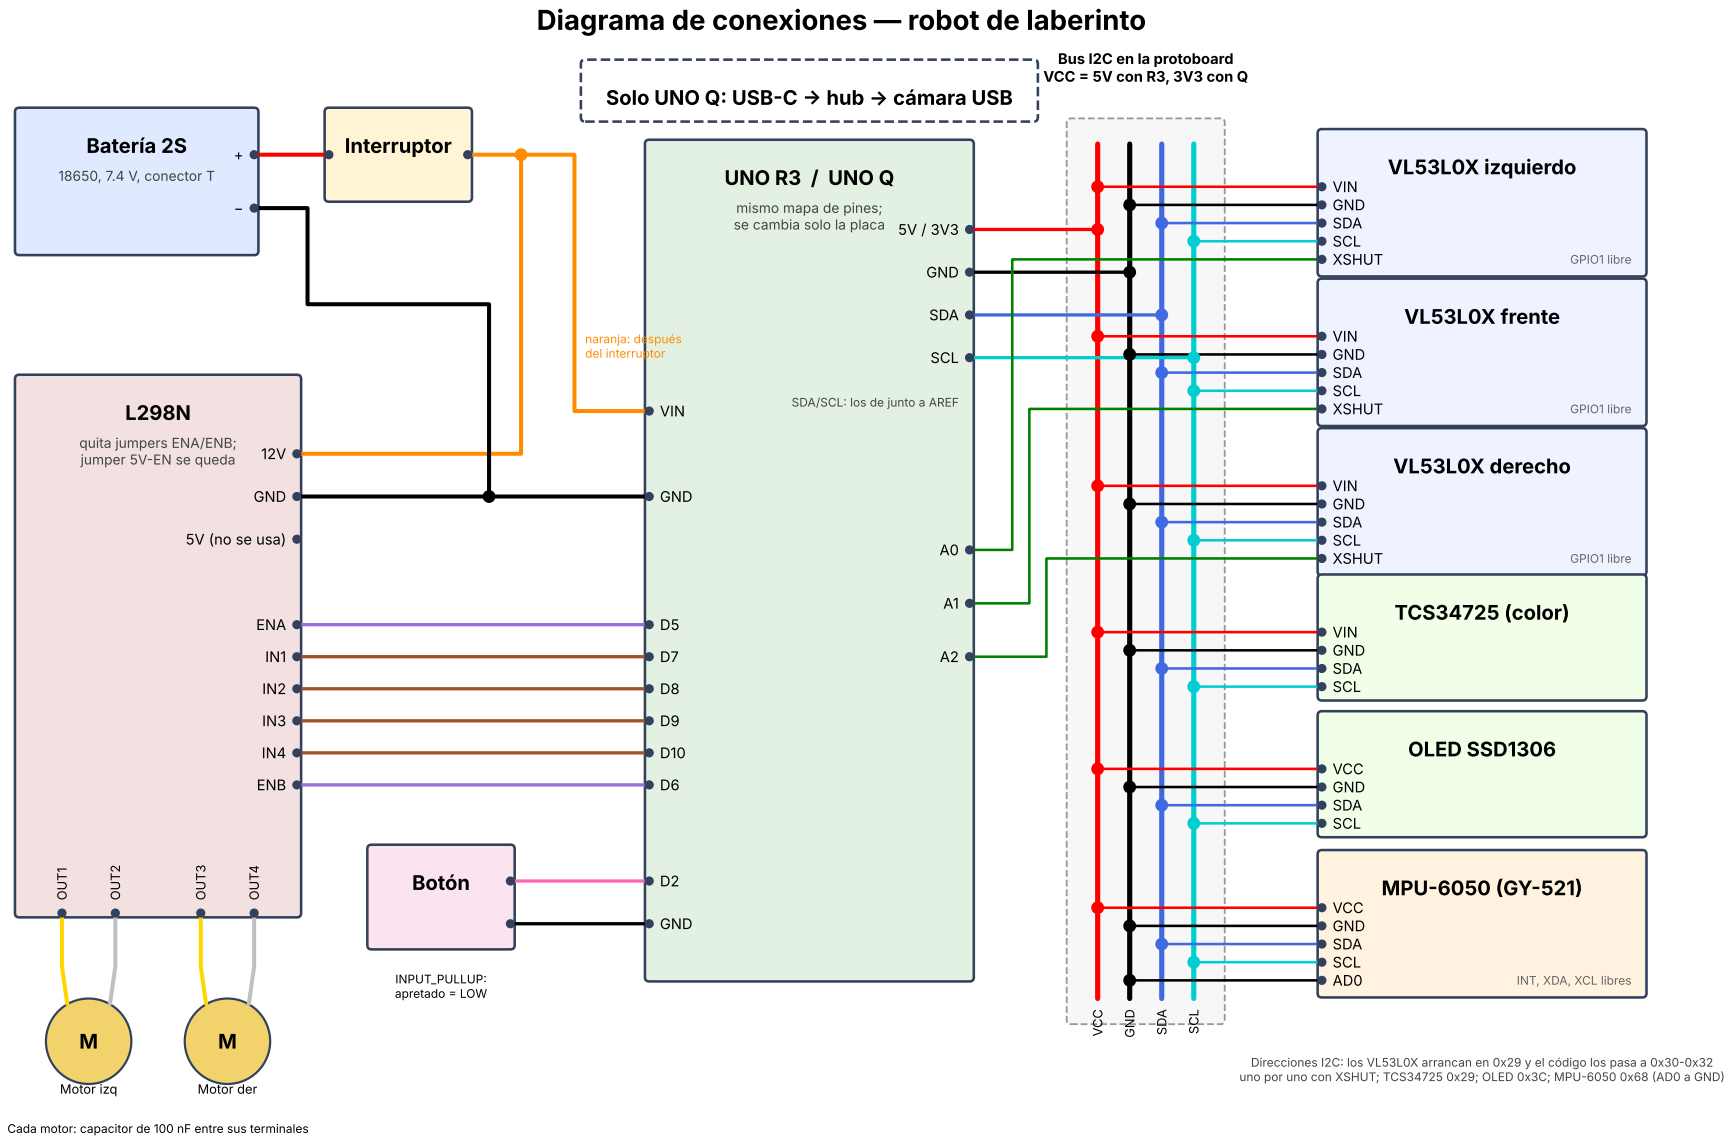
[picture p199: page 1]

Diagrama de conexiones — robot de laberinto

Bus I2C en la protoboard

Solo UNO Q: USB-C → hub → cámara USB

mismo mapa de pines;
se cambia solo la placa

SDA/SCL: los de junto a AREF

quita jumpers ENA/ENB;

Direcciones I2C: los VL53L0X arrancan en 0x29 y el código los pasa a 0x30-0x32
uno por uno con XSHUT; TCS34725 0x29; OLED 0x3C; MPU-6050 0x68 (AD0 a GND)

Cada motor: capacitor de 100 nF entre sus terminales
