Happenedspice17/sumo-v-ia/docs/generar_manuales.py

"""Genera manual_ensamble.pdf (manual de armado), bom.csv y cables.csv. El manual de uso está en docs/manual_uso.md (docs/md_pdf.sh).

Uso: python3 docs/generar_manuales.py
Usa las imagenes de chasis/img/ (python3 chasis/renders.py; si falta alguna, dibuja un recuadro gris) y la
lista de cables que chasis.scad imprime con openscad. Si no hay openscad, usa docs/cables.csv.
"""
import csv
import os
import re
import shutil
import subprocess
import tempfile

from reportlab.lib import colors
from reportlab.lib.pagesizes import letter
from reportlab.lib.styles import ParagraphStyle, getSampleStyleSheet
from reportlab.lib.units import mm
from reportlab.pdfbase import pdfmetrics
from reportlab.pdfbase.ttfonts import TTFont
from reportlab.platypus import (CondPageBreak, Image, KeepTogether, PageBreak, Paragraph, SimpleDocTemplate, Spacer,
                                Table, TableStyle)

AQUI = os.path.dirname(os.path.abspath(__file__))
RAIZ = os.path.dirname(AQUI)
IMG = os.path.join(RAIZ, "chasis", "img")
SCAD = os.path.join(RAIZ, "chasis", "chasis.scad")

# ---------- Estilos ----------
FUENTE, NEGRITA, CURSIVA = "Helvetica", "Helvetica-Bold", "Helvetica-Oblique"
for f, n in (("DejaVuSans.ttf", "DV"), ("DejaVuSans-Bold.ttf", "DVB"), ("DejaVuSans-Oblique.ttf", "DVI")):
    ruta = os.path.join("/usr/share/fonts/truetype/dejavu", f)
    if os.path.exists(ruta):
        pdfmetrics.registerFont(TTFont(n, ruta))
if "DV" in pdfmetrics.getRegisteredFontNames():
    FUENTE, NEGRITA = "DV", "DVB"
    CURSIVA = "DVI" if "DVI" in pdfmetrics.getRegisteredFontNames() else "DV"
    pdfmetrics.registerFontFamily("DV", normal="DV", bold="DVB", italic=CURSIVA, boldItalic="DVB")

AZUL = colors.HexColor("#1f4e79")
AZUL_OSC = colors.HexColor("#14213d")
ORO = colors.HexColor("#c8902a")
FILA = colors.HexColor("#f3f5f8")
REJILLA = colors.HexColor("#c3c9d2")
VERIFICA = colors.HexColor("#e8eef9")
AVISO = colors.HexColor("#fff4e5")
ANCHO = 176 * mm
FALTAN = set()   # imágenes que no existían al construir (se dibuja un recuadro gris)

base = getSampleStyleSheet()
S = {
    "t": ParagraphStyle("t", parent=base["Title"], fontName=NEGRITA, fontSize=30, leading=36, textColor=AZUL,
                        alignment=0, spaceAfter=4),
    "st": ParagraphStyle("st", parent=base["Normal"], fontName=FUENTE, fontSize=14, leading=19, textColor=AZUL_OSC),
    "h1": ParagraphStyle("h1", parent=base["Heading1"], fontName=NEGRITA, fontSize=19, leading=24,
                         textColor=AZUL, spaceBefore=8, spaceAfter=6),
    "h2": ParagraphStyle("h2", parent=base["Heading2"], fontName=NEGRITA, fontSize=13, leading=17,
                         textColor=AZUL_OSC, spaceBefore=8, spaceAfter=4),
    "h3": ParagraphStyle("h3", parent=base["Heading3"], fontName=NEGRITA, fontSize=11.5, leading=15,
                         textColor=AZUL_OSC, spaceBefore=6, spaceAfter=3),
    "p": ParagraphStyle("p", parent=base["Normal"], fontName=FUENTE, fontSize=10, leading=14, spaceAfter=4),
    "pz": ParagraphStyle("pz", parent=base["Normal"], fontName=FUENTE, fontSize=8.6, leading=11.5, spaceAfter=4),
    "li": ParagraphStyle("li", parent=base["Normal"], fontName=FUENTE, fontSize=10, leading=14,
                         leftIndent=14, bulletIndent=2, spaceAfter=3),
    "c": ParagraphStyle("c", parent=base["Normal"], fontName=FUENTE, fontSize=8.6, leading=11),
    "cb": ParagraphStyle("cb", parent=base["Normal"], fontName=NEGRITA, fontSize=8.6, leading=11,
                         textColor=colors.white),
    "fig": ParagraphStyle("fig", parent=base["Normal"], fontName=CURSIVA, fontSize=9, leading=12,
                          textColor=AZUL_OSC, alignment=1, spaceAfter=6),
    "pie": ParagraphStyle("pie", parent=base["Normal"], fontName=FUENTE, fontSize=8.5, leading=11,
                          textColor=colors.HexColor("#666"), alignment=1),
}


def p(t):
    return Paragraph(t, S["p"])


def h1(t):
    return Paragraph(t, S["h1"])


def h2(t):
    return Paragraph(t, S["h2"])


def h3(t):
    return Paragraph(t, S["h3"])


def fig(t):
    return Paragraph(t, S["fig"])


def lista(items, num=False):
    return [Paragraph(t, S["li"], bulletText=f"{i}." if num else "•") for i, t in enumerate(items, 1)]


def tabla(filas, anchos, cabecera=True):
    datos = [[Paragraph(str(c), S["cb"] if (cabecera and i == 0) else S["c"]) for c in f] for i, f in enumerate(filas)]
    escala = ANCHO / (sum(anchos) * mm) if sum(anchos) * mm > ANCHO else 1
    t = Table(datos, colWidths=[a * mm * escala for a in anchos], repeatRows=1 if cabecera else 0)
    estilo = [("GRID", (0, 0), (-1, -1), 0.5, REJILLA),
              ("VALIGN", (0, 0), (-1, -1), "TOP"),
              ("LEFTPADDING", (0, 0), (-1, -1), 5), ("RIGHTPADDING", (0, 0), (-1, -1), 5),
              ("TOPPADDING", (0, 0), (-1, -1), 3), ("BOTTOMPADDING", (0, 0), (-1, -1), 4)]
    if cabecera:
        estilo.append(("BACKGROUND", (0, 0), (-1, 0), AZUL))
        estilo += [("BACKGROUND", (0, i), (-1, i), FILA) for i in range(2, len(filas), 2)]
    t.setStyle(TableStyle(estilo))
    return t


def caja(texto, color=AVISO, ancho=ANCHO, borde=colors.HexColor("#e0a050")):
    t = Table([[Paragraph(texto, S["p"])]], colWidths=[ancho])
    t.setStyle(TableStyle([("BACKGROUND", (0, 0), (-1, -1), color), ("BOX", (0, 0), (-1, -1), 0.5, borde),
                           ("LEFTPADDING", (0, 0), (-1, -1), 8), ("TOPPADDING", (0, 0), (-1, -1), 6),
                           ("BOTTOMPADDING", (0, 0), (-1, -1), 6)]))
    return t


def verifica(texto, ancho=ANCHO):
    t = Table([[Paragraph("<b>Verifica:</b> " + texto, S["p"])]], colWidths=[ancho])
    t.setStyle(TableStyle([("BACKGROUND", (0, 0), (-1, -1), VERIFICA),
                           ("LEFTPADDING", (0, 0), (-1, -1), 8), ("TOPPADDING", (0, 0), (-1, -1), 6),
                           ("BOTTOMPADDING", (0, 0), (-1, -1), 7)]))
    return t


def img(ruta, ancho_mm, alto_max_mm=None):
    if not os.path.isabs(ruta):
        ruta = os.path.join(IMG, ruta)
    if not os.path.exists(ruta):
        FALTAN.add(os.path.basename(ruta))
        t = Table([[Paragraph(f"[falta imagen {os.path.basename(ruta)}]", S["fig"])]], colWidths=[ancho_mm * mm],
                  rowHeights=[min(alto_max_mm or ancho_mm * 0.6, ancho_mm * 0.6) * mm])
        t.setStyle(TableStyle([("BACKGROUND", (0, 0), (-1, -1), colors.HexColor("#d9dce1")),
                               ("BOX", (0, 0), (-1, -1), 0.5, REJILLA), ("VALIGN", (0, 0), (-1, -1), "MIDDLE")]))
        return t
    i = Image(ruta)
    escala = ancho_mm * mm / i.imageWidth
    if alto_max_mm and i.imageHeight * escala > alto_max_mm * mm:
        escala = alto_max_mm * mm / i.imageHeight
    i.drawWidth, i.drawHeight = i.imageWidth * escala, i.imageHeight * escala
    return i


def lado_a_lado(izq, der, a_izq=96, a_der=80):
    """Texto a la izquierda, imagen a la derecha (como en el manual de la prensa)."""
    t = Table([[izq, der]], colWidths=[a_izq * mm, a_der * mm])
    t.setStyle(TableStyle([("VALIGN", (0, 0), (-1, -1), "TOP"), ("LEFTPADDING", (0, 0), (-1, -1), 0),
                           ("RIGHTPADDING", (0, 0), (0, 0), 8), ("RIGHTPADDING", (1, 0), (1, 0), 0),
                           ("TOPPADDING", (0, 0), (-1, -1), 0), ("BOTTOMPADDING", (0, 0), (-1, -1), 0)]))
    return t


def raya():
    t = Table([[""]], colWidths=[ANCHO], rowHeights=[2])
    t.setStyle(TableStyle([("LINEBELOW", (0, 0), (-1, -1), 0.5, colors.HexColor("#d5d9de"))]))
    return t


def bloque(izq, imagen, a_img, alto_img):
    """Texto completo y debajo la imagen con sus etiquetas, centrada."""
    if not imagen:
        return [*izq, Spacer(1, 4), raya(), Spacer(1, 2)]
    i = img(imagen, a_img, alto_img)
    t = Table([[i]], colWidths=[ANCHO], style=[("ALIGN", (0, 0), (-1, -1), "CENTER")])
    return [KeepTogether([*izq, Spacer(1, 3), t]), Spacer(1, 4), raya(), Spacer(1, 2)]


def paso(titulo, piezas, items, nota_ver, imagen, herramienta=None, a_img=165, alto_img=100, extra=None):
    izq = [Paragraph(titulo, S["h2"])]
    linea = f"<b>Piezas:</b> {piezas}"
    if herramienta:
        linea += f" <b>Herramienta:</b> {herramienta}"
    izq.append(Paragraph(linea, S["pz"]))
    izq += lista(items, num=True)
    if extra:
        izq += extra
    if nota_ver:
        izq += [Spacer(1, 3), verifica(nota_ver)]
    return bloque(izq, imagen, a_img, alto_img)


def sub(titulo, items, nota_ver, imagen, a_img=165, alto_img=95, num=True, intro=None):
    izq = [Paragraph(titulo, S["h3"])]
    if intro:
        izq.append(p(intro))
    izq += lista(items, num=num)
    if nota_ver:
        izq += [Spacer(1, 3), verifica(nota_ver)]
    return bloque(izq, imagen, a_img, alto_img)


def marco(titulo):
    def dibujar(c, doc):
        c.saveState()
        an, al = doc.pagesize
        c.setStrokeColor(ORO)
        c.setLineWidth(1.2)
        c.line(20 * mm, al - 13 * mm, an - 20 * mm, al - 13 * mm)
        c.setFont(FUENTE, 8)
        c.setFillColor(AZUL_OSC)
        c.drawString(20 * mm, 10 * mm, f"{titulo} · Robot de laberinto")
        c.drawRightString(an - 20 * mm, 10 * mm, f"{doc.page}")
        c.restoreState()
    return dibujar


def construir(nombre, titulo, historia):
    doc = SimpleDocTemplate(os.path.join(AQUI, nombre), pagesize=letter, leftMargin=20 * mm, rightMargin=20 * mm,
                            topMargin=20 * mm, bottomMargin=18 * mm, title=titulo, author="Equipo robot laberinto")
    doc.build(historia, onFirstPage=marco(titulo), onLaterPages=marco(titulo))
    print("Generado", nombre)


# ---------- Datos ----------
# "solo Q" = pieza que solo lleva la versión con UNO Q. El resto es común a las dos versiones.
BOM_IMP = [
    # pieza, material, proceso, cant
    ["Piso 1 (base, columnas, postes del L298N, soportes de VL53L0X y topes)", "PETG o PLA", "Impresión 3D", "1"],
    ["Piso 2 (marco del OLED, alojamiento de la placa, botón, interruptor, agujero M5 del pedestal)", "PETG o PLA", "Impresión 3D", "1"],
    ["Cuna de motor", "PETG o PLA", "Impresión 3D", "2"],
    ["Capucha del sensor de color con patín delantero", "PLA negro", "Impresión 3D", "1"],
    ["Patín trasero", "PETG o PLA", "Impresión 3D", "1"],
    ["Soporte de VL53L0X (se cambia solo si se rompe)", "PLA negro", "Impresión 3D", "3"],
    ["Pieza de prueba de tolerancias", "El mismo de las demás", "Impresión 3D (primero)", "1"],
    ["Repisa del hub USB (solo Q)", "PETG o PLA", "Impresión 3D", "1"],
    ["Cabeza de cámara con rieles del OLED (solo Q)", "PETG o PLA", "Impresión 3D", "1"],
    ["Pedestal 20 × 20 × 75 mm (solo Q)", "PETG o PLA", "Impresión 3D", "1"],
]
BOM_ELEC = [
    ["Arduino UNO R3 (ATmega328P)", "Placa oficial y de respaldo; cable USB-B de datos", "1"],
    ["Arduino UNO Q (solo Q)", "Placa principal; cable USB-C de datos", "1"],
    ["Proto Shield comercial", "Con mini protoboard de 170 puntos; va sobre la placa", "1"],
    ["Motorreductor N20", "6 V, 300–500 RPM, sin encoder", "2"],
    ["Rueda para N20", "Ø45 × 17 mm, eje D de 3 mm", "2"],
    ["Puente H L298N", "Módulo rojo 43 × 43 mm con disipador", "1"],
    ["Sensor de color TCS34725", "Módulo morado 20.5 × 20.5 mm", "1"],
    ["Sensor de distancia VL53L0X", "CJVL53L0XV2, 25 × 10.7 mm", "3"],
    ["Pantalla OLED SSD1306", "0.96\", I2C, dirección 0x3C, 4 pines", "1"],
    ["MPU-6050 (módulo GY-521)", "Giroscopio y acelerómetro I2C, dirección 0x68 (AD0 a GND), VCC 3.3 V; plano y atornillado al piso", "1"],
    ["Botón de panel", "Ø7 mm, normalmente abierto", "1"],
    ["Interruptor de palanca", "MTS-102, Ø6 mm", "1"],
    ["Batería 2S 18650", "7.4 V, 3000 mAh, conector T y balanceo JST-XH", "1"],
    ["Conector T (Deans) hembra", "Con 10 cm de cable calibre 14–16", "1"],
    ["Cargador balanceador 2S", "Entrada JST-XH de 3 pines", "1"],
    ["Fusible de 3 A con portafusible", "En el positivo, después del interruptor", "1"],
    ["Capacitor cerámico", "100 nF (104)", "2"],
    ["Header macho recto", "2.54 mm, tira de 40 (los rectos de siempre)", "1"],
    ["Cámara USB innomaker U20CAM-9281M (solo Q)", "OV9281 monocromática 1 MP, obturador global, UVC, lente M12 gran angular", "1"],
    ["Cable USB-C corto en ángulo recto (solo Q)", "Del hub a la entrada USB-C de la UNO Q", "1"],
    ["Hub USB-C con entrada PD (solo Q)", "USB-C macho, 1 USB-A de datos y entrada de alimentación", "1"],
    ["Inserto de calor M4 + tornillo M4 × 12 (solo Q)", "Pedestal al piso 2, desde abajo", "1"],
    ["Módulo fuente USB-C PD, opcional (solo Q)", "Entrada desde 6 V, salida 5 V / 3 A; solo si falla la prueba sin PD (sección 6.4)", "1"],
]
BOM_CABLES = [
    ["Dupont hembra-macho 30 cm", "VL53L0X (3 × 5), OLED (4), L298N lógica (6) + 2 de repuesto", "27"],
    ["Dupont macho-macho 30 cm", "Se les corta un extremo: TCS34725 (4) y botón (2)", "6"],
    ["Cable calibre 22 de silicón, rojo, negro, amarillo, blanco y naranja", "Motores, interruptor, batería y placa", "1 m en total por color"],
    ["Jumpers rígidos", "Puentes del bus en la protoboard del shield y del bus a la placa", "8"],
    ["Cinchos chicos y termofit de 3 mm", "Ordenar cables y aislar soldaduras (la Q usa 2 más para el hub)", "12 / 30 cm"],
    ["Cinta aislante", "Sobre el USB-B del R3, bajo el shield", "1"],
]
BOM_TORN = [
    ["Inserto de calor M3 (latón)", "26 (+4 solo Q)", "Comunes: columnas (4) y postes del L298N (4) del piso 1, cunas (4), capucha (2), patín (2), soportes de VL53L0X (6), placa en el piso 2 (4). Solo Q: repisa (4)"],
    ["Tornillo Allen M3 × 8", "28 (+4 solo Q)", "Comunes: L298N (4), piso 2 (4), placa (4), capucha (2), patín (2), soportes de VL53L0X (6), VL53L0X (6). Solo Q: repisa (4)"],
    ["Tornillo Allen M3 × 12", "4", "Cunas de motor"],
    ["Tornillo M2 + tuerca y rondana", "4 (solo Q)", "Cámara en su cabeza (tuerca atrás)"],
    ["Tornillo M3 opresor", "1 (solo Q)", "Cabeza contra el pedestal"],
    ["Velcro adhesivo 3 × 5 cm", "1", "Bajo la batería"],
    ["Nota", "—", "Del kit M2–M5 solo se usan Allen M3 de 8 y 12 mm (y M2 para la cámara); sin tuercas, rondanas ni separadores"],
]
HERRAMIENTAS = [
    ["Imprimir", "Bambu Lab A2L o X2D, boquilla de 0.4 mm, PETG o PLA, Bambu Studio"],
    ["Soldar", "Cautín de 30–60 W con punta fina, soldadura 60/40 de 0.8 mm, termofit, encendedor o pistola de calor"],
    ["Cables", "Pinzas de corte, pelacables calibre 22, pinzas de punta"],
    ["Insertos", "El mismo cautín con punta cónica o punta para insertos M3"],
    ["Armado", "Llave Allen de 2.5 mm (M3), desarmador plano de 2.5 mm (bornes del L298N), desarmador Phillips chico (M2)"],
    ["Medir", "Multímetro, vernier"],
    ["Programar", "R3: Microchip Studio 7 y avrdude. Q: Arduino App Lab (manual de uso y docs/GUIA_PROGRAMACION.md)"],
]

TIPO = [  # prefijo del nombre del cable -> tipo
    ("Motor", "Calibre 22 soldado al motor"),
    ("Conector T", "Calibre 22 (viene con el conector T)"),
    ("Interruptor", "Calibre 22 soldado al interruptor"),
    ("L298N GND", "Calibre 22"),
    ("L298N", "Dupont hembra-macho 30 cm"),
    ("VL53L0X", "Dupont hembra-macho 30 cm"),
    ("OLED", "Dupont hembra-macho 30 cm"),
    ("TCS34725", "Dupont macho-macho 30 cm sin un extremo, soldado"),
    ("Boton", "Dupont macho-macho 30 cm sin un extremo, soldado"),
    ("Puente", "Jumper rígido"),
]
COLOR_ES = {"red": "rojo", "black": "negro", "orange": "naranja", "yellow": "amarillo", "white": "blanco",
            "cyan": "cian", "royalblue": "azul", "green": "verde", "hotpink": "rosa", "mediumpurple": "morado",
            "sienna": "café", "dimgray": "gris"}
SOLO_Q = re.compile(r"USB|C[aá]mara|Hub")


def _eco(placa):
    """Corre openscad con la placa dada y devuelve [(nombre, color, mm)] de los CABLE| del echo."""
    with tempfile.TemporaryDirectory() as tmp:
        eco = os.path.join(tmp, "e.echo")
        subprocess.run(["openscad", "-D", f'PLACA="{placa}"', "-o", eco, SCAD], check=True,
                       stdout=subprocess.DEVNULL, stderr=subprocess.DEVNULL)
        crudos = [re.match(r'ECHO: "CABLE\|(.*)\|(.*)\|(\d+)"', l) for l in open(eco)]
    return [(m[1], m[2], int(m[3])) for m in crudos if m]


def _unir(crudos):
    """Une cada tramo '(abajo)' con su cable completo, si existe."""
    completos = {n: [n, c, mm_] for n, c, mm_ in crudos if not n.endswith(" (abajo)")}
    for n, c, mm_ in crudos:
        if n.endswith(" (abajo)"):
            b = n[:-len(" (abajo)")]
            dest = completos.get(b) or next((v for k, v in completos.items() if k.startswith(b + " -> ")), None)
            if dest:
                dest[2] += mm_
            else:
                completos[b] = [b, c, mm_]
    return list(completos.values())


# Puentes del shield (el modelo no los dibuja): de, a, color, largo aprox. (mm)
PUENTES_SHIELD = [
    ["Puente bus VCC", "otra mitad de su columna", "rojo", 12], ["Puente bus GND", "otra mitad de su columna", "negro", 12],
    ["Puente bus SDA", "otra mitad de su columna", "azul", 12], ["Puente bus SCL", "otra mitad de su columna", "cian", 12],
    ["Puente VCC del bus", "5V (R3) o 3V3 (Q)", "rojo", 20], ["Puente GND del bus", "GND del shield", "negro", 20],
    ["Puente SDA del bus", "SDA (junto a AREF)", "azul", 20], ["Puente SCL del bus", "SCL (junto a AREF)", "cian", 20],
]


def _destino(n):
    """Nombre sin tramo '(abajo)' ni ' -> ', y su destino genérico."""
    de, a = n.split(" -> ") if " -> " in n else (n, "")
    if not a:
        if de.startswith("L298N"):
            a = "placa " + de.split()[-1]
        elif de.startswith("Boton"):
            a = "placa " + de.split()[-1]
        else:
            a = "bus " + ("VCC" if de.split()[-1] in ("VIN", "VCC") else de.split()[-1])
    return de, a


def leer_cables():
    """Lista de cables desde chasis.scad (echo de cable()); se guarda en cables.csv.

    Se corre con PLACA="unoq" (incluye los USB). El modelo de la UNO Q no dibuja los tramos finales hacia el
    shield, así que los cables comunes se completan con la corrida del modelo base (mismo chasis)."""
    csv_ruta = os.path.join(AQUI, "cables.csv")
    if shutil.which("openscad"):
        q = _unir(_eco("unoq"))
        base = _unir(_eco("nano"))
        todos = [c for c in base if not c[0].startswith("Puente")] + [c for c in q if SOLO_Q.search(c[0])]
        filas, vistos = [], set()
        for n, c, mm_ in todos:
            if n in vistos:
                continue
            vistos.add(n)
            de, a = _destino(n)
            a = a.replace("Nano", "placa").replace("bus 5V", "bus VCC")
            de = de.replace("Nano", "placa")
            tipo = "Cable USB (solo Q)" if SOLO_Q.search(n) else next(t for pre, t in TIPO if n.startswith(pre))
            filas.append([de.replace("Boton", "Botón").replace("Camara", "Cámara"), a,COLOR_ES.get(c, c), tipo, mm_])
        filas += [[d, a, c, "Jumper rígido", l] for d, a, c, l in PUENTES_SHIELD]
        orden = ["Motor", "Conector", "Interruptor", "L298N GND", "L298N", "VL53L0X izq", "VL53L0X frente",
                 "VL53L0X der", "TCS", "OLED", "Botón", "Puente", "Hub", "Cámara", "Camara"]
        filas.sort(key=lambda f: next((i for i, o in enumerate(orden) if f[0].startswith(o)), 99))
        with open(csv_ruta, "w", newline="", encoding="utf-8") as f:
            w = csv.writer(f)
            w.writerow(["De", "A", "Color", "Tipo", "Largo en el modelo (mm)"])
            w.writerows(filas)
        print("Generado cables.csv")
    with open(csv_ruta, encoding="utf-8") as f:
        return [r[:4] + [int(r[4])] for r in list(csv.reader(f))[1:]]


def escribir_csv():
    with open(os.path.join(AQUI, "bom.csv"), "w", newline="", encoding="utf-8") as f:
        w = csv.writer(f)
        w.writerow(["Categoria", "Componente", "Especificacion / donde va", "Cantidad"])
        for r in BOM_IMP:
            w.writerow(["Impresa 3D", r[0], r[1], r[3]])
        for r in BOM_ELEC:
            w.writerow(["Electronica", r[0], r[1], r[2]])
        for r in BOM_CABLES:
            w.writerow(["Cables", r[0], r[1], r[2]])
        for r in BOM_TORN[:-1]:
            w.writerow(["Tornilleria", r[0], r[2], r[1]])
    print("Generado bom.csv")


# ---------- Manual de armado ----------
MAPA_PINES = [["Señal", "Pin (R3 y Q)"],
              ["ENA / ENB del L298N", "D5 / D6"],
              ["IN1, IN2, IN3, IN4", "D7, D8, D9, D10"],
              ["Botón (el otro lado a GND)", "D2"],
              ["XSHUT VL53L0X izquierdo / frente / derecho", "A0 / A1 / A2"],
              ["SDA / SCL (bus I2C)", "Pines SDA y SCL de la cabecera junto a AREF"],
              ["Interruptor", "VIN"],
              ["GND del L298N", "GND"]]


def manual_ensamble():
    cables = leer_cables()
    H = []

    # Portada
    H += [Spacer(1, 22 * mm), Paragraph("Manual de armado", S["t"]),
          Paragraph("Robot de laberinto — chasis impreso de 120 × 120 mm en dos pisos, modular: Arduino UNO R3 "
                    "(ATmega328P, respaldo oficial) o Arduino UNO Q (principal, con cámara USB)", S["st"]),
          Spacer(1, 8 * mm),
          Table([[img("r3_iso.png", 80, 70), img("q_iso.png", 80, 70)]], colWidths=[88 * mm, 88 * mm],
                style=[("VALIGN", (0, 0), (-1, -1), "MIDDLE"), ("ALIGN", (0, 0), (-1, -1), "CENTER")]),
          Paragraph("Izquierda: versión UNO R3. Derecha: versión UNO Q.", S["fig"]), Spacer(1, 8 * mm),
          p("<b>Equipo:</b> ______________________________________________________________"),
          Paragraph("Microcontroladores 2 · Archivos de referencia: <i>chasis/chasis.scad</i>, <i>chasis/stl/</i>, "
                    "<i>docs/bom.csv</i>, <i>docs/cables.csv</i>, <i>docs/GUIA_PROGRAMACION.md</i> y <i>docs/uno_q.md</i>",
                    S["pz"]),
          PageBreak()]

    # 1. Como funciona
    H += [h1("1. Cómo funciona"),
          p("Tres VL53L0X miden las paredes a la izquierda, al frente y a la derecha. La placa guarda el mapa del "
            "laberinto y elige el camino con flood-fill. Las dos ruedas con motor N20 las mueve el puente H L298N. "
            "Un TCS34725 mira el piso por una capucha y cuenta las marcas de color, que se ven en la OLED. Todos los "
            "sensores y la OLED comparten un bus I2C armado en la protoboard de un Proto Shield. Abajo van motores, "
            "batería y L298N; arriba, la placa."),
          p("<b>El chasis y las piezas impresas son las mismas</b> con las dos placas. La <b>UNO R3</b> es la oficial y la "
            "de respaldo. La <b>UNO Q</b> es la principal y solo <b>agrega</b>: pedestal impreso, cabeza con cámara USB "
            "y OLED, repisa con hub USB y los cables USB. Se cambia de una a otra sin tocar "
            "el cableado (sección 5, «Cambio R3 ↔ UNO Q»)."),
          Table([[img("r3_iso.png", 40, 52), img("r3_atras.png", 40, 52), img("q_iso.png", 40, 52), img("q_lado.png", 40, 52)]],
                colWidths=[44 * mm] * 4,
                style=[("VALIGN", (0, 0), (-1, -1), "MIDDLE"), ("ALIGN", (0, 0), (-1, -1), "CENTER")]),
          fig("Fig. 1. R3: isométrico y atrás. UNO Q: isométrico y lado."),
          tabla([["Dato", "Valor"],
                 ["Huella", "120 × 120 mm con ruedas (esquinas de R30 para girar en pasillos de 180 mm), igual en las dos"],
                 ["Pisos", "Piso 1 a 22 mm del suelo; piso 2 sobre 4 columnas impresas de 35 mm; la placa va sobre el piso 2"],
                 ["Alimentación", "Batería 2S 18650 (7.4 V) → interruptor → L298N (12V) y VIN de la placa"],
                 ["Bus I2C", "VL53L0X × 3 (direcciones 0x30–0x32), TCS34725 (0x29), OLED (0x3C), 400 kHz"],
                 ["VCC del bus", "5V con el R3; <b>3V3 con la UNO Q</b>"],
                 ["Piezas impresas", "6 comunes + 3 solo Q (repisa, cabeza de cámara con OLED, pedestal)"]], [45, 131]),
          Spacer(1, 4),
          h2("Mapa de pines (igual en las dos placas)"),
          tabla(MAPA_PINES, [88, 88]),
          h1("2. Herramientas"),
          tabla([["Para", "Herramienta"], *HERRAMIENTAS], [30, 146]),
          PageBreak()]

    # 3. Lista de piezas
    H += [h1("3. Lista de piezas"), p("Lo marcado «solo Q» se agrega únicamente a la versión con UNO Q; lo demás es común."),
          h2("Piezas a fabricar"),
          tabla([["Pieza", "Material", "Proceso", "Cant."], *BOM_IMP], [85, 35, 42, 14]),
          h2("Componentes comerciales"),
          tabla([["Componente", "Especificación", "Cant."], *BOM_ELEC], [58, 104, 14]),
          h2("Cables"),
          tabla([["Cable", "Para qué", "Cant."], *BOM_CABLES], [70, 80, 26]),
          p("La lista completa, cable por cable, con su color y su largo, está en el <b>Anexo A</b>."),
          h2("Tornillería"),
          tabla([["Elemento", "Cant.", "Dónde va"], *BOM_TORN], [50, 24, 102]),
          PageBreak()]

    # 4. Preparacion de piezas
    H += [h1("4. Preparación de piezas"), h2("4.1 Impresión 3D"),
          p("Las holguras del modelo están ajustadas para la <b>Bambu Lab A2L</b> (cama móvil, boquilla de 0.4 mm): "
            "ahí los agujeros salen unos 0.1 mm chicos y las ranuras unos 0.15 mm angostas. Todas las piezas comunes caben "
            "en una sola placa de <b>256 × 256 mm</b>, la cama de la <b>X2D</b>: archivo "
            "<i>chasis/stl/placa_x2d.stl</i> (en Bambu Studio: clic derecho → <i>Dividir en objetos</i>). Las piezas "
            "solo Q (repisa, cabeza de cámara y pedestal) se imprimen aparte."),
          lado_a_lado([
              tabla([["Ajuste", "Valor"],
                     ["Boquilla / capa", "0.4 mm / 0.2 mm"],
                     ["Paredes / capas sup. e inf.", "4 / 4"],
                     ["Relleno", "25 % giroide"],
                     ["Soportes", "No"],
                     ["Pata de elefante", "0.15 mm"],
                     ["Compensación X-Y de agujeros", "0 (ya está en el modelo)"],
                     ["Costura", "Atrás, alineada"],
                     ["Placa", "Textured PEI"]], [42, 50])],
              [img("placa_x2d.png", 76, 76), fig("Fig. 2. Placa completa en la cama de 256 × 256 de la X2D.")], 96, 80),
          Spacer(1, 4),
          tabla([["Pieza", "Orientación en la cama", "Ajustes sugeridos", "Soportes"],
                 ["Piso 1", "Plano, columnas hacia arriba", "PETG, 4 paredes, 25 %", "No"],
                 ["Piso 2", "Plano, marcos hacia arriba", "PETG, 4 paredes, 25 %", "No"],
                 ["Cuna de motor (2)", "Base abajo, hueco del motor arriba", "PETG, 4 paredes, 40 %", "No"],
                 ["Capucha de color", "Orejas sobre la cama, patín arriba", "PLA negro, 4 paredes, 30 %", "No"],
                 ["Patín trasero", "Barra sobre la cama, domo arriba", "PETG, 4 paredes, 40 %", "No"],
                 ["Soporte de VL53L0X (×3)", "Base sobre la cama", "PLA, 4 paredes, 40 %", "No"],
                 ["Repisa, cabeza de cámara, pedestal (solo Q)", "Cara plana sobre la cama (pedestal de pie)", "PETG, 4 paredes, 40 %", "No"]],
                [44, 56, 50, 26]),
          *lista([
              "Imprime primero la <b>pieza de prueba</b> (<i>chasis/stl/prueba.stl</i>), sola, con los mismos ajustes.",
              "Agujeros de arriba: M3 de 3.2, 3.4 y 3.6. El tornillo debe pasar libre en el de 3.4.",
              "Bloque de insertos: agujeros de 3.8, 4.0 y 4.2. Usa el que deja el inserto firme y a ras; si no es "
              "el de 4.0, cambia INSERTO en chasis.scad y exporta otra vez.",
              "Agujeros grandes: botón (7.3) e interruptor (6.3). Bloque: el N20 entra empujando con el dedo.",
              "Soporte de VL53L0X: el sensor, ya con sus dupont, baja sin forzar y no baila. Si entra apretado, sube "
              "RANURA a 2.1 en chasis.scad; si baila, bájala a 1.9.",
              "Si cambias algo, exporta otra vez: <font face='Courier' size='8'>openscad -D 'PIEZA=\"placa\"' "
              "-o placa_x2d.stl chasis/chasis.scad</font>.",
          ]),
          CondPageBreak(60 * mm),
          h2("4.2 Insertos de calor"),
          p("Todos los tornillos roscan en insertos de latón M3: se ponen antes de armar, con las piezas frías."),
          *lista([
              "Cautín a 220 °C para PLA o 245 °C para PETG, con punta cónica.",
              "Pon el inserto derecho en la boca del agujero, lado angosto abajo.",
              "Empuja sin forzar: entra solo con el calor en 5–10 s. Para cuando quede a ras.",
              "Antes de que enfríe, aplánalo con algo metálico frío para dejarlo parejo.",
              "Piso 1: arriba de las 4 columnas y de los 4 postes del L298N. Cunas: en la cara de las orejas. "
              "Capucha, patín y soportes de VL53L0X: en la cara que va contra el piso 1.",
              "Piso 2: 4 insertos para la placa. <b>Solo Q:</b> otros 4 en los postes de la repisa.",
          ], num=True),
          img("det_insertos.png", 165, 85),
          fig("Fig. 3. Insertos (dorados): 26 comunes, más 4 de la repisa solo con la UNO Q."),
          CondPageBreak(60 * mm),
          h2("4.3 Soldadura"),
          *lista([
              "<b>Motores:</b> suelda un capacitor de 100 nF entre las dos terminales de cada N20. Luego un cable "
              "amarillo (+) y uno blanco (−) de 10 cm a cada motor. Termofit en cada terminal.",
              "<b>VL53L0X (3):</b> header recto de 6 pines con el <b>plástico del lado sin chip</b>; las puntas cortas se "
              "sueldan del lado del chip. Recorta lo que sobresalga más de 1.5 mm.",
              "<b>TCS34725:</b> a 4 dupont macho-macho de 30 cm córtales un extremo. Suelda las puntas cortadas a VIN (rojo), GND "
              "(negro), SCL (cian) y SDA (azul), saliendo hacia el borde de los pines. No lleva header.",
              "<b>Botón:</b> igual, un dupont rosa y uno negro sin un extremo, uno en cada pata.",
              "<b>Interruptor (arnés de potencia):</b> rojo del conector T hembra a una pata exterior; a la pata "
              "central, dos cables naranjas de 10 cm (uno al L298N y otro a la placa). Termofit en las tres patas.",
              "<b>Fusible:</b> con la UNO Q, pon el portafusible de 3 A en el rojo, entre el conector T y el interruptor.",
              "<b>Conector T hembra:</b> su cable negro va directo al L298N; el rojo es el que se soldó al interruptor.",
          ]),
          h2("4.4 Preparar cables y shield"),
          *lista([
              "Pela 6 mm de cada cable calibre 22 que va a un borne y estáñalo.",
              "El naranja de VIN y el negro de GND que van a la placa: pela 8 mm y estáñalos para que entren rectos en el header del shield.",
              "Pega la mini protoboard sobre el Proto Shield y marca cuatro columnas con cinta: <b>VCC, GND, SDA, SCL</b>. "
              "Cada columna tiene dos mitades de 5 hoyos; únelas con un jumper rígido.",
              "Respeta los colores de la tabla: así revisar el cableado al final es comparar colores.",
          ]),
          tabla([["Columna del bus", "Color", "Va a (por jumper rígido)"],
                 ["VCC", "rojo", "<b>5V con el R3. 3V3 con la UNO Q.</b>"],
                 ["GND", "negro", "GND del shield"],
                 ["SDA", "azul", "Pin SDA de la cabecera junto a AREF"],
                 ["SCL", "cian", "Pin SCL de la cabecera junto a AREF"]], [40, 30, 106]),
          Spacer(1, 3),
          caja("<b>Cuidado:</b> con la UNO Q el VCC del bus va a <b>3V3</b>. Con 5V en el bus se pueden dañar los pines "
               "SDA/SCL de la Q, porque algunos módulos suben esas líneas al VCC del bus."),
          img("det_shield.png", 150, 90),
          fig("Fig. 4. Proto Shield con la mini protoboard: columnas del bus y puentes a la placa."),
          PageBreak()]

    # 5. Armado paso a paso
    H += [h1("5. Armado paso a paso"),
          Paragraph("Los pasos 1 a 6 y 8 a 10 son iguales con las dos placas. El paso 7 cambia un poco (OLED) y el paso 11 "
                    "es <b>solo para la UNO Q</b>. En cada imagen, las piezas en color son las que se agregan en ese "
                    "paso; lo ya armado aparece en gris.", S["pz"]), Spacer(1, 2)]
    H += paso("Paso 1. Motores y cunas",
              "piso 1, 2 cunas de motor con insertos, 2 motores N20 con capacitor y cables, 4 Allen M3×12",
              ["Voltea el piso 1. Mete cada N20 en su cuna con el eje hacia afuera y las terminales hacia el centro.",
               "Presenta la cuna bajo el piso 1 y atornilla 2 M3×12 desde arriba, uno atrás y otro adelante de la batería.",
               "Pasa los dos cables de cada motor por la ranura de 10 × 10 de su lado, junto a donde irá el L298N.",
               "Aprieta hasta que el motor no gire dentro de la cuna."],
              "ninguna cabeza queda en el hueco de la batería y los cables no tocan el suelo.",
              "paso1.png")
    H += paso("Paso 2. Ruedas, capucha de color y patín",
              "2 ruedas, capucha de color y patín trasero con insertos, TCS34725 con sus 4 cables, 4 Allen M3×8",
              ["Presiona cada rueda en su eje; debe quedar a 1–2 mm del hueco del piso.",
               "Atornilla la capucha con 2 M3×8 desde arriba y el patín con otros 2 (a los lados del L298N).",
               "Desliza el TCS34725 en la capucha por la abertura de atrás, LED hacia el suelo, hasta que tope.",
               "Sube sus 4 cables por dentro de la capucha y sácalos por la ranura de 14 × 6 del piso 1."],
              "en el suelo, el robot se apoya en las ruedas y los patines quedan a 0.5 mm.",
              "paso2.png")
    H += sub("3.1 Reconoce el L298N",
             ["<b>OUT1-OUT2</b> (izquierda) y <b>OUT3-OUT4</b> (derecha): motores.",
              "Borne de potencia al frente: <b>12V</b>, <b>GND</b> y 5V (el 5V no se usa).",
              "Header de lógica: <b>ENA IN1 IN2 IN3 IN4 ENB</b>. Quita los jumpers de ENA y ENB; deja el de 5V-EN.",
              "El disipador va hacia atrás del robot; el header y los bornes de potencia, hacia la batería."],
             None, "det_l298.png", intro="Antes de montarlo, ubica sus conexiones (vista desde arriba, frente del robot arriba).",
             num=False)
    H += paso("Paso 3. Puente H L298N y cables de motores",
              "L298N, 4 Allen M3×8",
              ["Pon el L298N sobre los 4 postes de atrás del piso 1, disipador hacia atrás.",
               "Atornilla 4 M3×8 desde arriba a los insertos de los postes.",
               "Motor izquierdo: amarillo a OUT1 y blanco a OUT2. Motor derecho: amarillo a OUT3 y blanco a OUT4.",
               "Aprieta los bornes con el desarmador plano y jala cada cable suave: no debe salir."],
              "ningún cable de motor queda colgando bajo el piso 1 ni cerca de las ruedas.",
              "paso3.png")
    H += paso("Paso 4. Batería",
              "batería 2S con su conector T macho, velcro",
              ["Pega el velcro en el piso 1, entre los topes.",
               "Acuesta la batería a lo ancho, sobre el eje, con sus cables hacia la izquierda.",
               "Deja el conector T macho acostado sobre la batería, apuntando a la derecha. <b>No lo conectes todavía.</b>",
               "El cable de balanceo (blanco) queda encima, a la izquierda; solo se usa para cargar."],
              "entre la batería y el borde del L298N quedan ~4.5 mm libres para doblar los cables de potencia.",
              "paso4.png")
    H += paso("Paso 5. Sensores de distancia VL53L0X",
              "3 soportes de VL53L0X con insertos, 3 VL53L0X con header, 15 dupont hembra-macho, 12 Allen M3×8",
              ["Atornilla cada soporte al piso 1 con 2 M3×8 desde abajo. Si uno se rompe, se cambia solo ese soporte.",
               "Conecta 5 dupont a cada sensor <b>antes</b> de meterlo: VIN rojo, GND negro, SCL cian, SDA azul y "
               "XSHUT verde. GPIO1 queda libre.",
               "Baja cada sensor por las ranuras de su soporte: chip hacia afuera, pines arriba apuntando hacia adentro.",
               "Fija cada sensor con 2 M3×8 desde el frente, uno por oreja: pasan libres el poste de enfrente y la oreja, y "
               "roscan en el plástico del poste de atrás. Aprieta sin forzar.",
               "Dobla los cables hacia arriba justo al final del dupont.",
               "Los laterales suben derecho. El del frente va hacia la ranura derecha."],
              "cada sensor tocó el fondo de su soporte y detrás de él quedan ~27 mm libres.",
              "paso5.png")
    H += paso("Paso 6. Cables de lógica del L298N",
              "6 dupont hembra-macho",
              ["Conecta un dupont a cada pin del header del L298N: ENA y ENB morados, IN1 a IN4 cafés.",
               "Sube los 6 cables juntos, por encima de la batería, hacia el centro del robot."],
              "los dupont están en la fila de adelante del header, no en la de 5V.",
              "paso6.png")
    H += paso("Paso 7. Piso 2 en la mesa",
              "piso 2, UNO R3 <i>o</i> UNO Q, Proto Shield con su protoboard, 4 Allen M3×8, botón, interruptor con su arnés; "
              "con el R3, también el OLED con 4 dupont",
              ["Atornilla la placa (UNO R3 o UNO Q) al piso 2 con 4 M3×8 en sus insertos. Con el R3, USB-B hacia atrás "
               "y una vuelta de cinta aislante sobre el USB-B, porque el shield queda encima.",
               "Clava el Proto Shield sobre los headers de la placa.",
               "Haz los 4 puentes del bus en la protoboard del shield (sección 4.4): VCC, GND, SDA y SCL. "
               "<b>VCC del bus: 5V con el R3, 3V3 con la UNO Q.</b>",
               "<b>Solo R3:</b> acuesta el OLED en su marco del piso 2, pines hacia atrás, y conecta sus 4 dupont "
               "(7.1). Con la UNO Q <b>no</b> va en el marco: va en la cabeza de la cámara (paso 11).",
               "Mete el botón y el interruptor en sus agujeros y apriétalos con su tuerca."],
              "con el multímetro, cada columna del bus tiene continuidad de punta a punta y no con las demás; el VCC "
              "del bus no está en 5V si la placa es la Q.",
              "r3_paso7.png", a_img=165)
    H += sub("7.1 Pines del OLED (solo R3)",
             ["El plástico del header queda dentro de la ranura del piso 2.",
              "Los 4 pines salen hacia abajo; ahí se conectan los dupont: GND negro, VCC rojo, SCL cian y SDA azul.",
              "Los cables van a la ranura derecha y suben al bus."],
             None, "detalle_oled.png", alto_img=70)
    H += sub("8.1 Arnés de potencia",
             ["Acerca el piso 2 por atrás, inclinado, con el arnés colgando.",
              "Naranja corto del interruptor al <b>12V</b> del L298N.",
              "Negro del conector T y negro largo (a la placa) juntos, torcidos, al <b>GND</b> del L298N.",
              "Dobla los cables hacia arriba entre la batería y el L298N.",
              "El otro naranja y el negro largo suben por la ranura central del piso 2."],
             "jala cada cable del borne: ninguno sale. El conector T hembra sigue <b>sin conectar</b>.",
             "det_arnes.png", intro="Los bornes quedan bajo el piso 2: se aprietan antes de cerrarlo.")
    H += paso("Paso 8. Montar el piso 2 y el arnés de potencia",
              "conjunto del paso 7, 4 Allen M3×8",
              ["Haz el arnés de potencia (8.1) con el piso 2 todavía sin bajar.",
               "Baja el piso 2 sobre las 4 columnas pasando los cables: sensores izquierdos y TCS34725 por la ranura "
               "izquierda; VL53L0X derecho y frontal por la derecha; L298N, botón y potencia por la central.",
               "Revisa que ningún cable quede pellizcado entre columna y piso.",
               "Atornilla 4 M3×8 a los insertos de las columnas."],
              "el piso 2 asienta plano en las 4 columnas y los cables de abajo no tocan las ruedas.",
              "r3_paso8.png")
    H += paso("Paso 9. Conexiones en el shield",
              "los cables que salen por las ranuras",
              ["Cada sensor va a su columna del bus por color: rojo a VCC, negro a GND, azul a SDA y cian a SCL.",
               "XSHUT verdes en los headers del shield: izquierdo a A0, frente a A1 y derecho a A2.",
               "L298N: ENA→D5, ENB→D6, IN1→D7, IN2→D8, IN3→D9, IN4→D10.",
               "Botón: rosa a D2 y negro a GND del shield.",
               "Naranja del interruptor a VIN y negro del L298N a GND, en los headers de potencia del shield.",
               "Agrupa con cinchos los cables de cada sensor; usa el Anexo A como lista de revisión."],
              "compara cable por cable con el mapa de pines (sección 1) y el Anexo A antes de seguir.",
              "r3_paso9.png")
    H += paso("Paso 10. Conector T y primera conexión",
              "conector T",
              ["Haz todas las revisiones de la sección 6.1.",
               "Pon el interruptor en OFF y levanta el robot para que las ruedas giren en el aire.",
               "Une el conector T macho de la batería con la hembra del robot y acuéstalo sobre la batería.",
               "Con el R3, enciende: la OLED debe decir LABERINTO LISTO. Con la Q, termina el paso 11 antes de encender."],
              "nada se calienta en el primer minuto. Si algo huele o se calienta, apaga y desconecta el T.",
              "r3_paso10.png")
    H += [h2("Paso 11. Solo UNO Q: pedestal, cámara, hub y OLED")]
    H += sub("11.1 Pedestal y cabeza de cámara",
             ["Mete con el cautín el inserto M4 en la base del pedestal. Atorníllalo al piso 2 con un M4 × 12 desde abajo "
              "(agujero central de 5.5 mm).",
              "Pon la cámara en el marco de la cabeza, lente al frente, con el conector por el hueco de arriba a la izquierda "
              "(visto por atrás). 4 M2 con tuerca y rondana atrás; los agujeros dan ±1 mm de juego.",
              "Pasa los cables de alimentación de la cámara por la ranura de abajo al centro.",
              "Mete la cabeza en el pedestal hasta el fondo (entra 20 mm) y apriétala con el M3 opresor del lado."],
             None, "q_paso11.png", alto_img=95, intro="Parte solo de la versión con UNO Q.")
    H += sub("11.2 Repisa, hub y OLED",
             ["Atornilla la repisa a sus 4 postes del piso 2 con 4 M3×8.",
              "Pon el hub sobre la repisa y sujétalo con 2 cinchos por las ranuras.",
              "Desliza el OLED desde arriba en los rieles de atrás de la cabeza, header hacia arriba. Conecta sus 4 "
              "dupont al bus (el VCC del bus sigue en 3V3)."],
             None, "det_q_usb.png", alto_img=85)
    H += [fig("Fig. 5. Hub, repisa y cables USB de la UNO Q."),
          *lista(["<b>Cables USB:</b> el cable USB-C corto en ángulo recto va del hub a la entrada USB-C de la UNO Q. "
                  "El cable de la cámara va al hub.",
                  "La placa se alimenta por VIN con la batería. Alimenta el hub por su puerto PD: con VIN, el USB-C de la Q no le da 5 V. "
                  "Conecta cámara y hub antes de darle Run."], num=True),
          verifica("el VCC del bus está en 3V3, el hub no se mueve al tocarlo y los cables USB no rozan las ruedas ni el pedestal."),
          Spacer(1, 4), raya(), Spacer(1, 2)]
    H += [h2("Cambio R3 ↔ UNO Q"),
          p("El cableado vive en el shield: se cambia de placa sin tocar los dupont."),
          *lista([
              "Desconecta el conector T de la batería.",
              "Quita el <b>Proto Shield completo</b> con todos sus dupont conectados, jalándolo parejo hacia arriba.",
              "Quita los 4 M3×8 de la placa, cambia R3 por Q (o al revés) y vuelve a poner los 4 tornillos.",
              "Pon el shield otra vez sobre los headers.",
              "<b>Mueve el jumper VCC del bus:</b> 5V para el R3, 3V3 para la Q.",
              "Pasa de R3 a Q: agrega pedestal, cabeza con cámara, repisa con hub, el OLED en los rieles de la cabeza y los "
              "cables USB (paso 11). Quita el OLED del marco.",
              "Pasa de Q a R3: quita esas piezas y pon el OLED en su marco (7.1); con el R3, cinta aislante sobre el USB-B.",
          ], num=True),
          caja("<b>Revisa antes de conectar la batería:</b> con la UNO Q el VCC del bus <b>nunca</b> va a 5V."),
          PageBreak()]

    # 6. Ajustes y pruebas
    H += [h1("6. Ajustes y pruebas"), h2("6.1 Antes de conectar la batería"),
          tabla([["", "Revisión"],
                 ["☐", "Continuidad (batería desconectada): no hay pitido entre 12V y GND del L298N ni entre VIN y GND de la placa."],
                 ["☐", "El interruptor en ON une el rojo del T con los dos naranjas; en OFF, no."],
                 ["☐", "Los jumpers ENA y ENB del L298N están quitados; el de 5V-EN está puesto."],
                 ["☐", "Nada usa la salida de 5V del L298N."],
                 ["☐", "El VCC del bus está en 5V (R3) o en 3V3 (Q)."],
                 ["☐", "Las ruedas giran libres y ningún cable las toca."],
                 ["☐", "El robot mide 120 × 120 mm o menos con las ruedas."]], [10, 166]),
          h2("6.2 Primer encendido"),
          *lista([
              "Sube el código (manual de uso, sección 2) con el interruptor en OFF.",
              "Enciende sosteniendo el botón: modo calibración. La OLED muestra el color y las tres distancias.",
              "Acerca la mano a cada VL53L0X: su distancia debe bajar. Si sale <b>SIN VL53L0X</b>, revisa su XSHUT.",
              "Botón corto: las dos ruedas avanzan. Si una gira al revés, intercambia sus dos cables en el L298N.",
              "Botón largo: gira a la derecha. Si gira a la izquierda, intercambia OUT1-2 con OUT3-4.",
          ], num=True),
          h2("6.3 Aprietes sugeridos"),
          tabla([["Unión", "Apriete"],
                 ["Allen M3 en inserto (todos)", "Firme con el lado corto de la llave; si el inserto gira, cambió de agujero: reponlo"],
                 ["Bornes del L298N", "Firme; jalar cada cable para comprobar"],
                 ["Tuercas del botón y del interruptor", "Con los dedos y un cuarto de vuelta con pinzas"]], [80, 96]),
          h2("6.4 Solo UNO Q: alimentación y cámara"),
          *lista([
              "La Q recibe 7–24 V por VIN. Con la batería por debajo de 7 V queda fuera de rango: recarga a 7.2 V o más.",
              "Prueba <b>sin módulo PD</b>: batería → interruptor → fusible → VIN. Revisa en App Lab que la cámara aparezca.",
              "Si no aparece, el hub no tiene energía: alimenta el hub por su puerto PD (cargador PD o módulo PD opcional: batería → interruptor → "
              "fusible de 3 A → módulo (entrada desde 6 V, salida USB-C 5 V / 3 A) → puerto PD del hub). Ver docs/uno_q.md, sección 7.",
              "No uses módulos «trigger», «decoy» o «señuelo»: consumen en vez de dar energía.",
          ]),
          h1("7. Solución de problemas"),
          tabla([["Síntoma", "Causa probable", "Qué hacer"],
                 ["La OLED no prende", "Interruptor, VIN o bus I2C", "Mide 7–8 V en VIN; revisa los puentes del bus"],
                 ["SIN SENSOR COLOR", "Cable del TCS34725 suelto", "Revisa sus 4 soldaduras y su hoyo en el bus"],
                 ["SIN VL53L0X", "XSHUT o VCC de un sensor", "Revisa A0/A1/A2 y que el dupont siga en el pin"],
                 ["La placa se reinicia al arrancar", "Ruido de motores o batería baja", "Capacitores de 100 nF; carga la batería"],
                 ["Un motor no gira", "Borne flojo o ENA/ENB", "Aprieta OUT y revisa D5/D6"],
                 ["Una rueda roza", "Cable de motor o rueda muy adentro", "Acomoda el cable; saca la rueda 1 mm"],
                 ["El sensor de color baila", "Ranura grande", "Calza con cinta; reimprime con RANURA menor"],
                 ["Q: no aparece la cámara", "Hub sin energía PD (con VIN) o cable USB", "Mide ≥ 4.8 V en el hub; alimenta su puerto PD (6.4)"],
                 ["Q: OLED dice SIN CAM", "La cámara no se encontró al arrancar", "El robot funciona sin ella; revisa lo anterior"],
                 ["Q: I2C no responde o se calienta", "VCC del bus en 5V", "Apaga, pasa el jumper a 3V3 y revisa los pines SDA/SCL"]],
                [48, 56, 72]),
          h1("8. Uso seguro"),
          *lista([
              "La batería es de litio: cárgala con cargador balanceador, sin dejarla sola y nunca por debajo de 6.4 V.",
              "Desconecta el conector T para guardar el robot, programarlo con cambios de cableado o soldar.",
              "No cortocircuites el conector T: un corto en una 2S calienta los cables en segundos.",
              "Revisa cada semana que los bornes estén apretados y que ningún forro de cable esté pelado.",
          ]),
          PageBreak()]

    # Anexo A
    H += [h1("Anexo A. Lista de cables"),
          p("Sale del modelo 3D (chasis.scad): cada cable tiene una ruta y este es su largo aproximado, sin contar los conectores. "
            "Los dupont de 30 cm alcanzan para todos con holgura. Para los cables de calibre 22, corta el largo de la tabla más "
            "30 mm. «Placa» es la UNO R3 o la UNO Q; el VCC del bus es 5V (R3) o 3V3 (Q). Los cables USB son solo Q."),
          tabla([["De", "A", "Color", "Tipo", "Largo (mm)"], *[[c[0], c[1], c[2], c[3], c[4]] for c in cables]],
                [44, 32, 18, 62, 20])]
    construir("manual_ensamble.pdf", "Manual de armado", H)


if __name__ == "__main__":
    escribir_csv()
    manual_ensamble()
    if FALTAN:
        print("Imágenes faltantes:", ", ".join(sorted(FALTAN)))
    for f in os.listdir(AQUI):
        if f.startswith(".tmp_"):
            os.remove(os.path.join(AQUI, f))
