Happenedspice17/sumo-v-ia/(commit log)

2026-10-19 Agrega robot de laberinto para Arduino UNO Q
    Sketch del MCU (motores L298N, encoders, TCS34725, OLED, boton) y app
    Python con camara y flood-fill, mas guia de conexiones y calibracion.
    Claude-Session: https://claude.ai/code/session_017eD8xWXnvZZ2v6m3n2fvhH
2026-10-19 Muestra LISTO al volver al inicio en la primera corrida
    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
2026-10-19 Movimiento por tiempo sin encoders
    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
2026-10-19 Version ATmega328P, VL53L0X en UNO Q y chasis
    - atmega328p/: todo en el MCU, flood-fill, EEPROM, Timer1 de 10 ms
    - uno_q/: movimiento por tiempo con 3 VL53L0X para centrar y frenar;
    la camara adelanta paredes de la celda siguiente
    - chasis/: modelo OpenSCAD parametrico y planos en PDF
    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
    [chasis.scad]
2026-10-25 Evita choque de direccion I2C entre VL53L0X y TCS34725; bateria 18650
    Cada VL53L0X cambia su direccion antes de init(), porque el TCS34725
    tambien responde en 0x29. El sensor de color se inicializa al final.
    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
    [chasis.scad]
2026-10-25 Diagrama de conexiones para Arduino UNO R3
    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
2026-10-25 Piso 3 para mini protoboard, OLED y boton
    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
    [chasis.scad]
2026-10-25 Solo ATmega328P: tolerancias, STL, manuales de ensamble y uso, BOM
    - chasis.scad: holguras para FDM, fijacion de patines y capucha,
    orificios de escuadras, piso 3 sobre headers, pieza de prueba
    - STL exportados en chasis/stl
    - Planos solo para UNO R3
    - Modo calibracion: boton corto avanza una celda, largo gira 90
    - docs/: manual de ensamble, manual de uso y bom.csv
    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
    [bom.csv, capucha_color.stl, chasis.scad, cuna_motor.stl, escuadra_tof.stl, espaciador.stl, patin.stl, piso1.stl]
2026-10-28 Arduino Nano en C++ para Microchip Studio, chasis 120x120 de 2 pisos con sensores deslizables
    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
    [bom.csv, capucha_color.stl, chasis.scad, escuadra_tof.stl, espaciador.stl, piso1.stl, piso2.stl, piso3.stl]
2026-10-28 Modelar pines y conectores de los sensores; reubicar OLED, boton e interruptor sin choques
    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
    [bom.csv, chasis.scad, piso2.stl, prueba.stl]
2026-10-28 Rediseno para headers rectos: bateria sobre el eje, pasillos para conectores de VL53L0X, cunas con avellanados
    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
    [bom.csv, capucha_color.stl, chasis.scad, cuna_motor.stl, piso1.stl, piso2.stl, prueba.stl]
2026-10-28 Pines del OLED en alzados, detalle y manual de ensamble
    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
2026-10-28 Cables modelados con sus rutas, tolerancias A2L, placa para la cama de la X2D y manual de armado paso a paso
    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
    [bom.csv, cables.csv, capucha_color.stl, chasis.scad, cuna_motor.stl, espaciador.stl, patin.stl, piso1.stl]
2026-10-28 Chasis: solo tornillos Allen M3 e insertos de calor
    Columnas y postes del L298N impresos en el piso 1, orejas en cunas y patin
    fuera de bateria/L298N, sin tuercas, separadores ni avellanados. Manual con
    seccion de insertos, BOM y renders actualizados.
    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
    [bom.csv, capucha_color.stl, chasis.scad, cuna_motor.stl, espaciador.stl, patin.stl, piso1.stl, piso2.stl]
2026-10-29 Concepto UNO Q con camara USB en mastil y variante UNO R3
    PLACA = nano | unoq | uno_r3. Piso 2 con 4 postes con inserto para el
    footprint UNO; camara UVC 32x32 en mastil PTR provisional con su campo de
    vision. Columnas traseras a (+-48, -40) para librar el jack y USB-B del R3.
    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
    [chasis.scad, piso1.stl, piso2.stl, placa_x2d.stl]
2026-10-29 Concepto UNO Q: repisa para hub USB y OLED en el mastil
    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
    [chasis.scad]
2026-10-29 Concepto UNO: Proto Shield con mini protoboard para el bus I2C
    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
    [chasis.scad]
2026-10-29 Docs: documento tecnico del robot de laberinto con Arduino UNO Q
    Plan UNO Q (principal) y UNO R3 (respaldo), comunicacion Bridge,
    estrategia de corridas, camara, sensor de color, energia y PD,
    mapa de pines, cambio de placa, ruedas, pruebas y pendientes.
    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
2026-10-29 Pasa la documentacion y el Makefile a Arduino UNO R3
    - README: UNO R3 como placa objetivo, secciones de alimentacion, bus I2C, cableado y cambio R3 <-> UNO Q.
    - config.h: solo comentarios de pines; la logica no cambia.
    - Makefile: puerto por defecto /dev/ttyACM0 y avrdude con m328p.
    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
2026-10-29 UNO Q: mismo mapa de pines que el R3 (D5/D6 PWM, D7-D10, boton D2)
    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
2026-10-29 Guia de programacion para principiantes (R3 con Microchip Studio, UNO Q con App Lab)
    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
2026-10-29 Manual de armado modular: UNO R3 y UNO Q con el mismo chasis
    Pasos 7 a 11 nuevos (piso 2 con placa y Proto Shield, cableado en el shield, paso solo Q), cambio R3 <-> Q, BOM y cables actualizados, manual de uso con App Lab y avrdude para R3. img() dibuja un recuadro gris si falta una imagen.
    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
    [bom.csv, cables.csv]
2026-10-29 Chasis modular UNO R3 / UNO Q: cableado completo al shield, clip del OLED, pasos 7-11, vistas y STL
    PLACA por defecto uno_r3; piso2 y demas piezas comunes identicas para R3 y Q.
    Tiras hembra en el shield, bus I2C en 4 columnas, 37 cables de arriba con rutas
    sin choques (verificadas con intersecciones en OpenSCAD), repisa, cabeza de camara
    y clip del OLED solo para la Q.
    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
    [cabeza_camara.stl, capucha_color.stl, chasis.scad, clip_oled.stl, cuna_motor.stl, patin.stl, piso1.stl, piso2.stl]
2026-10-29 Regenera manuales y planos con el CAD modular R3/UNO Q
    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
    [cables.csv]
2026-10-29 UNO Q: driver OLED propio (Adafruit_SSD1306 no compila en Zephyr)
    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
2026-10-29 UNO Q: fijar version de OpenCV
    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
2026-10-29 UNO Q: OpenCV ya viene en la imagen base, quitar de requirements
    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
2026-10-29 UNO Q: mensaje de arranque en Python
    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
2026-11-01 Instala skills de Ponytail a nivel proyecto
    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
2026-11-07 Soporte VL53L0X mas firme: ranura 1.8 y postes que abrazan 4 mm de cada oreja
    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
    [chasis.scad, piso1.stl, placa_x2d.stl, prueba.stl]
2026-11-07 Soporte VL53L0X: tornillo M2x8 por cada oreja ademas de la ranura
    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
    [chasis.scad, piso1.stl, placa_x2d.stl, prueba.stl]
2026-11-07 TOF_AG confirmado con plano de UNIT
    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
    [chasis.scad]
2026-11-07 Soporte VL53L0X: tornillo M3x8 (la oreja del sensor pasa M3)
    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
    [chasis.scad, piso1.stl, placa_x2d.stl, prueba.stl]
2026-11-07 Medidas reales: rueda 45x17, motor 26.11x11.94x11.94, pila 70 mm
    Sensores laterales y columnas delanteras se mueven para librar la rueda grande.
    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
    [capucha_color.stl, chasis.scad, cuna_motor.stl, patin.stl, piso1.stl, piso2.stl, placa_q.stl, placa_x2d.stl]
2026-11-07 Regenera planos y manuales con las medidas reales; tornillos de VL53L0X en el manual
    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
    [bom.csv, cables.csv]
2026-11-07 renders: etiquetas en progreso para las medidas nuevas
    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
2026-11-07 Soportes de VL53L0X como piezas aparte (2 M3x8 + insertos), columnas delanteras a (32, 55.5)
    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
    [chasis.scad, piso1.stl, piso2.stl, prueba.stl, soporte_tof.stl]
2026-11-07 Regenera STL, imagenes y manuales con soportes de VL53L0X aparte
    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
    [bom.csv, cables.csv, placa_x2d.stl]
2026-11-07 Piso 2 igual al ya impreso; solo cambian los 2 agujeros delanteros
    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
    [chasis.scad, piso2.stl, placa_q.stl, repisa.stl]
2026-11-07 Piso 2 igual al ya impreso (ranuras y postes de repisa); solo cambian los 2 agujeros delanteros
    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
    [cables.csv, placa_x2d.stl]
2026-11-07 Diagrama de conexiones (R3 y Q)
    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
2026-11-07 TOF_AG: altura del agujero medida desde el borde de los pines
    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
    [chasis.scad]
2026-11-07 VL53L0X medido: 11 mm de alto, agujero a 5.5 del borde de los pines
    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
    [chasis.scad, placa_x2d.stl, prueba.stl, soporte_tof.stl]
2026-11-07 Camara: busca el primer /dev/video que capture
    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
2026-11-07 Motor medido 12x11: cuna, patin y capucha regenerados
    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
    [capucha_color.stl, chasis.scad, cuna_motor.stl, patin.stl, piso1.stl, prueba.stl]
2026-11-07 Soporte ToF: agujero 1.5 mm mas arriba; cuna motor con 0.1 por lado
    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
    [chasis.scad, cuna_motor.stl, soporte_tof.stl]
2026-11-07 Cuna motor: hueco de 12 exacto
    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
    [chasis.scad, cuna_motor.stl]
2026-11-07 OLED en la cabeza de la camara, de pie, header recto por encima de la manga; quita el clip
    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
    [cabeza_camara.stl, chasis.scad, clip_oled.stl]
2026-11-07 Mastil 2020: cabeza con hueco de 20 y opresor M3, piso2 con agujero M5
    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
    [cabeza_camara.stl, chasis.scad, piso2.stl]
2026-11-07 Cuna motor: hueco de 12.05
    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
    [chasis.scad, cuna_motor.stl]
2026-11-07 Soporte ToF: bloque con 2 insertos, M3x10 por el frente (sin ranura)
    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
    [chasis.scad, soporte_tof.stl]
2026-11-07 Soporte ToF: insertos de abajo al centro del bloque
    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
    [chasis.scad, piso1.stl, soporte_tof.stl]
2026-11-07 Soporte ToF: muesca para la columna delantera del piso 1
    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
    [chasis.scad, soporte_tof.stl]
2026-11-07 Cuna motor: hueco de 11.85
    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
    [chasis.scad, cuna_motor.stl]
2026-11-07 Cuna motor: hueco de 11.9
    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
    [chasis.scad, cuna_motor.stl]
2026-11-07 Soporte ToF: bloque 6 mm mas ancho, mas pared en los insertos
    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
    [chasis.scad, soporte_tof.stl]
2026-11-07 Soporte ToF: 2.2 mm de pared en insertos sin chocar con el piso 1
    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
    [chasis.scad, soporte_tof.stl]
2026-11-07 Soporte ToF: torres a los lados hasta el tope de la placa, centro libre para dupont
    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
    [chasis.scad, soporte_tof.stl]
2026-11-08 UNO Q: opcion para correr sin camara
    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
2026-11-08 UNO Q: OLED muestra si Python responde (PY n) y la ultima orden
    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
2026-11-08 Manual de uso y calibracion del robot (UNO Q)
    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
2026-11-08 Manual tecnico para jueces
    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
2026-11-08 Prompt para pasar los manuales a PDF imprimible
    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
2026-11-08 Pedestal impreso 20x20x75 (M5 desde abajo) y STL de repisa y piso 2
    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
    [chasis.scad, pedestal.stl, piso2.stl, repisa.stl]
2026-11-08 Activa la camara (USAR_CAM = True)
    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
2026-11-08 Print de lo que ve la camara
    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
2026-11-08 Dashboard web para calibrar colores (puerto 7000)
    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
2026-11-08 Regenera STL de la cabeza de camara + OLED
    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
    [cabeza_camara.stl]
2026-11-08 Dashboard: asistente paso a paso para calibrar colores
    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
2026-11-08 Pedestal: inserto de calor M4
    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
    [chasis.scad, pedestal.stl]
2026-11-08 Cabeza camara: agujeros M2 y ventana de 22 mm para el conector USB
    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
    [cabeza_camara.stl, chasis.scad]
2026-11-08 Cabeza camara: marco para PCB de 32 y agujeros M2 con 1 mm de juego
    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
    [cabeza_camara.stl, chasis.scad]
2026-11-08 Dashboard: vista de la camara en baja calidad con las regiones de pared
    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
2026-11-09 Cabeza camara: placa 12 mm arriba (atras libre), costillas, hueco USB arriba-izq y paso de alimentacion abajo
    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
    [cabeza_camara.stl, chasis.scad]
2026-11-09 Docs al dia: panel web de colores, vista de camara, pedestal M4, cabeza nueva, hub con PD; PDFs regenerados
    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
    [bom.csv, cables.csv]
2026-11-10 UNO Q: invertir motores por software (INV_IZQ, INV_DER)
    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
2026-11-10 Camara: regiones configurables hasta 2 celdas adelante, tambien por encima de la pared de enfrente
    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
2026-11-10 Camara pre-revisa marcas de color en la celda siguiente; el sensor confirma. Filtro de brillo para piso negro. META centrada segun N
    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
2026-11-10 Laberinto 11x11 (meta = celda central), modo tonto de pared derecha con cambio a mapa si hay isla; selector en el panel
    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
2026-11-10 Los VL53L0X mandan: revisan el frente antes de avanzar y corrigen el mapa; la camara solo encarece caminos (PESO_CAM). Ignora mapas de otro tamano
    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
2026-11-10 Odometria ligera: bordes de pared y frontal corrigen posicion y velocidad en el sketch; la camara mide la pared de enfrente con la geometria del CAD y ajusta cada avance; panel muestra donde esta
    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
    [sketch.ino]
2026-11-10 Confia en los ToF: el frontal limita cuantas celdas avanza; la camara solo corrige si el frontal no ve nada; vista en vivo de los ToF en el panel
    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
    [sketch.ino]
2026-11-10 Pared al frente a menos de 130 mm (PARED_F), de 140 para arriba no hay
    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
2026-11-10 Frena al acercarse a la pared y retrocede si queda muy pegado; panel ToF simula que haria el robot
    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
2026-11-10 Solo modo tonto: sigue la pared con los ToF sin mapa; si rodea una isla prueba con la izquierda
    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
2026-11-10 Panel: texto de Que haria mas claro (gira 90 grados, no va de frente)
    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
2026-11-10 Sketch: si hay pared enfrente y la distancia ya no baja en 300 ms, se detiene (no empuja la pared)
    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
2026-11-10 Frontal: se detiene al leer 130 mm y retrocede si baja de 120 (D_FRENTE = 130); frena desde 230 mm
    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
2026-11-10 Python: datos en /app/datos, escritura atomica y lectura tolerante (un json vacio ya no tumba la app)
    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
2026-11-10 Explora sin fin hasta el amarillo (sensor + camara), celda menos visitada entre las libres; RPC alto; D2 detiene
    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
2026-11-10 Camara guia hacia el amarillo: si lo ve a la izq/frente/der y los ToF dejan, va hacia alla
    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
2026-11-10 Camara solo desempata entre salidas igual de visitadas; los ToF y las visitas mandan
    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
2026-11-10 Camara cubre los puntos ciegos de los ToF (diagonales de enfrente, geometria del CAD) y suple al frontal sin lectura
    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
2026-11-11 Colores calibrados como valores de fabrica
    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
2026-11-11 Pagina web reintenta abrir la camara si se conecto despues de arrancar
    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
2026-11-11 api/foto: bool de Python en vez de numpy.bool (FastAPI no lo serializa)
    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
2026-11-11 API: limpio() pasa numpy a tipos de Python antes de responder
    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
2026-11-11 Al arrancar busca la camara hasta 30 s
    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
2026-11-11 Si no hay camara al arrancar la sigue buscando en segundo plano hasta encontrarla
    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
2026-11-11 Manuales: camara (busqueda, alimentacion del hub), colores de fabrica, web por WiFi, contrasena olvidada
    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
2026-11-11 Camara: la busqueda no bloquea el arranque (App.run arranca de inmediato)
    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
2026-11-11 Hilo vigilar_cam: revisa cada 2 s la camara y la reconecta si se desconecta
    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
2026-11-11 Alinea con giros de 5 grados, centrado con rumbo, mano derecha, frente libre desde 220 mm y camara a 40 grados
    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
    [cabeza_camara.stl, chasis.scad]
2026-11-11 Sin giros de 5 grados: avanza derecho con 150 mm libres y solo corrige si un lateral lee menos de 90 mm
    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
    [sketch.ino]
2026-11-11 Avance por distancia con el frontal; Python decide con 3 muestras de los 3 ToF y la camara solo busca amarillo
    Claude-Session: https://claude.ai/code/session_01CEStz9Lnp2zBm8QU3Gib3d
2026-11-11 Regla de la mano izquierda
    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
2026-11-11 Mapa por colores y paredes con ruta corta, camara blanco/negro, frente primero y paro en cambios bruscos de los ToF
    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
2026-11-11 Maquina de estados, mapa con votos, frente libre a 220 mm, alto en amarillo desde el STM32 y web sin Bridge en corrida
    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
2026-11-11 MPU-6050 opcional: giros por angulo y rumbo sostenido en recta; sin el sigue por tiempo
    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
2026-11-11 Docs: manual de uso al estado actual (OLED con fases, boton, web, MPU-6050, tabla de fallas)
    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
2026-11-11 Docs: manual tecnico al estado actual del codigo (distancia, saltos, MPU, maquina de estados, mapa con votos, camara)
    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
2026-11-11 md_pdf.sh: genera tambien la bitacora de diseno
    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
2026-11-11 Docs: bitacora de diseno (historial_cambios.md) con etapas, pruebas, decisiones de ingenieria y analisis del grafo; PDFs regenerados
    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
2026-11-11 Docs: pruebas en pista reales del equipo en la bitacora, OTG y montaje vertical en uno_q.md; PDFs regenerados
    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
2026-11-11 Calibracion de los VL53L0X desde la web: recta real = a*crudo + b por sensor con puntos medidos, guardada y mandada al STM32
    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
2026-11-11 Docs: la pagina web como herramienta central de calibracion (colores, distancia, simulador, camara) en manuales y bitacora; PDFs regenerados
    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
2026-11-11 Sketch sin MPU-6050 como version aparte (sketch_sin_mpu/), junto a la version con MPU
    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
2026-11-11 README nuevo con equipo, arquitectura y decisiones; quita documentos desactualizados
    Se borran docs/manual_uso.pdf (manual viejo R3+Q que chocaba con docs/pdf/manual_uso.pdf),
    docs/prompt_pdf.md y el __pycache__ subido por error. Integrantes en README y en la portada de los PDF.
    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
    [generar_manuales.py]
2026-11-11 Cámara: innomaker U20CAM-9281M (OV9281 mono, obturador global) en BOM, CAD y manuales
    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
    [bom.csv, chasis.scad]
2026-11-11 Cámara monocromática: quita la búsqueda de amarillo, blanco por umbral de gris
    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
2026-11-11 Pendientes: calibrar ToF en pista antes de la distancia por cámara
    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
2026-11-11 sketch: MPU_ADDR en vez de MPU (choca con la macro MPU de CMSIS y no compilaba)
    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
2026-11-11 Python: busca la cámara solo en los /dev/video que existen y sin llenar el log de WARN
    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
2026-11-11 Python: prints de debug en el arranque, error de RPC una vez y traceback si truena
    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
2026-11-11 Cámara: ganancia ajustable y lectura de lo que la cámara aplicó (exposición/modo)
    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
2026-11-11 ToF: calibración de un punto a 100 mm (solo desfase), reemplaza la anterior
    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
2026-11-11 Bitácora: razón de la calibración de un punto
    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
2026-11-11 Mano izquierda pura, AJUSTE_DER -10 y alto al frente a 10 mm
    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
2026-11-11 Exploración completa (Trémaux/DFS) para la meta al centro; frenado a 35 mm; contraste y sensibilidad de la cámara
    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
2026-11-11 Python: ToF frescos tras girar, pasos recorridos cuentan como libres, salida del laberinto, sin WARN de cámara
    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
2026-11-11 Web: iniciar, detener y borrar el mapa desde la página
    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
2026-11-11 Cronómetro y registro de colores en la web; alinear() con MPU antes de avanzar (3 a 45 grados)
    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
2026-11-11 MPU: choques (acelerómetro), giro atorado, verificación de giros y robot levantado
    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
2026-11-11 Un solo sketch con MPU: se retira sketch_sin_mpu (commit 2e01996); manuales, diagrama y BOM con el MPU-6050
    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
    [bom.csv]
2026-11-11 Centrado en el carril con la geometría del CAD (D_FRENTE 30, D_LADO 41), deriva del MPU con las paredes, choque: retrocede más y se aleja de la pared
    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
2026-11-11 Choque solo si el robot dejó de avanzar (golpe + frontal sin bajar 250 ms); carril solo con pared a menos de 35 mm
    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
2026-11-11 Pasillos de un tiron sin parar en cada celda; golpe de choque a 1.5 g
    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
2026-11-11 README de uno_q: choques confirmados a 1.5 g y pasillos de un tiron
    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
2026-11-12 Rediseño de la documentación: portada, índice, cajas, diagramas y PDF
    - Plantilla pandoc con portada (equipo, materia, fecha, versión) e índice enlazado
    - CSS de impresión: acento verde, Inter + JetBrains Mono, tablas sombreadas,
    cajas En corto / Tip / Cuidado / Checklist / Ajuste rápido, figuras numeradas
    - md_pdf.js renderiza Mermaid (fijado en docs/package.json) antes de imprimir
    - Figuras: arquitectura, conexiones, máquinas de estados, exploración,
    línea de tiempo, robot visto desde arriba (SVG) y umbrales de choque (SVG)
    - Manual de uso por tareas; técnico como referencia con tabla de parámetros
    (nombre, valor, unidad, qué hace, cuándo cambiarlo); glosarios
    - Bitáco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
2026-11-12 Capturas antes/después de los PDF para el PR
    Claude-Session: https://claude.ai/code/session_01CEStz9FV5SQ5Fezig3e9sw
2026-11-12 Manual para jueces (3 páginas)
    Resume el proyecto y lo que lo distingue: dos procesadores con parada
    autónoma en el STM32, máquina de estados, votos, exploración completa,
    avance sin encoders con geometría del CAD, MPU-6050 (choque confirmado,
    rumbo absoluto) y cámara monocromática. Se genera con md_pdf.sh.
    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
2026-11-12 Manual para jueces: 10 páginas para imprimir a doble cara y engargolar
    Portada con render del CAD, cifras clave y un capítulo por página:
    arquitectura, hardware, movimiento sin encoders, MPU-6050, cámara
    monocromática, exploración, calibración desde el celular y lecciones.
    Márgenes laterales iguales de 20 mm para el engargolado en ambas caras.
    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
2026-11-12 Exploracion hacia el centro (esquina al azar, 11x11) y camara apagada
    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
2026-11-12 Simulacion 2D de 200 laberintos; reglas: cuenta solo lo que cabe, centrar con la pared, KD 0, TRAS_SALTO 110, RANGO 600, esquiva postes
    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
2026-11-12 Toma el lateral que se acaba de abrir si lleva a una celda sin ver
    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
2026-11-12 Brujula: explora sin mapa de paredes (giroscopio + centro + castigo + azar); calibrar avance de 10 cm desde la web
    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
2026-11-12 Simulador: variante CONOCE (esquina elegida por el usuario)
    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
2026-11-12 Pista real de las fotos en el simulador (pista.py) y resultados por esquina
    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
2026-11-12 Simulador: amarillo del tamano real (13.5 x 15 cm, corrido) y mapa verificado por el equipo
    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
2026-11-12 Manuales rehechos con la estrategia actual (revisión B8)
    - Jueces (10 págs): autolocalización en la pista y simulador 2D como ejes;
    avance con centrar, bug del avance hallado en simulación; cámara apagada
    - Técnico: capítulo 9 reorganizado (pista con autolocalización, brújula,
    Trémaux, simulación), figuras de la pista y de la localización de Markov
    - Uso: salida en cualquier esquina, fallas nuevas, mapa de la pista
    - Bitácora: línea de tiempo con etapas 36 a 52; README de uno_q al día
    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
2026-11-12 README: estrategia actual, manual para jueces, cámara apagada, simulador
    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
2026-11-13 Pista: el frontal ve puntas de pared; re-ubica en vez de rendirse
    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
2026-11-13 Pista: hasta 10 perdidas; un avance negativo ya no vacia la localizacion; orden de partida en el simulador
    Claude-Session: https://claude.ai/code/session_01CEStz95MseS83J47XBjj8y
2026-11-13 uno_q_v2: confia en las paredes, no en los mm (orillas por umbral, centrado de carril, frontal de cerca, rumbo con una pared, ruta segura, grabacion cruda y repite.py)
    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
2026-11-13 Registro: delega isatty y demas a la salida real (la WebUI no arrancaba)
    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
2026-11-13 v2: camara encendida solo para verla en la web (CAM_ACTUA = False: no mueve al robot)
    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
2026-11-13 v2: camara como mapa del piso (celdas libres al frente y pared/abertura adelante) para ubicarse; camara en el simulador; calibrar inclinacion desde la web
    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
2026-11-13 v2 tras la primera corrida en pista: reloj monotono, signo del giroscopio guardado, rumbo por pared hasta 30 grados, mapa fijo, sin medias vueltas en cadena, filtro de reflejos y camara en sombra
    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
2026-11-13 v2: ajuste entre motores que se aprende solo entre avances (el robot se iba a la izquierda con la correccion al tope)
    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
2026-11-14 Video y animacion de la corrida de competencia (2:06.4, 2.o lugar): reconstruccion del recorrido a partir del registro
    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
    [corrida2.csv]
